impatrq/revcontrol/README.md

<p align="center"> 

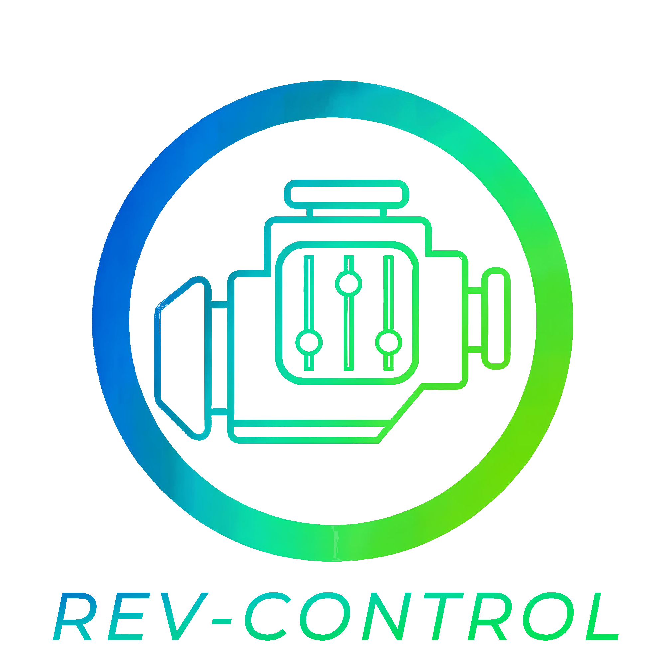
[picture p1: Imagenes/LOGO REV CONTROL OFICIAL2.png]
Logo REV CONTROL OFICIAL


</p>

## ¿QUE ES REV-CONTROL?
**REV-CONTROL ES UN BANCO DE PRUEBA PORTATIL DONDE SON TOMADOS LOS PARAMETROS DE UN MOTOR.**

## OBJETIVO
**EL OBJETIVO DE ESTE PROYECTO ES PRINCIPALMENTE DAR UNA ALTERNATIVA MAS ACCESIBLE PARA LOS TECNICOS. ESTO MEDIANTE NUESTRO SISTEMA DE AMPLIFICACION Y FILTRACION DE LA INFORMACION SENSADA Y POSTERIORMENTE PROCESADA DIGITALMENTE Y EXHIBIENDO LOS PARAMETROS LEIDOS EN UNA INTERFAZ AMIGABLE CON EL USUARIO** 

## UTILIDADES
**PUEDE MEDIR LOS SIGUIENTES PARAMETROS:**

**- REVOLUCIONES POR MINUTO**

**- PRESION Y TEMPERATURA DE ACEITE**

**- TEMPERATURA DE CABEZA DE CILINDRO**

**- TEMPERATURA DE AGUA**

**- % DE CONCENTRACION DE O2**

## VENTAJAS
**-TENER UNA MEJOR VISUALIZACION DE LOS PARAMETROS MENCIONADOS GRACIAS A LA INTERFAZ DIGITAL**

**-COMO METODO DE SEGURIDAD SE VA A INDICAR EN LA INTERFAZ CUANDO LOS PARAMETROS NO ESTEN EN ESTADO OPTIMO; ADEMAS EN EL DISPOSITIVO FISICO VAN A HABER INDICACIONES MEDIANTE INDICADORES COMO UN SEGUNDO METODO PARA ENTERARSE DE ESTOS FALLOS**

<div alig = "center">

| Email | Instagram | Página Web |
|---|---|---|
|revcontrol33@gmail.com|[@rev.control](https://www.instagram.com/rev.control/?next=%2F&hl=es)|[REV-CONTROL](https://impatrq.github.io/revcontrol/)

</div>

## INTEGRANTES
### MARTINEZ, MARCOS CALEB
- 📧 marcoscalebmartinez@gmail.com
- 📷 [marcoos_caleb](https://www.instagram.com/marcoos_caleb/)

### ACOSTA, GONZALO EMMANUEL
- 📧 gonza7.gea@gmail.com
- 📷 [gonzaa.acostaa](https://www.instagram.com/gonzaa.acostaa/)

### FLORES, SANTIAGO MARTIN
- 📧 santiflo06@gmail.com
- 📷 [santiflors_](https://www.instagram.com/santiflors_/)

### HE, LEONAREDO YU XING
- 📧 leonardohe295@gmail.com 
- 📷 [leoo_hee](https://www.instagram.com/leoo_hee/)

### IBACETA, TADEO EZEQUIEL
- 📧 tutibaceta@gmail.com
- 📷[tadeooibaceta](https://www.instagram.com/tadeooibaceta/)

### QUINTERO, JUAN 
- 📧 juanquinte2006@gmail.com
- 📷 [juann_quinte2](https://www.instagram.com/juann_quinte2/)

### ALFARO, LAUTARO NAHUEL
- 📧 lautialfaro6@gmail.com
- 📷 [lautaroalfaro14](https://www.instagram.com/lautaroalfaro14/)

## FOTO GRUPAL

<p align ="center"> 
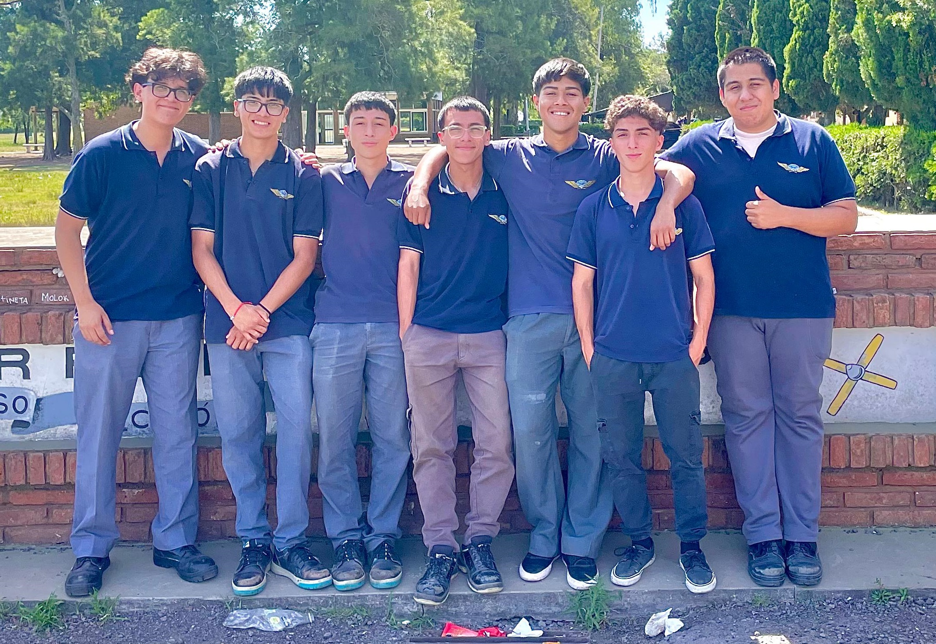
[picture p2: Imagenes/Integrantes.jpeg]
