impatrq/revcontrol/Diseños de marca/README.md

Diseños de Marca

Esta carpeta contiene los recursos visuales esenciales para la identidad de la marca.
Incluye los logos principales y sus variantes, diversos diseños gráficos como banners y mockups, así como fotografías oficiales de los integrantes del equipo, destinadas a materiales promocionales.
