impatrq/revcontrol/Electronica/README.md

Electrónica

Esta carpeta contiene toda la información y los recursos relacionados con los aspectos electrónicos del proyecto. Incluye circuitos, diagramas y diseños utilizados en el desarrollo, implementación y documentación de los sistemas electrónicos.
