impatrq/revcontrol/Estructura/README.md

Estructura

Esta carpeta alberga todos los recursos relacionados con la construcción y desarrollo físico del proyecto. Contiene planos detallados, fotos de materiales utilizados, imágenes que documentan el progreso realizado y fotografías de los prototipos desarrollados.
