impatrq/revcontrol/Estructura/Colocación de placas en los acrilicos/README.md

Colocamos las placas utilizando tornillos de 2mm, un soporte hecho en impresora 3D y para que no quede flojo le pusimos una tuerca
