impatrq/revcontrol/Documentación/Reuniones Diarias/Reunión diaria #17 revcontrol .docx

# Reunión diaria #17 - 19/06/2024

# Miembros presentes:

- ~~IBACETA, Tadeo Ezequiel~~
- FLORES, Santiago Martin ,
- QUINTERO, Juan
- ~~HE, Leonardo Yu xing~~
- ~~ALFARO,Lautaro Nahuel~~
- ~~ACOSTA, Gonzalo Emmanuel~~
- ~~MARTINEZ, Marcos Caleb~~

Disclaimer: Cada uno de los integrantes debe completar esto

# Trabajo actual


Disclaimer: Cada uno de los integrantes debe completar esto

# Expectativa del día:

1. ALFARO: desarrollo del programa de medición de RPM.
2. Martinez Marcos: Revisión de amplificador de termocupla
3. Ibaceta Tadeo Ezequiel: Agregar al código los cálculos de los distintos parámetros(Por el momento, los de temperatura).
4. He Leonardo Yu Xing: rehacer circuito de termocupla
5. Acosta: modificando diseño de aplicación.

# Observación:

Durante las anteriores semanas pudimos adaptar el programa para que lea los distintos canales de ADC.
