impatrq/revcontrol/Estructura/Modulo de lectura/Etiquetas para modulo de lectura.pdf

# CILINDRO 1

# CILINDRO 2

# CILINDRO 3

# CILINDRO 4

# TEMP. AGUA

# TEMP. ACEITE

# PRES. ACEITE

# SONDA LAMBDA

# CUENTA REVOLUCIONES

Etiqueta Técnica - REV Control

•Voltaje de Alimentación: 12V DC •Consumo Total: 803 mA
•Potencia Máxima: 9.98W
•Autonomía: 8.7 horas (con batería de 12V, 7Ah)
•Componentes Clave y Consumo:
•Circuito Comparador (LM311): 0.18W •Amplificador AD620: 0.72W •Módulo de Relevadores: 3.60W •Monitor Kinseal: 4.80W
•Microcontrolador LPC845: 0.165W Características adicionales: •Operación portátil y eficiente. •Sistema de alarmas integrado. •Interfaz gráfica con monitor táctil.
