impatrq/revcontrol/Electronica/Esquemas y Modelo 3D Incluido/Tablas de conexiones/Conexiones de Termistores.xlsx

Conexiones Termistor de agua A (MAX31865) |  |  | Conexiones Termistor de agua B (MAX31865) |  |  | Conexiones Termistor de aceite (MAX31865)
Pin de entrada | Pin de salida | Ubicación | Pin de entrada | Pin de salida | Ubicación | Pin de entrada | Pin de salida | Ubicación
RTD+ | Bornera | Termistor de agua B | RTD+ | Bornera | Termistor de agua A | RTD+ | Bornera | Termistor de aceite
RTD- | Bornera | Termistor de agua B | RTD- | Bornera | Termistor de agua A | RTD- | Bornera | Termistor de aceite
F+ | Bornera | Termistor de agua B | F+ | Bornera | Termistor de agua A | F+ | Bornera | Termistor de aceite
3v3 | 3.3V | Bornera 3.3 | 3v3 | 3.3V |  | 3v3 | 3.3V | Bornera 3.3
CLK | PIO0_18 | LPC845 | CLK | PIO0_18 | LPC845 | CLK | PIO0_18 | LPC845
SDO | PIO0_20 | LPC845 | SDO | PIO0_20 | LPC845 | SDO | PIO0_20 | LPC845
SDI | PIO0_21 | LPC845 | SDI | PIO0_21 | LPC845 | SDI | PIO0_21 | LPC845
CS | PIO0_01 | LPC845 | CS | PIO0_00 | LPC845 | CS | PIO0_04 | LPC845
GND | Masa | Bornera 3.3 | GND | Masa |  | GND | Masa | Bornera
