impatrq/revcontrol/Electronica/Esquemas y Modelo 3D Incluido/Tablas de conexiones/Conexiones de Termocuplas.xlsx

Conexiones Termocupla 1 (MAX6675) |  |  | Conexiones Termocupla 2 (MAX6675) |  |  | Conexiones Termocupla 3 (MAX6675) |  |  | Conexiones Termocupla 4 (MAX6675)
Pin de entrada | Pin de salida | Ubicación | Pin de entrada | Pin de salida | Ubicación | Pin de entrada | Pin de salida | Ubicación | Pin de entrada | Pin de salida | Ubicación
VCC | 5 V | Step Down | VCC | 5 V | Step Down | VCC | 5 V | Step Down | VCC | 5 V | Step Down
GND | Masa | Step Down | GND | Masa | Step Down | GND | Masa | Step Down | GND | Masa | Step Down
SO | PIO0_08 | LPC845 | SO | PIO0_08 | LPC845 | SO | PIO0_08 | LPC845 | SO | PIO0_08 | LPC845
SCK | PIO0_18 | LPC845 | SCK | PIO0_18 | LPC845 | SCK | PIO0_18 | LPC845 | SCK | PIO0_18 | LPC845
CS | PIO0_10 | LPC845 | CS | PIO0_19 | LPC845 | CS | PIO0_17 | LPC845 | CS | PIO0_13 | LPC845
T+ | Bornera | Termocupla positiva | T+ | Bornera | Termocupla positiva | T+ | Bornera | Termocupla positiva | T+ | Bornera | Termocupla positiva
T- | Bornera | Termocupla negativa | T- | Bornera | Termocupla negativa | T- | Bornera | Termocupla negativa | T- | Bornera | Termocupla negativa
