impatrq/revcontrol/Electronica/Esquemas y Modelo 3D Incluido/Tablas de conexiones/Conexiones LPC845.xlsx

Conexiones LPC845 BRK (Master)
Pin de entrada | Pin de salida | Ubicación
VDD | Batería (+) | Bornera de alimentación
GND | Batería (-) | Bornera de alimentación
PIO0_10 | CS | T1C
PIO0_19 | CS | T2C
PIO0_17 | CS | T3C
PIO0_13 | CS | T4C
PIO0_01 | CS | TCAA
PIO0_00 | CS | TCAB
PIO0_04 | CS | TC0
PIO0_17 | SO | Todas las Termocuplas y Termistores
PIO0_21 | SDI | Todas las Termocuplas y Termistores
PIO0_18 | SCK | Todas las Termocuplas y Termistores
PIO0_23 | OUT | Divisor de voltaje
PIO0_06 | OUT | Acondicionador de señal
PIO0_14 | OUT | Circuito comparador
PIO0_26 | IN 1 | Placa de relés (8 canales)
PIO0_27 | IN 2 | Placa de relés (8 canales)
PIO0_28 | IN 3 | Placa de relés (8 canales)
PIO0_29 | IN 4 | Placa de relés (8 canales)
PIO0_30 | IN 5 | Placa de relés (8 canales)
PIO0_31 | IN 6 | Placa de relés (8 canales)
PIO0_09 | IN 7 | Placa de relés (8 canales)
PIO0_15 | IN 8 | Placa de relés (8 canales)
PIO0_11 | IN 1 | Placade Rele ( 1 canal)
