impatrq/revcontrol/Electronica/Esquemas y Modelo 3D Incluido/Tablas de conexiones/CONEXIONES SENSOR DE PRESION DE ACEITE.xlsx

Componente | Pin/Terminal
Conector IN | 1 (+), 2 (IN), 3 (-)
Resistor R4 | Entre IN y RV2
Potenciómetro RV2 | Un terminal a GND, otro a R4
Salida PIO0_23 | Salida hacia PIO0_23
