impatrq/revcontrol/Electronica/Esquemas y Modelo 3D Incluido/Tablas de conexiones/CONEXIONES SENSOR RPM.xlsx

Componente | Pin/Terminal
LM311 (U2) | 8 (Vcc), 4 (GND), 3 (-), 2 (+), 1 (Salida)
Potenciómetro (POT) | Terminal 1: +5V, Terminal 2: Entrada no inversora (2 del LM311), Terminal 3: GND
Resistencia (R1) | Un extremo a GND, otro extremo a entrada no inversora (3 del LM311)
Resistencia (R2) | Terminal 1: +5V, Terminal 2: Colector del transistor
Resistencia (R3) | Un extremo conectado a PIO0_14, otro a GND
Diodo LED | Ánodo conectado a +5V, cátodo a entrada del regulador (U4)
Regulador (U4) | Pin 1 (IN): +5V, Pin 2 (OUT): Alimenta el circuito, Pin 3 (GND): Tierra
Transistor | Colector: Resistencia R2, Emisor: Tierra, Base: Salida de LM311
Entrada de señal | Terminal positivo y negativo: Terminales de entrada del LM311
