impatrq/revcontrol/Documentación/README.md

Documentación

Esta carpeta contiene toda la información relacionada con la gestión y operación del proyecto. Incluye reportes y documentos generados durante actividades en terreno, información técnica y especificaciones del proyecto, actas y resúmenes de reuniones diarias, así como archivos administrativos como presupuestos y otros registros importantes.
