impatrq/revcontrol/Pagina web/README.md

Página Web

Esta carpeta contiene los recursos utilizados en la creación de la página web, incluyendo los diseños de interfaz, modelos, texturas, y todo el código fuente (HTML, CSS, JavaScript y otros lenguajes relacionados).

Puedes acceder a la página web en el siguiente enlace: https://impatrq.github.io/revcontrol/.
