impatrq/revcontrol/Software Rev-Control/README.md

Software

Esta carpeta contiene toda la programación utilizada en el proyecto, desde el prototipo inicial hasta el código final. Incluye todos los archivos fuente, scripts, y cualquier otra pieza de código que haya sido parte del desarrollo del proyecto.
