impatrq/revcontrol/Documentación/Documentación técnica/Carpeta Tecnica Oficial - RevControl 18-11-24/main.tex

\documentclass[a4paper,12pt]{report}
% Paquetes necesarios para el documento
\usepackage{tikz}           % Para hacer diagramas
\usetikzlibrary{shapes.geometric, arrows.meta, positioning}
\usepackage{calc}           % Para realizar cálculos
\usepackage{float}          % Posición exacta de tablas e imágenes
\usepackage{hyperref}       % Enlaces dentro del PDF
\usepackage{pdfpages}       % Insertar PDFs
\usepackage{graphicx}       % Insertar gráficos e imágenes
\usepackage{tabularray}     % Tablas avanzadas
\usepackage{lscape}         % Páginas en orientación apaisada
\usepackage[spanish]{babel} % Configuración de idioma español
\usepackage{fancyhdr}       % Encabezados y pies de página
\usepackage{tocloft}        % Personalizar tabla de contenidos
\usepackage{setspace}       % Configurar espaciado
\usepackage{eso-pic}        % Insertar elementos de fondo
\usepackage{ragged2e}       % Control de alineación de texto
\usepackage{titlesec}       % Configuración de títulos de sección
\usepackage[table,xcdraw]{xcolor} % Colores avanzados
\usepackage{listings}       % Código fuente
\usepackage{rotating}       % Rotación de objetos
\usepackage[export]{adjustbox} % Ajuste de tamaño de imágenes
\usepackage{pdflscape}      % Orientación apaisada para algunas páginas
\usepackage{subcaption}     % Subfiguras
\usepackage{array}          % Tablas avanzadas
\usepackage{appendix}       % Apéndices
\usepackage{tabularx}       % Tablas con ancho fijo
\usepackage{enumitem}       % Listas personalizadas

% Definición de colores personalizados
\definecolor{celeste_rev}{HTML}{045bce}
\definecolor{verde_rev}{HTML}{52df28}
\definecolor{codeyellow}{rgb}{1,1,0}
\definecolor{codegreen}{rgb}{0,1,0}
\definecolor{codeblue}{rgb}{0.6,0.8,1}
\definecolor{backcolour}{rgb}{0.1,0.1,0.3}

% Configuración de hipervínculos
\hypersetup{
    colorlinks=true,
    linkcolor=celeste_rev,
    filecolor=red,
    urlcolor=verde_rev,
    pdftitle={Carpeta Técnica Rev-Control},
    pdfpagemode=FullScreen
}

% Definición del estilo para código fuente
\lstdefinestyle{mystyle}{
    backgroundcolor=\color{backcolour},
    commentstyle=\color{codegreen},
    keywordstyle=\color{codeyellow},
    numberstyle=\tiny\color{backcolour},
    stringstyle=\color{codeblue},
    basicstyle=\ttfamily\footnotesize\color{white},
    breaklines=true,
    captionpos=b,
    keepspaces=true,
    numbers=left,
    numbersep=5pt,
    showspaces=false,
    showstringspaces=false,
    showtabs=false,
    tabsize=2
}

\lstset{style=mystyle}

% Configuración de márgenes y encabezados
\usepackage[a4paper, margin=2.5cm]{geometry}
\pagestyle{fancy}
\fancyhf{}
\fancyhead[L]{Rev-Control}
\fancyhead[R]{\leftmark}
\fancyfoot[C]{\thepage}

% Formato de la tabla de contenidos
\renewcommand{\cftsecleader}{\cftdotfill{\cftdotsep}}

\begin{document}

% Imagen de fondo
\AddToShipoutPictureBG*{%
    \AtPageLowerLeft{%
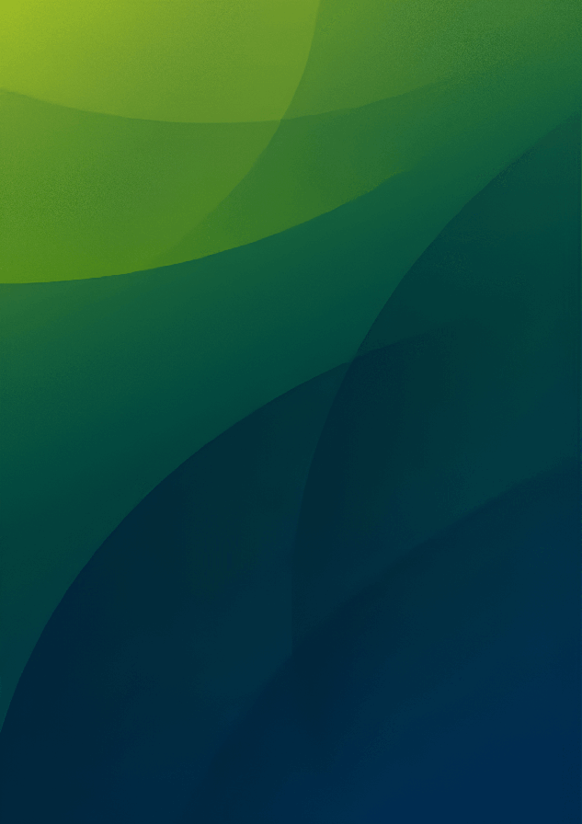
[picture p26: Documentación/Documentación técnica/Carpeta Tecnica Oficial - RevControl 18-11-24/Imagenes/fondo3214 (2).png]
        
    }
}

% Carátula del documento
\begin{titlepage}
    \centering
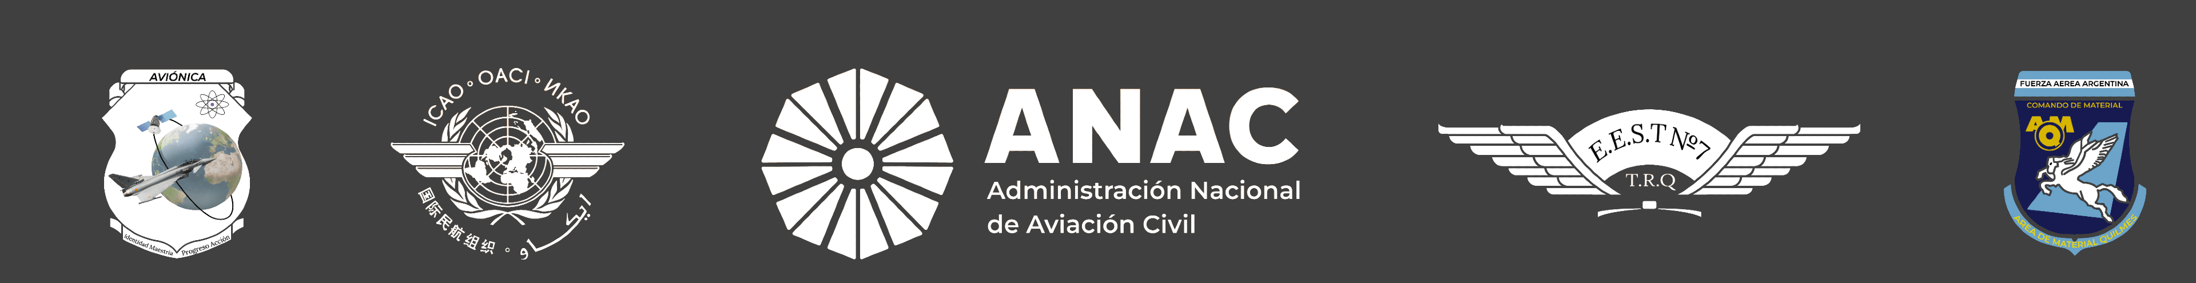
[picture p27: Documentación/Documentación técnica/Carpeta Tecnica Oficial - RevControl 18-11-24/Imagenes/logos2.png]
    
    \vspace{1cm}
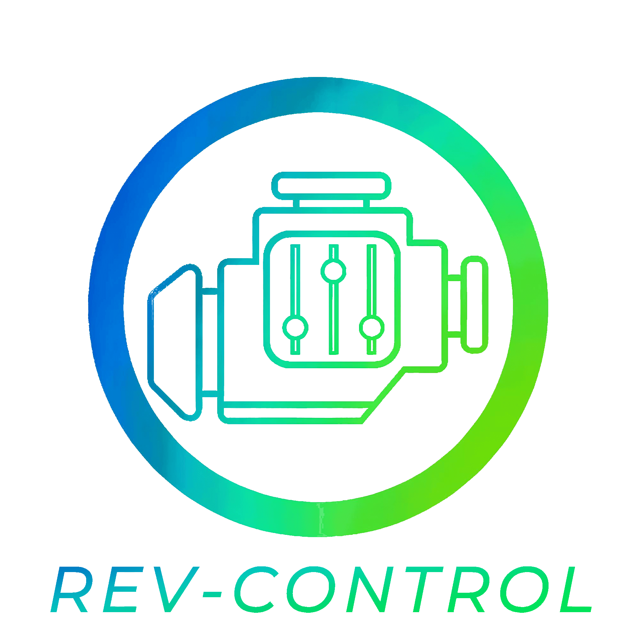
[picture p28: Documentación/Documentación técnica/Carpeta Tecnica Oficial - RevControl 18-11-24/Imagenes/LOGO REV CONTROL OFICIAL2.png]
    \\
    \vspace{1cm}
    {\Huge \textbf{\textcolor{celeste_rev}{Carpeta Técnica}}\\}
    \vspace{1cm}
    {\Large \textcolor{verde_rev}{Curso: 7° 1° Aviónica}}\\
    \vspace{0.5cm}
    {\Large \textcolor{celeste_rev}{Comisión: C}}\\
    \vspace{1cm}
    \textbf{\textcolor{celeste_rev}{Página web:}} \href{https://www.google.com/}{Link de acceso}\\
    \textbf{\textcolor{celeste_rev}{Trello:}} \href{https://trello.com/b/yDSPDlAp/kanban}{Link de acceso}\\
    \textbf{\textcolor{celeste_rev}{Github:}} \href{https://github.com/impatrq/revcontrol}{Link de acceso}\\
    \textbf{\textcolor{celeste_rev}{Redes Sociales:}} \href{https://www.instagram.com/rev.control/}{Link de acceso}\\
    \vfill
    \textbf{\textcolor{celeste_rev}{IMPA TRQ E.E.S.T N°7 2024}}\\
\end{titlepage}

% Tabla de contenidos
\tableofcontents
\newpage

% Inclusión de secciones
\include{Presentación}
\include{Introducción}
\include{Software}
\include{Sistema embebido}
\include{Electronica}
\include{Estructura}

% Apéndices
\begin{appendix}
   \include{Anexo-A Bloque/Anexo-A}
   \include{Anexo-B Bloque/Anexo-B}
\end{appendix}

\end{document}
