impatrq/revcontrol/Documentación/Documentación técnica/Carpeta Tecnica Oficial - RevControl 18-11-24/Presentación.tex

\chapter{Preámbulo}
    \section{Integrantes}
        \begin{table}[!ht]
            \begin{tblr}{c c}
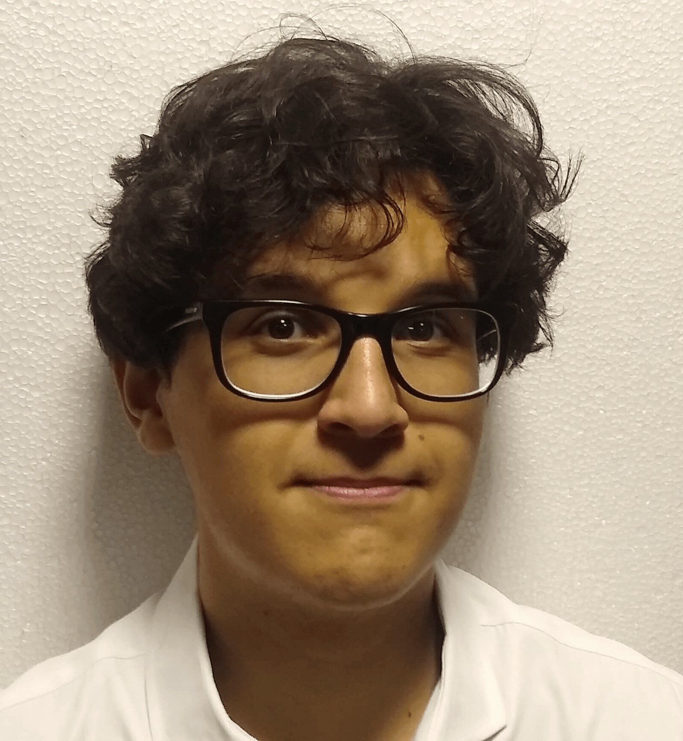
[picture p29: Documentación/Documentación técnica/Carpeta Tecnica Oficial - RevControl 18-11-24/Imagenes/Marcos.png]
                \SetCell[r=10]{}  
                & \SetCell[r=1]{l} MARCOS CALEB MARTINEZ
                &  \\ 
                &  \\
                & \SetCell[r=1]{l}DNI: 47.307.167
                & \\ 
                &  \\
                & \SetCell[r=1]{l}Mail: marcoscalebmartinez@gmail.com
                &  \\
                &  \\
                & \SetCell[r=1]{l}\includegraphics[width=0.5cm]
                {LinkedIN}\href{https://www.linkedin.com/in/fausto-alvarez-mollo/}{Linkedin}
                &  \\
                &  \\
                    & \SetCell[r=1]{l}Desarrollo de Esquematicos/Electronica y Documentacion
                &  \\ 
                &  \\
            \end{tblr}
        \end{table}
        \begin{table}[!ht]
            \begin{tblr}{c c}
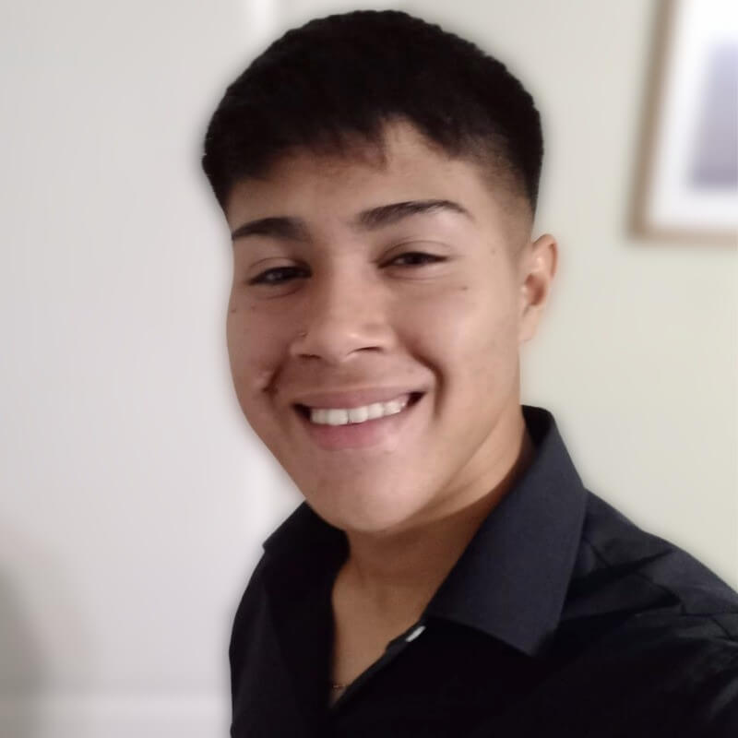
[picture p30: Documentación/Documentación técnica/Carpeta Tecnica Oficial - RevControl 18-11-24/Imagenes/ZALO.jpg]
                \SetCell[r=10]{}  
                & \SetCell[r=1]{l} GONZALO EMMANUEL ACOSTA
                &  \\ 
                &  \\
                & \SetCell[r=1]{l}DNI: 47.232.617
                & \\ 
                &  \\
                & \SetCell[r=1]{l}Mail: gonza7.gea@gmail.com  
                &  \\
                &  \\
                & \SetCell[r=1]{l}\includegraphics[width=0.5cm]
                {LinkedIN}\href{https://www.linkedin.com/in/gonzalo-acosta-28a5142a4/}{Linkedin}  
                &  \\
                &  \\
                    & \SetCell[r=1]{l}Desarrollo en Electronica 1
                &  \\ 
                &  \\
            \end{tblr}
        \end{table}
        \begin{table}[!ht]
                \begin{tblr}{c c}
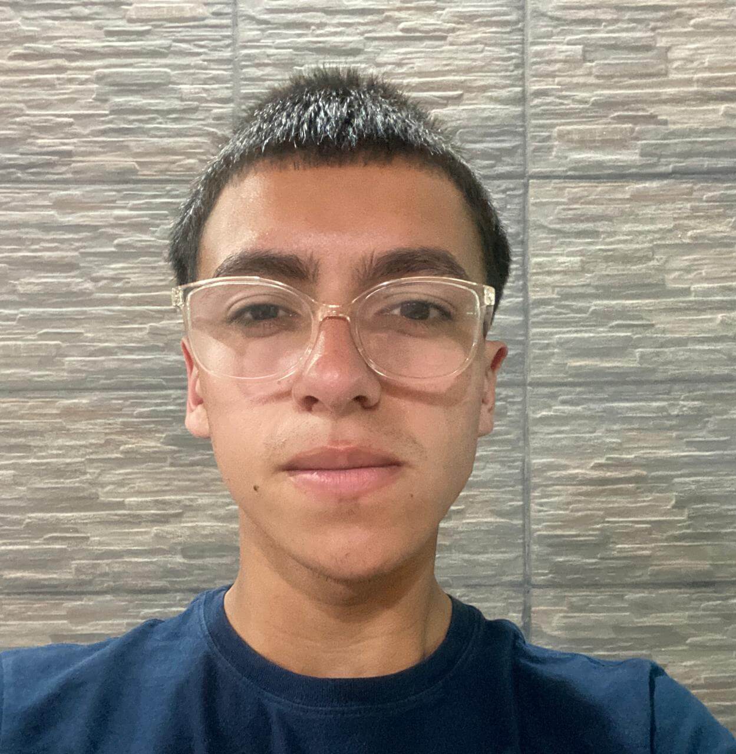
[picture p31: Documentación/Documentación técnica/Carpeta Tecnica Oficial - RevControl 18-11-24/Imagenes/Santiago.jpeg]
                    \SetCell[r=10]{}  
                    & \SetCell[r=1]{l} SANTIAGO MARTIN FLORES
                    &  \\ 
                    &  \\
                    & \SetCell[r=1]{l}DNI: 47.307.145
                    & \\ 
                    &  \\
                    & \SetCell[r=1]{l}Mail: santiflo06@gmail.com  
                    &  \\
                    &  \\
                    & \SetCell[r=1]{l}\includegraphics[width=0.5cm]
                    {LinkedIN}\href{https://www.linkedin.com/in/santiago-flores-417895302}{Linkedin}  
                    &  \\
                    &  \\
                    & \SetCell[r=1]{l}Administración de redes
                    &  \\ 
                    &  \\
                \end{tblr}
            \end{table}
            \newpage
            \begin{table}[!ht]
                \begin{tblr}{c c}
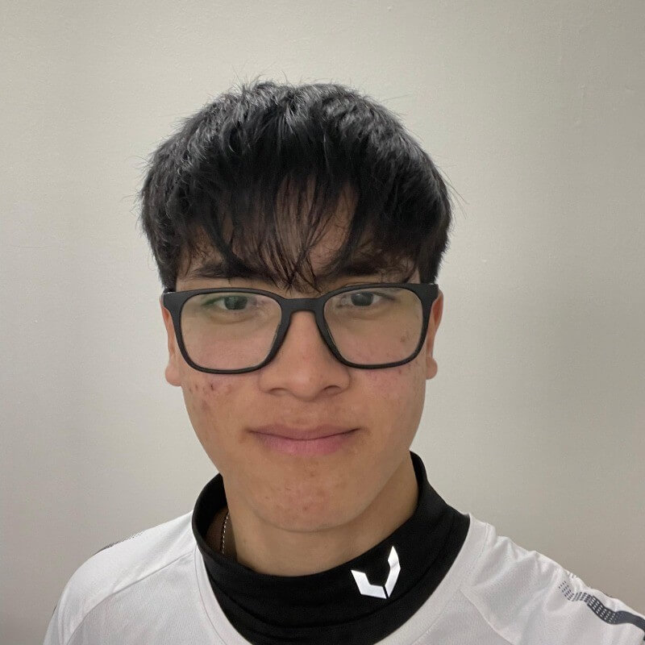
[picture p32: Documentación/Documentación técnica/Carpeta Tecnica Oficial - RevControl 18-11-24/Imagenes/LEO.jpg]
                    \SetCell[r=10]{}  
                    & \SetCell[r=1]{l} LEONARDO YU XING HE
                    &  \\ 
                    &  \\
                    & \SetCell[r=1]{l}DNI: 46.980.538
                    & \\ 
                    &  \\
                    & \SetCell[r=1]{l}Mail: leonardohe295@gmail.com  
                    &  \\
                    &  \\
                    & \SetCell[r=1]{l}\includegraphics[width=0.5cm]
                    {LinkedIN}\href{https://www.linkedin.com/in/leonardohe446/}{Linkedin}
                    &  \\
                    &  \\
                        & \SetCell[r=1]{l}Desarrollo de Electrónica 2
                    &  \\ 
                    &  \\
                \end{tblr}
            \end{table}
            \begin{table}[!ht]
                \begin{tblr}{c c}
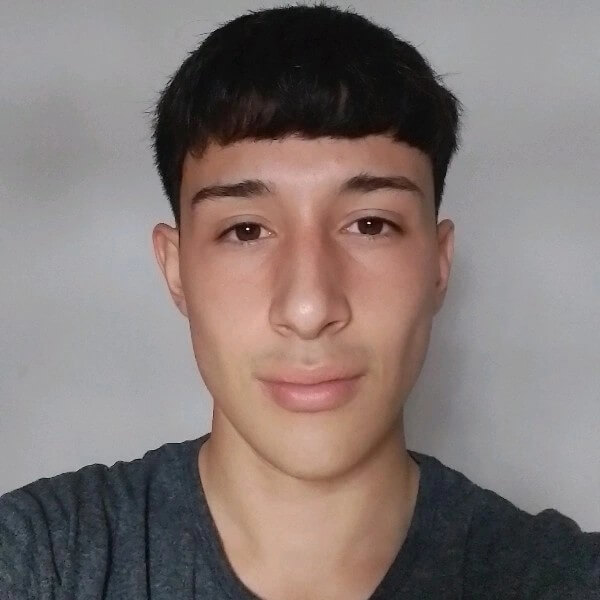
[picture p33: Documentación/Documentación técnica/Carpeta Tecnica Oficial - RevControl 18-11-24/Imagenes/TADE.jpg]
                    \SetCell[r=10]{}  
                    & \SetCell[r=1]{l} TADEO EZEQUIEL IBACETA
                    &  \\ 
                    &  \\
                    & \SetCell[r=1]{l}DNI: 47.337.265
                    & \\ 
                    &  \\
                    & \SetCell[r=1]{l}Mail: tutibaceta@gmail.com  
                    &  \\
                    &  \\
                    & \SetCell[r=1]{l}\includegraphics[width=0.5cm]
                    {LinkedIN}\href{https://www.linkedin.com/in/tadeo-ibaceta/}{Linkedin}  
                    &  \\
                    &  \\
                        & \SetCell[r=1]{l}Desarrollo de Software 
                    &  \\ 
                    &  \\
                \end{tblr}
            \end{table}
            \begin{table}[!ht]
                \begin{tblr}{c c}
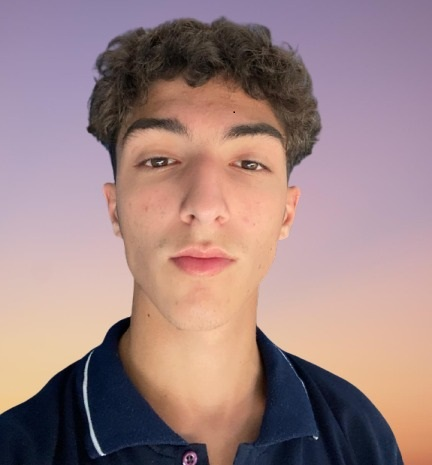
[picture p34: Documentación/Documentación técnica/Carpeta Tecnica Oficial - RevControl 18-11-24/Imagenes/quinte.jpg]
                    \SetCell[r=10]{}  
                    & \SetCell[r=1]{l} JUAN QUINTERO
                    &  \\ 
                    &  \\
                    & \SetCell[r=1]{l}DNI: 47.256.604
                    & \\ 
                    &  \\
                    & \SetCell[r=1]{l}Mail: juanquinte2006@gmail.com  
                    &  \\
                    &  \\
                    & \SetCell[r=1]{l}\includegraphics[width=0.5cm]
                    {LinkedIN}\href{https://www.linkedin.com/in/juanquintero-/}{Linkedin}  
                    &  \\
                    &  \\
                        & \SetCell[r=1]{l}Desarrollo de Estructura
                    &  \\ 
                    &  \\
                \end{tblr}
            \end{table}
            \begin{table}[!ht]
                \begin{tblr}{c c}
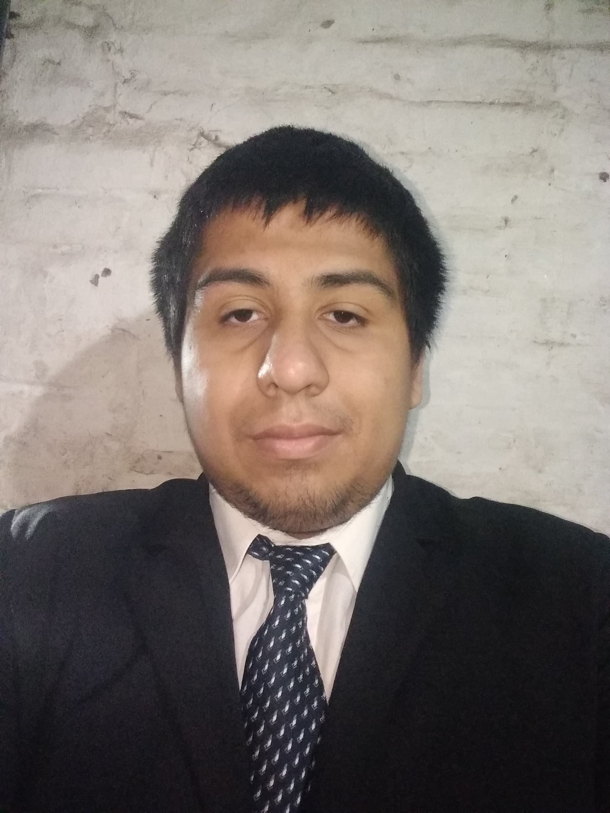
[picture p35: Documentación/Documentación técnica/Carpeta Tecnica Oficial - RevControl 18-11-24/Imagenes/alfaro.jpeg]
                    \SetCell[r=10]{}  
                    & \SetCell[r=1]{l} LAUTARO NAHUEL ALFARO
                    &  \\ 
                    &  \\
                    & \SetCell[r=1]{l}DNI: 46.699.206
                    & \\ 
                    &  \\
                    & \SetCell[r=1]{l}Mail: lautialfaro6@gmail.com  
                    &  \\
                    &  \\
                    & \SetCell[r=1]{l}\includegraphics[width=0.5cm]
                    {LinkedIN}\href{https://www.linkedin.com/in/lautaro-alfaro-8a261b300/}{Linkedin}  
                    &  \\
                    &  \\
                        & \SetCell[r=1]{l}Desarrollo de Página Web y Aplicacion
                    &  \\ 
                    &  \\
                \end{tblr}
            \end{table}

        \newpage

    \section{Foto Grupal}

        % Espacio reservado para la foto grupal
        \begin{figure}[H]
            \centering
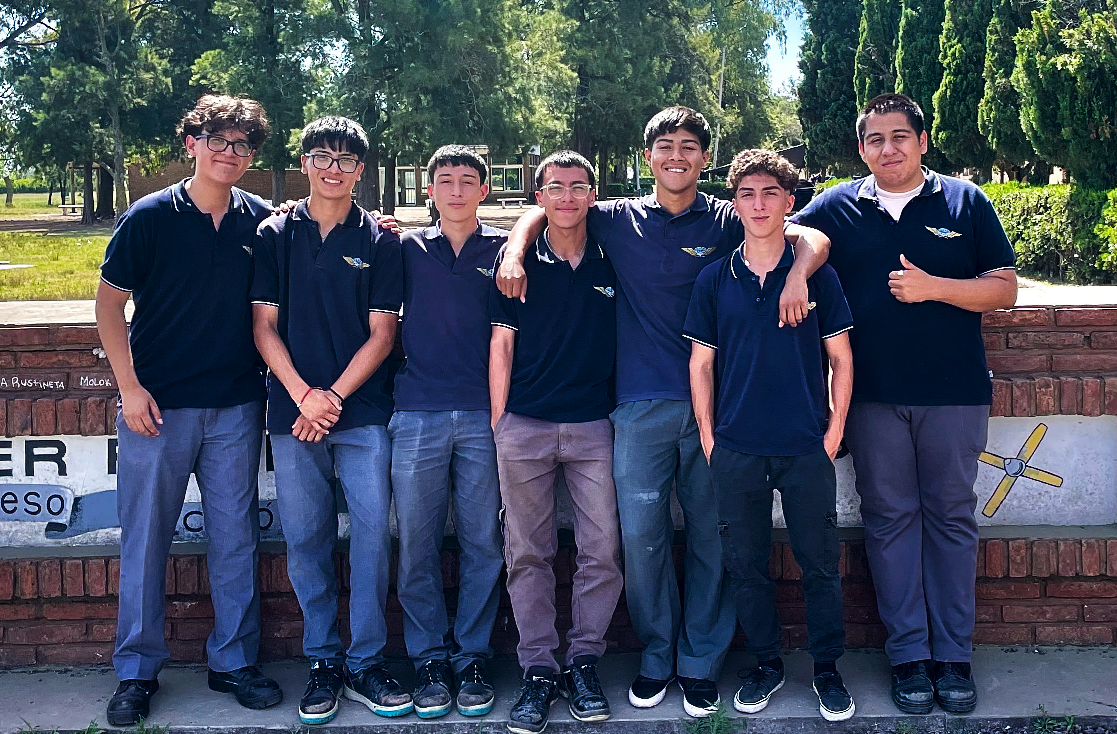
[picture p36: Documentación/Documentación técnica/Carpeta Tecnica Oficial - RevControl 18-11-24/Imagenes/foto grupal.png]
             % Reemplaza con la ruta de la imagen
            \caption{Foto grupal del equipo}
        \end{figure}
    
    \section{Horas dedicadas por cada integrante (registro personal)}

   \begin{table}[H]
    \centering
    \begin{tabular}{|c|c|}
        \hline
        \textbf{Integrante} & \textbf{Horas dedicadas (personal)}\\
        \hline
        Marcos Caleb Martinez & 268 \\ % Espacio de 2 cm
        \hline
        Gonzalo Emmanuel Acosta & 256  \\ 
        \hline
        Santiago Martin Flores & 244  \\ 
        \hline
        Leonardo Yu Xing He & 244  \\ 
        \hline
        Tadeo Ezequiel Ibaceta & 256  \\ 
        \hline
        Juan Quintero & 260 \\ 
        \hline
        Lautaro Nahuel Alfaro & 128\\ 
        \hline
    \end{tabular}
    \caption{Horas dedicadas por cada integrante}
    \end{table}

    \begin{table}[H]
    \centering
    \begin{tabular}{|c|c|}
        \hline
        \textbf{Horas totales} & 1656\\
        \hline
    \end{tabular}
    \caption{Horas totales del equipo}
    \end{table}
