impatrq/revcontrol/Documentación/Documentación técnica/Carpeta Tecnica Oficial - RevControl 18-11-24/Anexo-B Bloque/Anexo-B.tex

\chapter{Apéndice B: Documentación-ROTAX}
    La información presentada aquí es el certificado de Aeronavegabilidad y documentación técnica del motor trabajado en este proyecto (Motor ROTAX 912 ULS). Para presentar la bases de información que utilizamos para este proyecto respecto a los parámetros. A continuación se va adjuntar las fuentes de adquisición de dichos documentos y fragmentos de estos mismos:
    
\begin{itemize}
    \item Certificado de Aeronavegabilidad: 
    \hyperlink{certificado-aeronavegabilidad}{-Salto a página-}
    \href{https://www.seguridadaerea.gob.es/sites/default/files/HD%20TC286-I%20r8.pdf}{www.seguridadaerea.gob.es}
    \hfill
     % Enlace directo a la primera página del certificado
    
    \item Documentación Técnica:
    \href{https://www.flyrotax.com/p/service/technical-documentation}{www.flyrotax.com} 

    \begin{itemize}
        \item SERVICE INSTRUCTION - PAC (Pag. 8) 
        \hyperlink{service-instruction-pag8}{-Salto a página-} % Enlace directo a la página 8 en el documento
    \end{itemize}

    \begin{itemize}
        \item MAINTENANCE MANUAL LINE (Pag. 89-90,91-92,88,100,101-103)
        \hyperlink{maintenance-manual-pag91-92}{-Salto a página-} % Enlace directo a la página 91-92 en el documento
    \end{itemize}

    \begin{itemize}
        \item OPERATORS MANUAL LINE (Pag. x)(Pag. 28-29,32)
        \hyperlink{operators-manual1}{-Salto a página-} 
    \end{itemize}

    \begin{itemize}
        \item USER MANUAL (Pag. 35-37) 
        \hyperlink{user-manual}{-Salto a página-} 
    \end{itemize}

    \begin{itemize}
        \item INSTALLATION MANUAL (Pag. 157-158) 
        \hyperlink{manual de instalacion}{-Salto a página-} 
    \end{itemize}
\end{itemize}

% Insertar el PDF completo a continuación de la descripción
\begin{landscape}
    \includepdf[pages=1-2, scale=0.9, pagecommand={\hypertarget{certificado-aeronavegabilidad}{}}]{Anexo-B Bloque/HD TC286-I r8.pdf}
\end{landscape}

\begin{landscape}
    \includepdf[pages=6, scale=0.9, pagecommand={\hypertarget{service-instruction-pag8}{}}]{Anexo-B Bloque/SI-PAC-027.pdf}
\end{landscape}

\begin{landscape}
    \includepdf[pages={89-90,91-92,88,100,101,102,103}, scale=0.9, pagecommand={\hypertarget{maintenance-manual-pag91-92}{}}]{Anexo-B Bloque/Maintenance Manual Line for Engine Type 912 Series Edition 4 Revision 1.pdf}
\end{landscape}

\begin{landscape}
    \includepdf[pages={28-29,32}, scale=0.9, pagecommand={\hypertarget{operators-manual1}{}}]{Anexo-B Bloque/OM_912 Series_ED4_R1.pdf}
\end{landscape}

\begin{landscape}
    \includepdf[pages={35-37,28}, scale=0.9, pagecommand={\hypertarget{user-manual}{}}]{Anexo-B Bloque/Manual_Usuario_912.pdf}
\end{landscape}

\begin{landscape}
    \includepdf[pages={157-158}, scale=0.9, pagecommand={\hypertarget{manual de instalacion}{}}]{Anexo-B Bloque/IM_912_Series_Ed3_R0.pdf}
\end{landscape}
