impatrq/revcontrol/Documentación/Reuniones Diarias/Reunión diaria #22 revcontrol.docx

# Reunión diaria #22 - 03/07/2024

# Miembros presentes:

- ~~IBACETA, Tadeo Ezequiel~~
- ~~FLORES, Santiago Martin ,~~
- ~~QUINTERO, Juan~~
- ~~HE, Leonardo Yu xing~~
- ~~ALFARO,Lautaro Nahuel~~
- ~~ACOSTA, Gonzalo Emmanuel~~
- ~~MARTINEZ, Marcos Caleb~~

Disclaimer: Cada uno de los integrantes debe completar esto

# Trabajo actual


Disclaimer: Cada uno de los integrantes debe completar esto

# Expectativa del día:

1. FLORES, Santiago: se siguen con la aplicación Bluetooth.
2. IBACETA, Tadeo Ezequiel: Arrancar con el código del Bluetooth.
3. He,Leonardo Yu Xing: diseño de PCB.
4. ALFARO,Lautaro: programar la página web
5. Martinez Marcos: Diseño de amplificador de sensor de presión
6. Acosta: Seguimos con la app.
7. Quintero: Mejorar la sección de integrantes de ig y de la página web

# Observación:
