impatrq/revcontrol/Documentación/Reuniones Diarias/Reunión diaria #10 revcontrol .docx

# Reunión diaria #10 - 13/05/2024

# Miembros presentes:

- ~~IBACETA, Tadeo Ezequiel~~
- ~~FLORES, Santiago Martin ,~~
- ~~QUINTERO, Juan~~
- HE, Leonardo Yu xing
- ALFARO,Lautaro Nahuel
- ~~ACOSTA, Gonzalo Emmanuel~~
- ~~MARTINEZ, Marcos Caleb~~

Disclaimer: Cada uno de los integrantes debe completar esto

# Trabajo actual


Disclaimer: Cada uno de los integrantes debe completar esto

# Expectativa del día:

1. Martínez M: Terminar lista de compras
2. Flores: investigación sobre la aplicación
3. Acosta: ultimando detalles sobre interfaz de página web e investigación de aplicación.
4. Ibaceta: Investigar sobre transductor de presión para medir la presión de aceite, y terminar diagrama en bloques de la programación del mismo.
5. Quintero: Terminar lista de compras y página web

# Observación:
