impatrq/revcontrol/Documentación/Reuniones Diarias/Reunión diaria #07 revcontrol .docx

# Reunión diaria #07 - 26/04/2024

# Miembros presentes:

- ~~IBACETA, Tadeo Ezequiel~~
- ~~FLORES, Santiago Martin ,~~
- ~~QUINTERO, Juan~~
- ~~HE, Leonardo Yu xing~~
- ~~ALFARO,Lautaro Nahuel~~
- ~~ACOSTA, Gonzalo Emmanuel~~
- ~~MARTINEZ, Marcos Caleb~~

Disclaimer: Cada uno de los integrantes debe completar esto

# Trabajo actual


Disclaimer: Cada uno de los integrantes debe completar esto

# Expectativa del día:

1. Martinez: Terminar historias de usuario
2. Alfaro: terminar con el código de pruebas de temperatura, para el LPC845.
3. He: Ir a comprar el LPC845 Electrocomponentes S.A
4. Flores: Ir a comprar el LPC 845 a Electrocomponentes S.A
5. Acosta: Interfaz de la página web.
6. Quintero: reunión de marketing, pitch elevator y administración de redes sociales
7. Ibaceta: Ir a comprar el LPC845 a Electrocomponentes S.A

Disclaimer: Cada uno de los integrantes

debe completar esto

Tiene que seguirse la siguiente estructura, por ejemplo:

1. Progresar con lo realizado en Solidworks de las partes y las articulaciones en 3D
a. HU001H6F -> Galotto - Actuador Profundidad del asiento
b. HU001H6G -> Sanjurjo- Actuador de los apoyabrazos

# Observación:
