impatrq/revcontrol/Electronica/Circuitos/Rev- Control Version 2.4 Parte 2.pdf

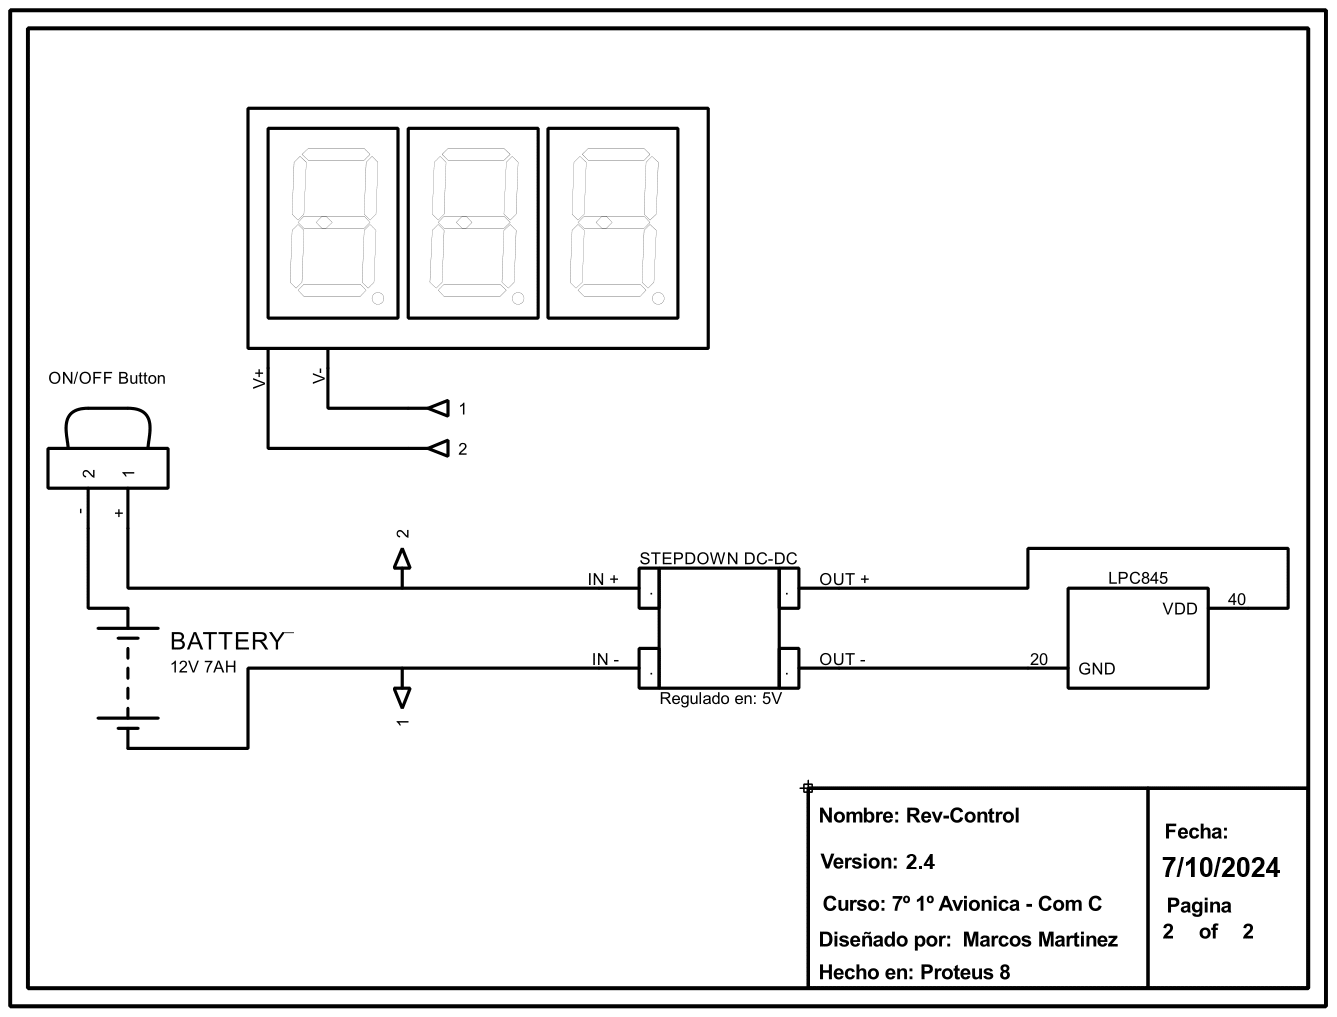
[picture p37: page 1]
