impatrq/revcontrol/Electronica/Circuitos/Rev- Control Version1.pdf

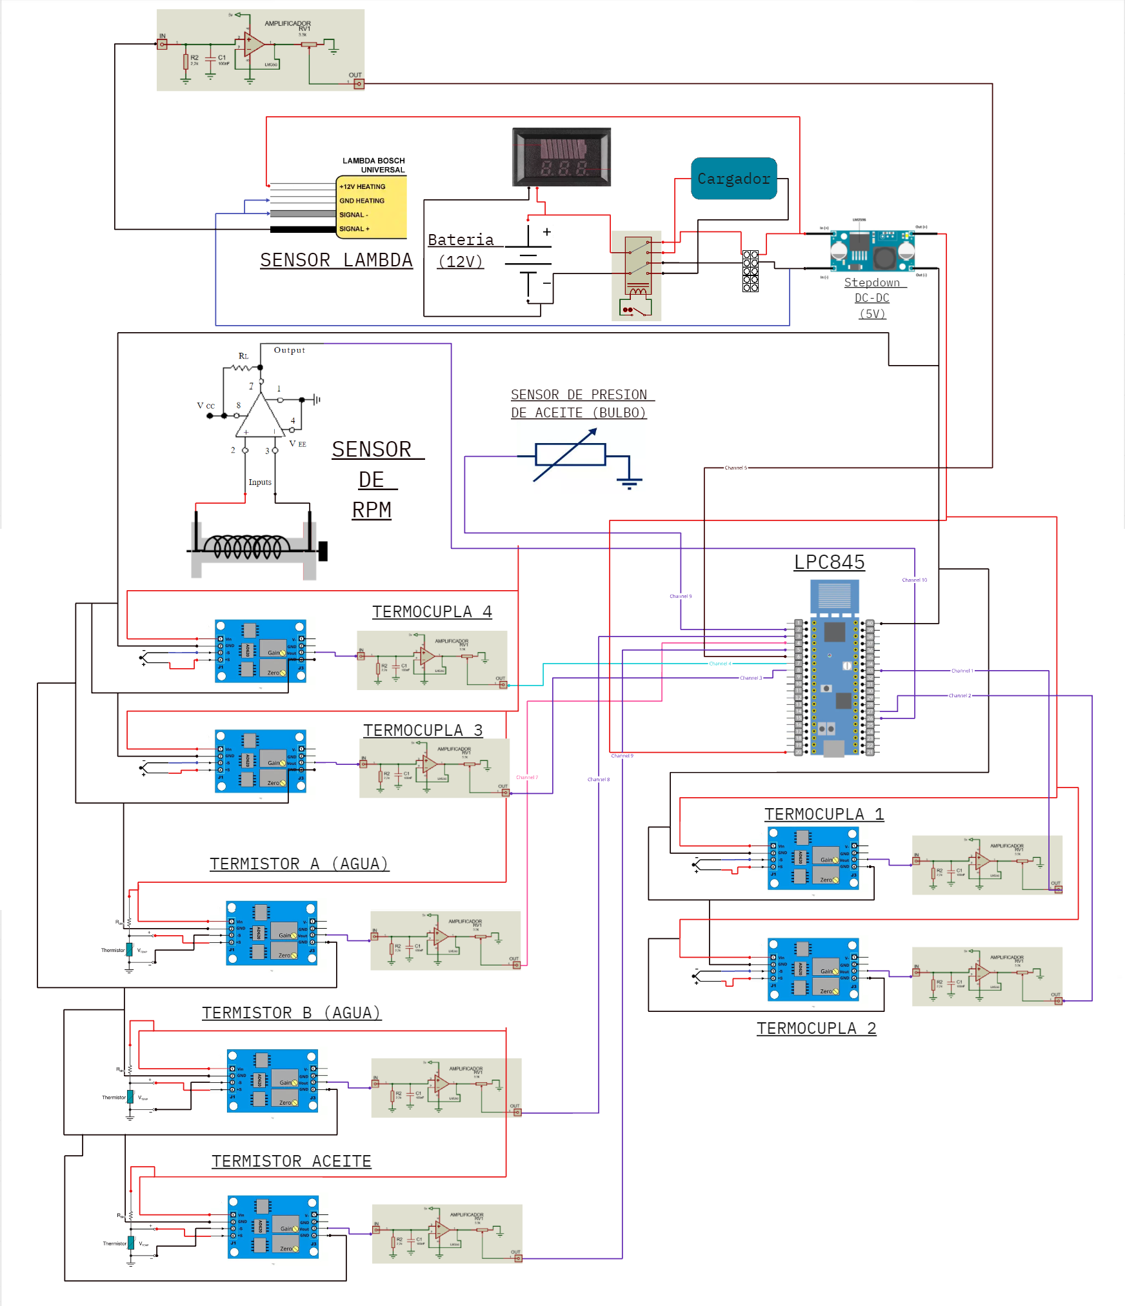
[picture p38: page 1]
