impatrq/revcontrol/Documentación/Documentación técnica/Documentación_del_monitor_y_su_software.pdf

## Documentación del monitor Kinseal y su software

Alfaro, Lautaro

Rev-Control

# Índice general

1. Introducción | 2
2. Desarrollo de la interfaz | 3
2.3. Conociendo Kinseal Studio y la creación de un nuevo proyecto . | 4
2.4. Como usar cada uno de los elementos para la creacion de una
3. Protocolo de comunicación | 23
3.3. Read Discrete Inputs/Lectura de entradas discretas (Command
3.4. Read Holding Registers/Leer registros de retención (Command
3.5. Input Registers/Lectura de registros de entrada (Command Co-
3.6. Write Single Coil/Escribir bobina simple (Command Code: 0x05) 27
3.7. Write Single Register/Escribir registro único (Command Code:
3.8. intentos de comunicacion con el monitor a traves del prtocolo

1

# Capítulo 1

# Introducción

Este es el informe respecto a la configuración del Monitor Kinseal en el Proyecto Rev-Control. Se brindará toda la información utilizada durante el trabajo, incluyendo problemas y soluciones previas, así como los pendientes. También se proporcionará información útil para trabajar con el monitor.

2

# Capítulo 2

# Desarrollo de la interfaz

Para configurar el monitor Kinseal, es necesario seguir varios pasos y conocer ciertos aspectos clave.

## 2.1. ¿Qué es un monitor de Kinseal?

El monitor utilizado es un Kinseal Modelo AMZ070W01RAGD, un dispositivo de tipo HMI (Human Machine Interface).

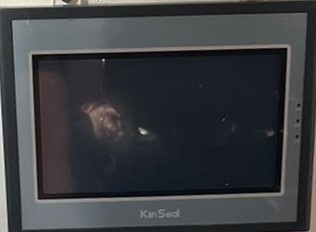
[picture p39: figure]

Figura 2.1: Monitor Kinseal Modelo AMZ070W01RAGD.

El monitor es táctil e interactivo, con varias características:
- Dimensiones: 149 mm de alto, 203 mm de largo, 38 mm de ancho. - Puerto

3

Micro-USB. - Entrada tipo DVI con conexiones para (232, 422, 485) COM1. -Entrada USB. - Puerto SD. - Puerto serial 232 COM2. - HMI tipo Master.

## 2.2. Manuales e información de hardware

A continuación, se listan los manuales y páginas de referencia:

Manual básico en inglés: Manual en inglés. (https://github.com/impatrq/revcontrol/tree/main/Interfaz/documentos)

Manual básico en chino: Manual en chino. (https://github.com/impatrq/revcontrol/tree/main/Interfaz/documentos)

Página oficial en chino mandarín: http://www.kinseal.com/bg=sy.

Página oficial en inglés: https://www.kinsealhmi.com/.

Página oficial en español: https://es.kinsealhmi.com/.

## 2.3. Conociendo Kinseal Studio y la creación de un nuevo proyecto

Para configurar un programa en el monitor Kinseal, primero se debe descargar Kinseal Studio desde la página oficial. (https://es.kinsealhmi.com/download)

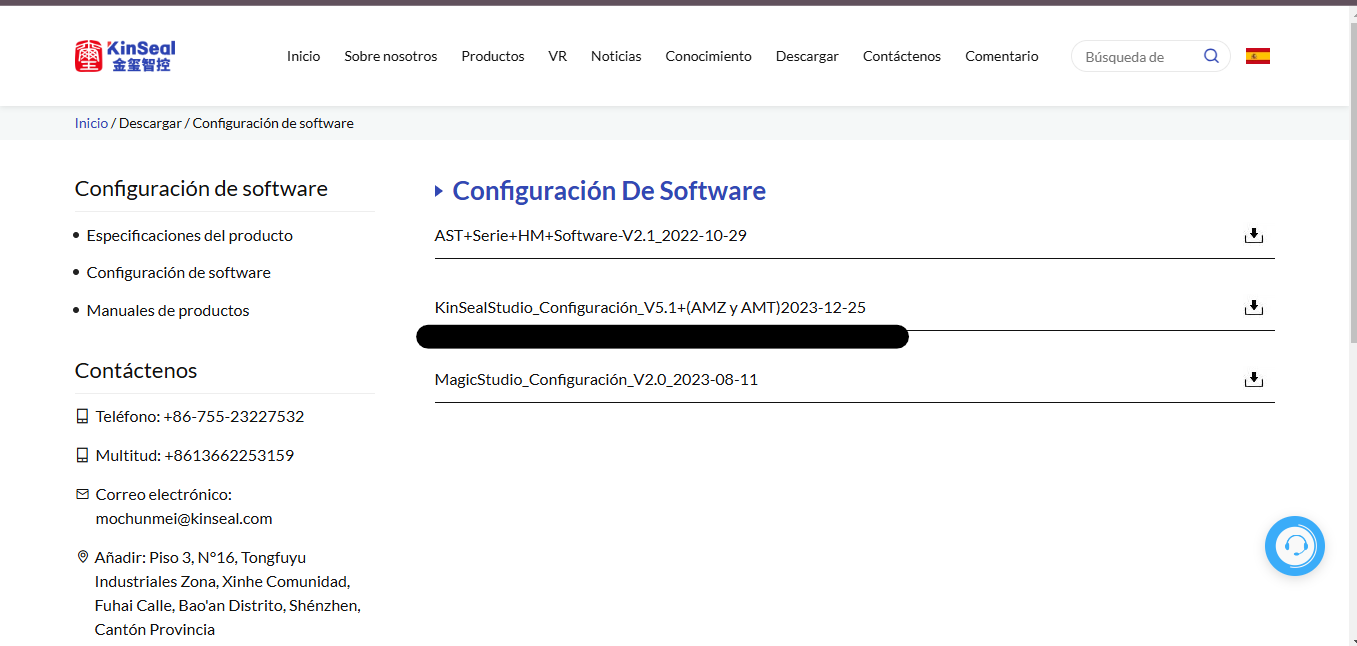
[picture p40: figure]

Figura 2.2: Descarga del archivo subrayado.

Una vez descargado, este será el software de Kinseal Studio:

4

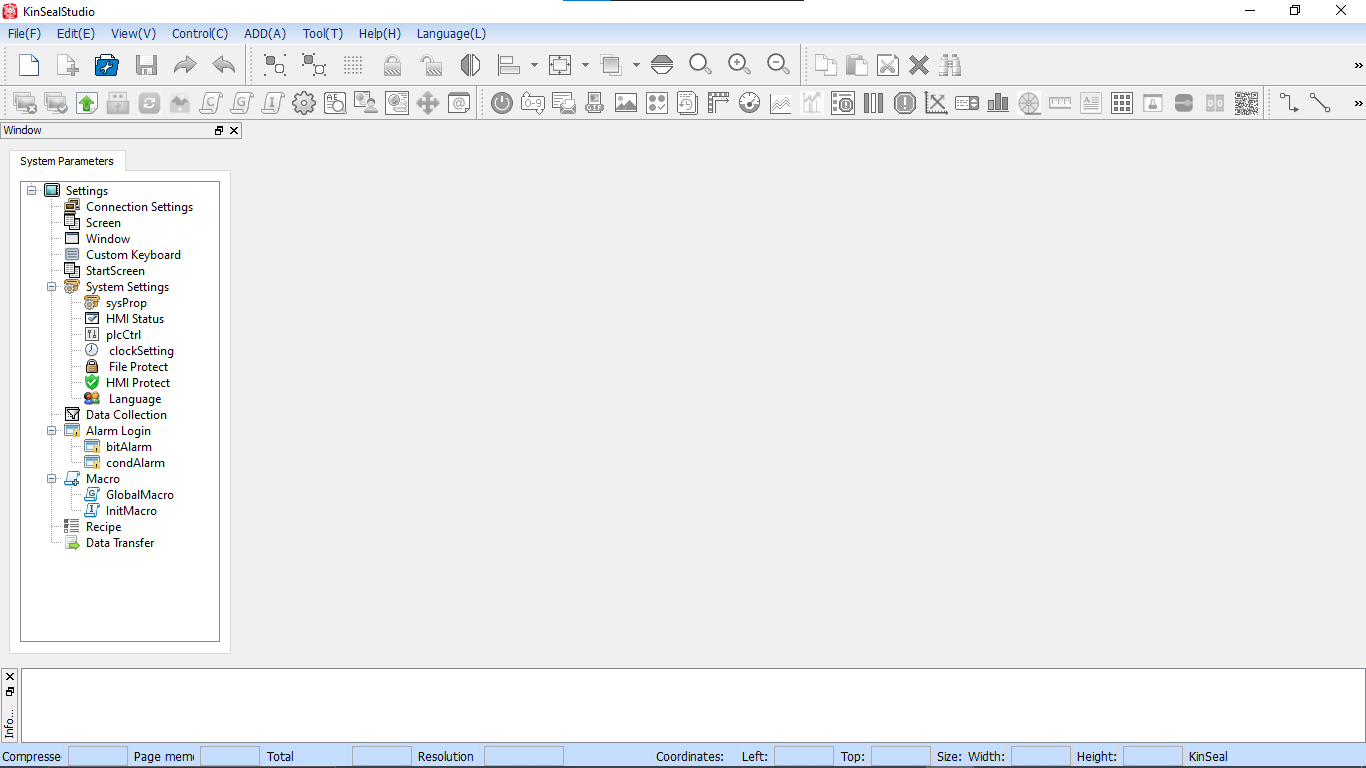
[picture p41: figure]

Figura 2.3: Interfaz principal de Kinseal Studio.

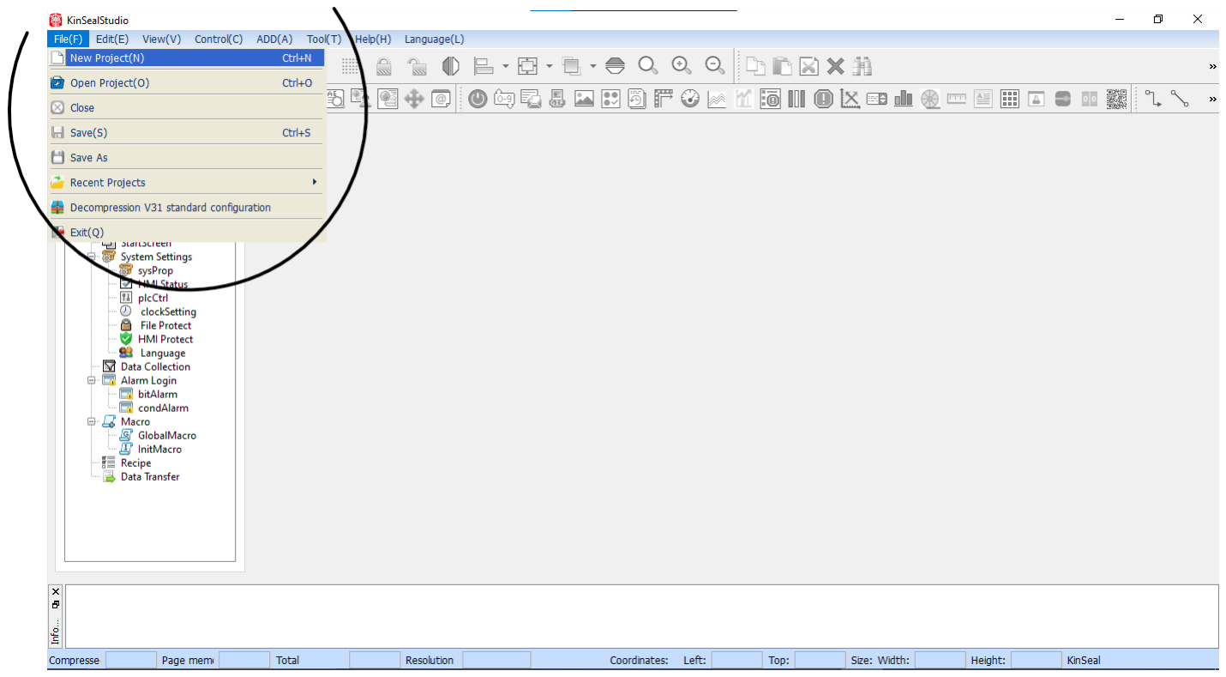
[picture p42: figure]

Figura 2.4: Paso 1: Seleccionar la sección "Files ²

hacer clic en "New Project".

5

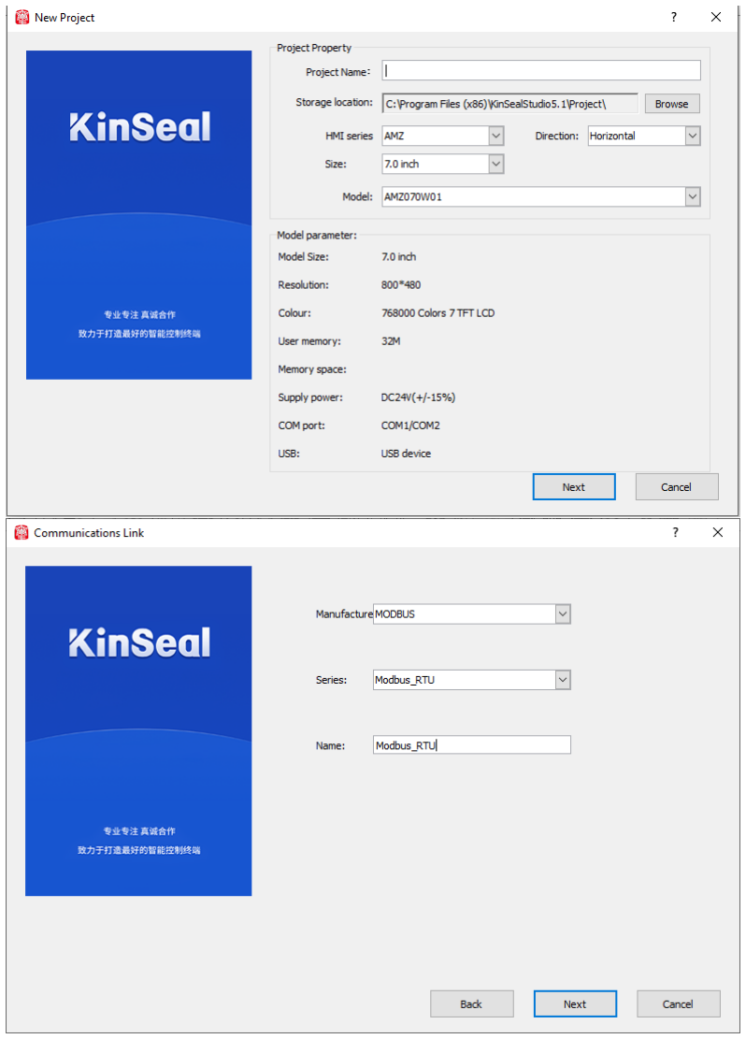
[picture p43: figure]

Figura 2.5: Paso 2: Configurar las características del monitor, asignar un nombre y seleccionar "Next".

6

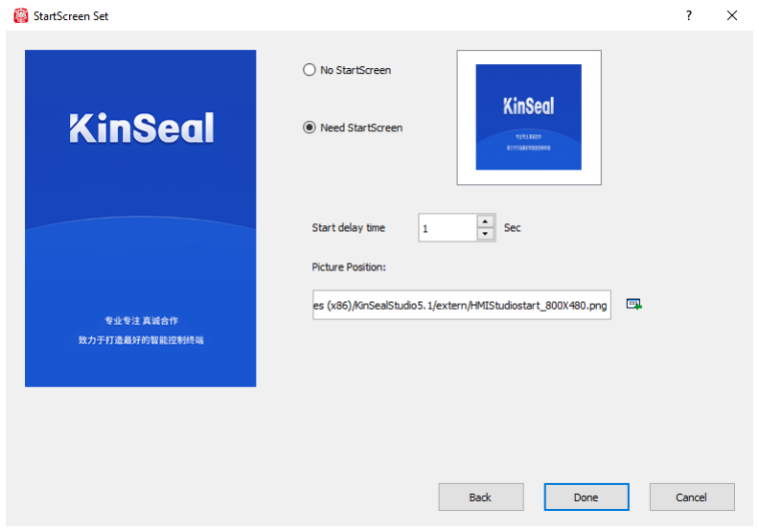
[picture p44: figure]

Figura 2.6: Paso 3: Seleccionar la pantalla de inicio (puede ser cualquier imagen).

7

## 2.4. Como usar cada uno de los elementos para la creacion de una interfaz

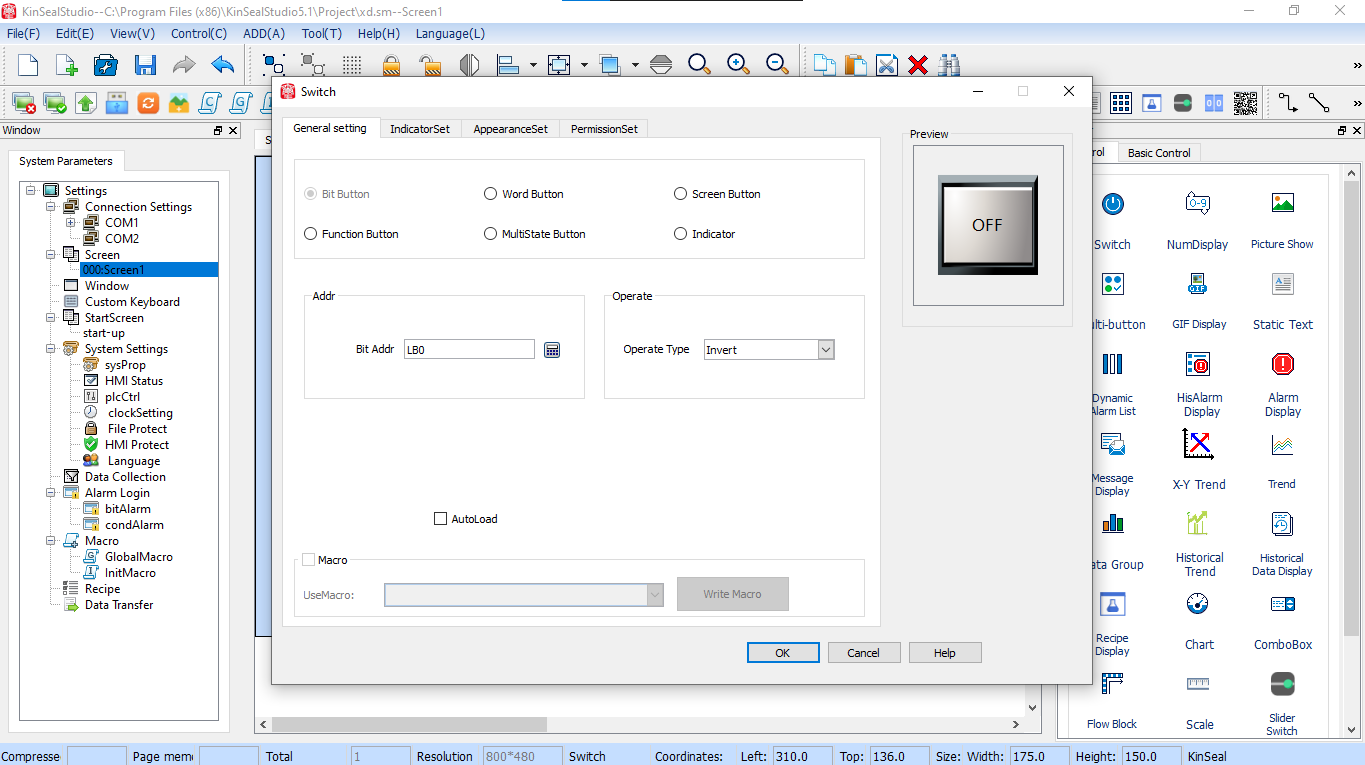
[picture p45: figure]

Figura 2.7: Ejemplo de configuración de elementos en Kinseal Studio.

-Bit Button: El Bit Button se puede utilizar para operar y mostrar el estado de encendido/apagado de la dirección de bit o el estado 1/0 del dispositivo conectado a la pantalla táctil. El botón de bit es el control más básico y comúnmente utilizado.
-Word Button:El Word Button puede configurar operaciones de constante, ingreso de valor, ingreso de contraseña, adición de valor, sustracción de valor y suma y resta de números del registro.
-Function Button: El Function Button es un control muy importante en toda la pantalla táctil, a través del botón de función puede ser muy conveniente y rápido lograr hacer y configurar varios requisitos funcionales.
-Indicattor: El Indicator se puede utilizar para monitorear el estado de EN-CENDIDO/APAGADO del contacto de bit del equipo conectado y mostrar el estado del contacto de bit con el estado de ENCENDIDO/APAGADO correspondiente en la pantalla táctil.

8

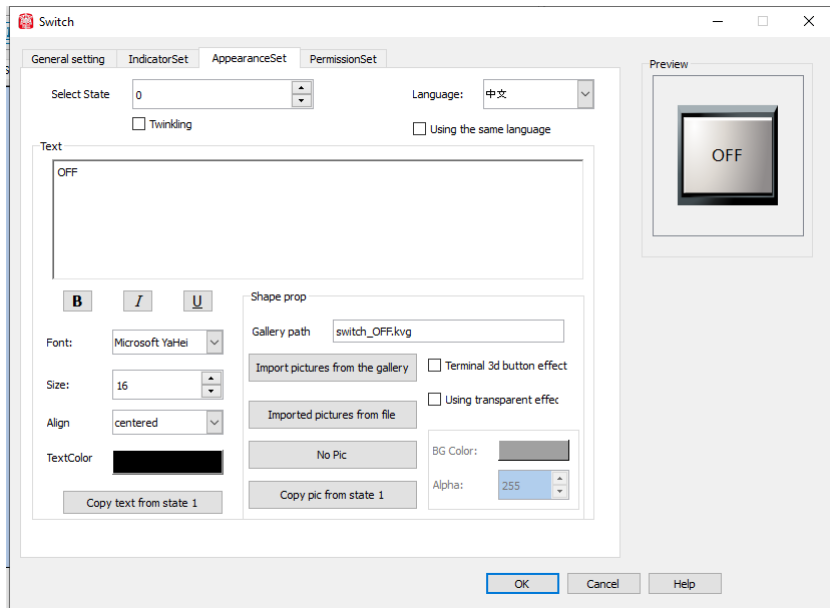
[picture p46: figure]

Figura 2.8: Se puede configurar la apariencia y el texto del switch

En esta pestaña se puede configurar la aprencia (a traves del Shape prop), como el texto y tipo de letra.

9

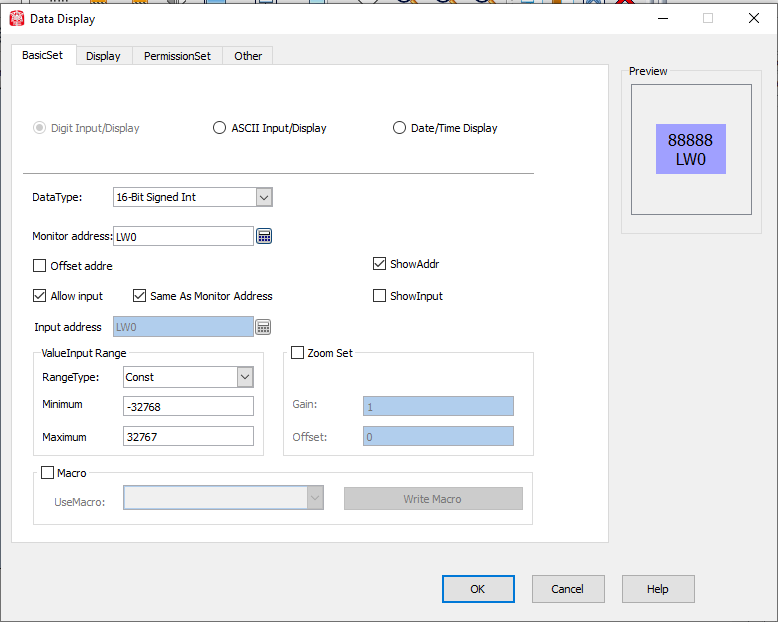
[picture p47: figure]

Figura 2.9: Configuracion basica del Display

Digit Imput/Display: Muestra datos de manera digital en numeros decimales Monitoe address: muestra la dirección del objeto monitoreado.
Allow Imput: si esta opción está marcada, el teclado aparecerá al tocar la pantalla numérica y se podrá ingresar el valor que desea ingresar en el teclado; si esta opción no está marcada, significa que la pantalla de valores numéricos solo puede mostrar valores, pero no valores ingresados.
Input Address: muestra o ingresa la dirección del valor.
Same As Monitor Address: cuando esta opción está marcada, la dirección de entrada y la dirección de monitoreo están sincronizadas, es decir, la dirección es la misma.
Password: si esta opción está marcada, el modo de visualización del valor numérico será * al ingresar el valor, es decir, en forma de máscara. Esta opción solo se puede marcar si está marcada la opción Permitir entrada.
Show Address:Cuando esta opción está marcada, el control mostrará la dirección de monitoreo, que es fácil de ver.
Show Input:La bandera Imput se mostrará solo cuando Allow Imput y Allow Imput.estén marcados al mismo tiempo, lo que indica que la pantalla actual puede ingresar valores.
Value Input Range:

10

Range Type: Se puede dividir en Const y Address.
Const: Se refiere a todos los valores positivos y negativos.
Address: Se refiere a la dirección interna y la dirección externa.
Maximum: El valor máximo que se puede introducir en la pantalla de valor exponencial.
Minimum: El valor mínimo que se puede introducir mediante una visualización exponencial.

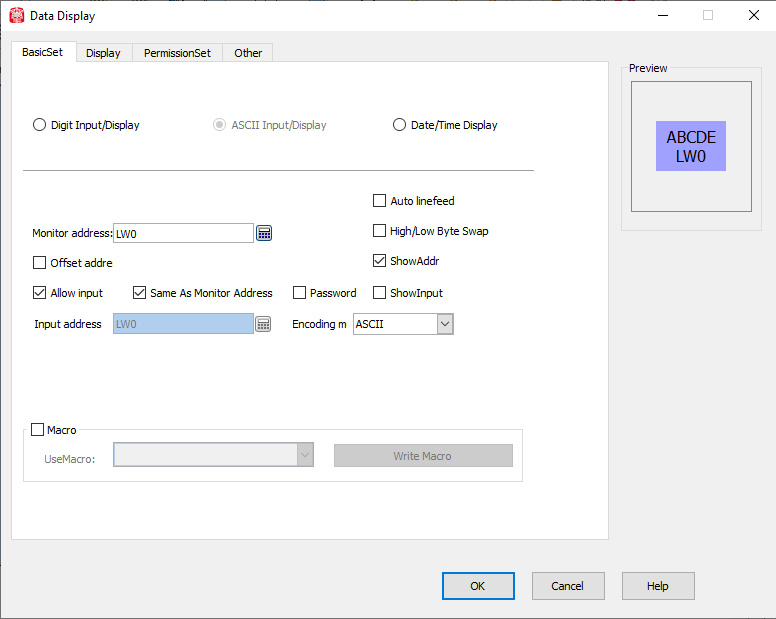
[picture p48: figure]

Figura 2.10: Configuracion del display ascii

11

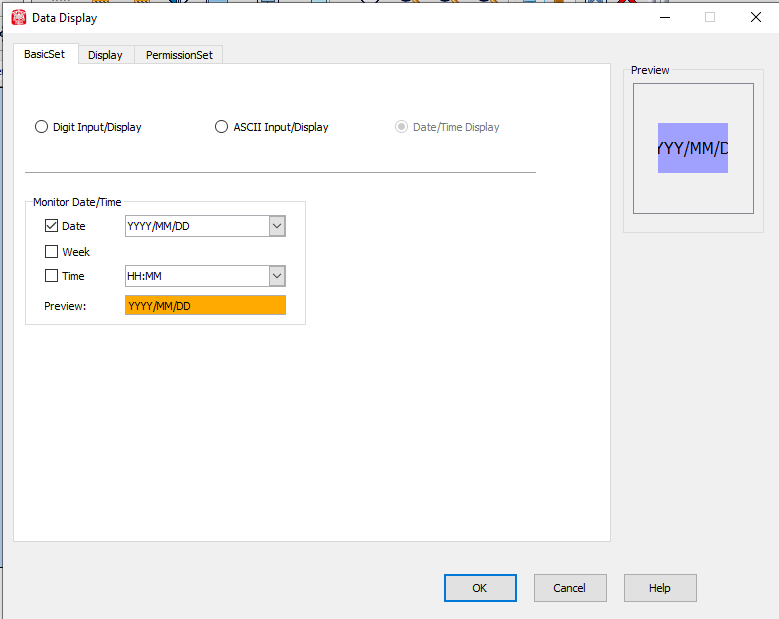
[picture p49: figure]

Figura 2.11: Configuracion display, fecha

12

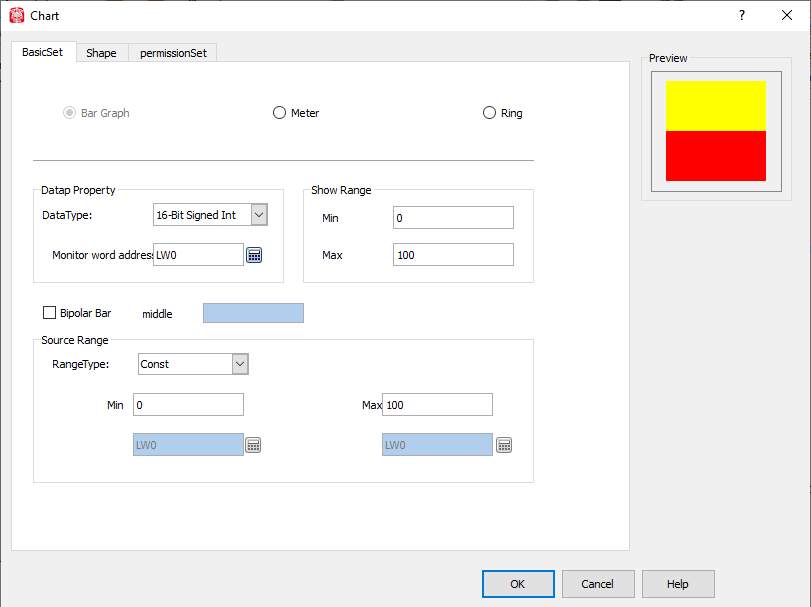
[picture p50: figure]

Figura 2.12: Configuracion del chart/grafico tipo barra

El chart bar graph también se denomina diagrama de barras o grafico de barras. La función principal del control del gráfico de barras es mostrar el cambio en tiempo real del valor numérico en forma de aumento o disminución de la columna, lo que hace que el cambio en tiempo real del valor numérico sea más intuitivo y claro.
El gráfico de barras no solo puede reflejar los cambios numéricos almacenados en los registros de datos del PLC , Micro u otro equipo conectado, sino que también refleja directamente los cambios en tiempo real de todas las cantidades analógicas en el flujo del proceso.

13

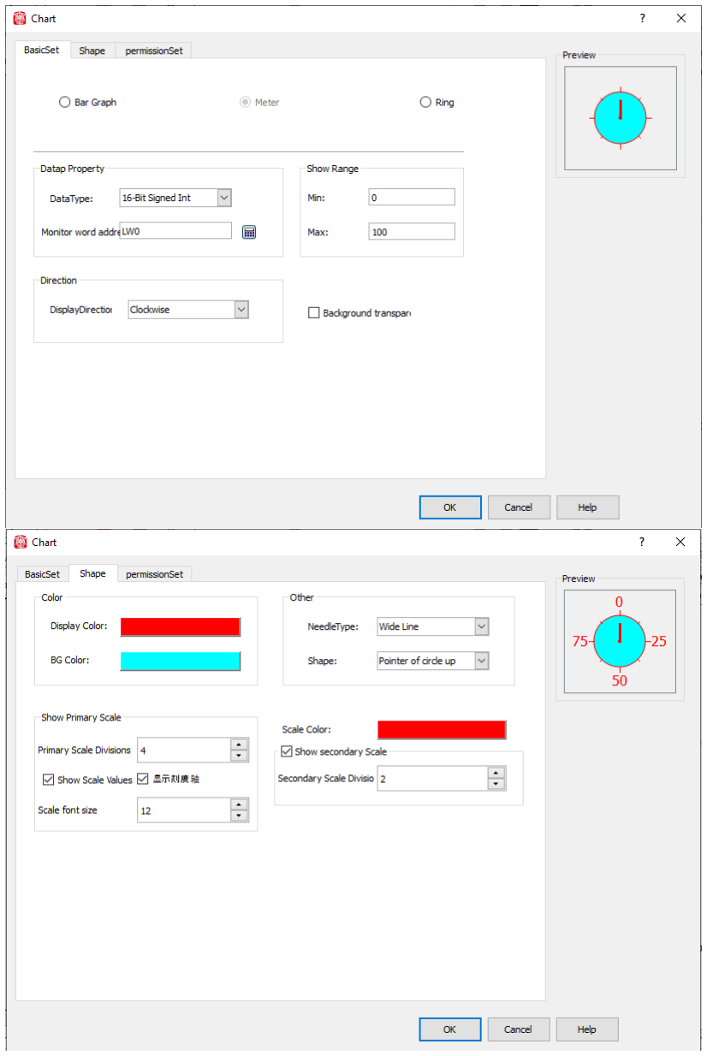
[picture p51: figure]

Figura 2.13: Configuracion basica del medidor o meter, como tambioen sus configuracion visual

14

El meter/medidor puede mostrar el valor de la variable actual asociada con un puntero. Por lo general, un medidor es semicircular o circular, y la situación real de la variable se puede representar visualmente mediante el medidor.

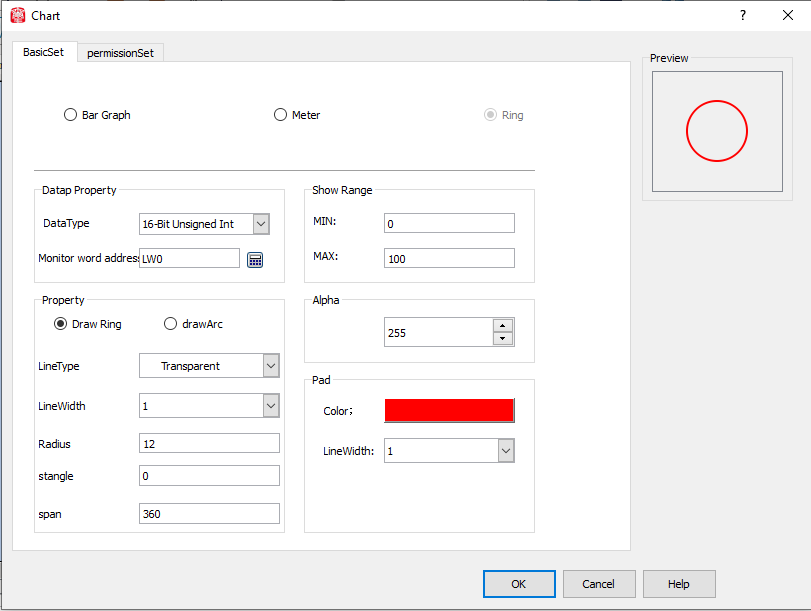
[picture p52: figure]

Figura 2.14: Configuracion basica del medidor ring o anillo

El ring/anillo puede mostrar el cambio de valor de la variable asociada actual en tiempo real con el radián de un arco, lo que hace que el cambio de valor en tiempo real sea más intuitivo y claro. Por lo general, un anillo es un anillo o un arco.

15

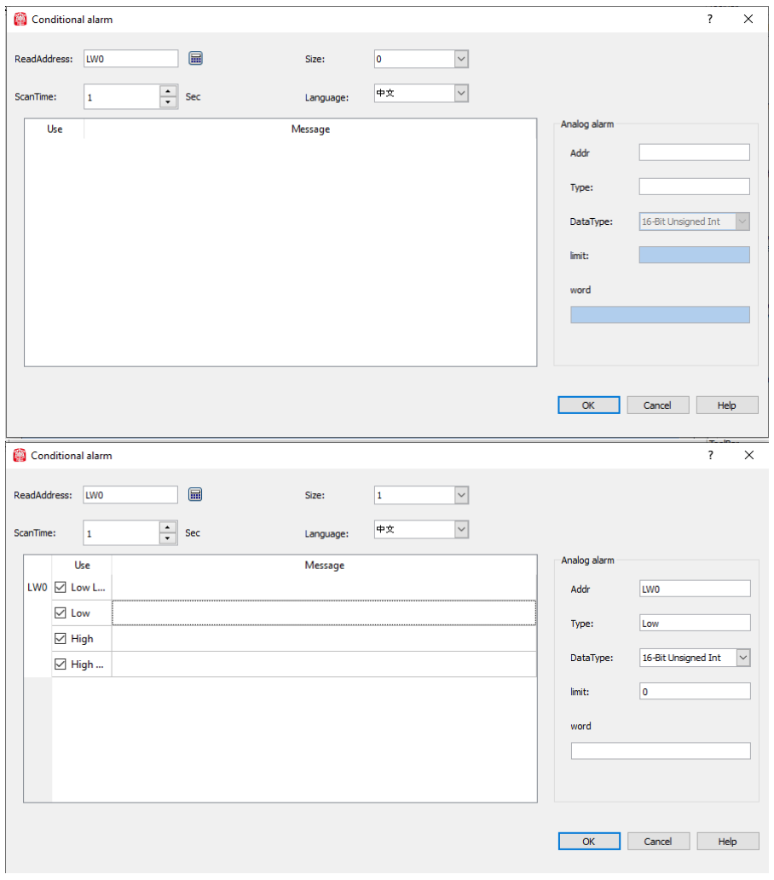
[picture p53: figure]

Figura 2.15: Configuracion de las alrmas para su uso

La información / configuracion de alarma se muestra leyendo la dirección de bit en la columna de dirección, que puede mostrar la información de alarma en varios idiomas. Al mismo tiempo, puede saltar a la pantalla especificada cuando se da la alarma y volver a la pantalla especificada después de que se borra la alarma. La alarma de dirección de bit incluye alarmas de bits continuos, bits de palabra continuos y valores de palabra. Dado que solo se puede crear un grupo de alarmas, la información de alarma se perderá cuando se seleccionen diferentes tipos de alarmas y se proporcionará la información de aviso correspondiente en funcionamiento.

16 por ejemplo si en un display que esta configurado en LW0 como su adrress, se configura un mensaje en las alarmas, como tambien las condiciones, de valor, osea si display muestra un dato alto que es considerado critico, la alarma.

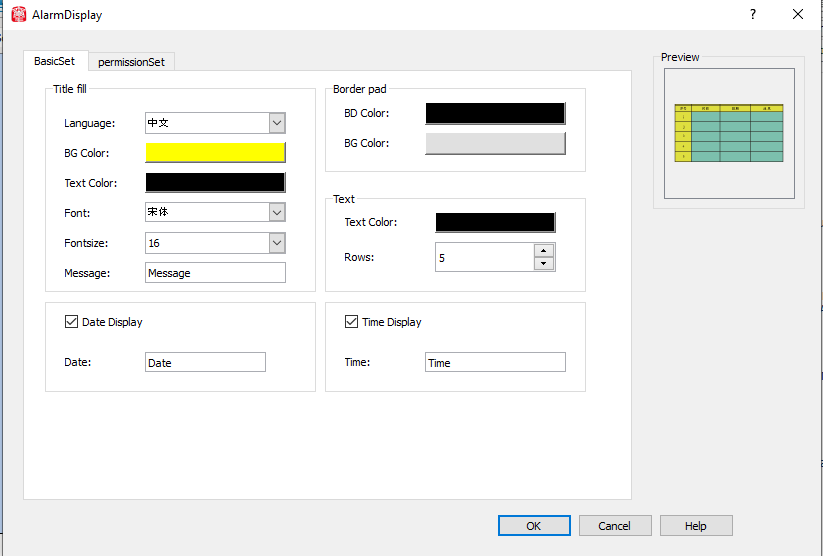
[picture p54: figure]

Figura 2.16: Configuracion del display de alarma

Se puede configurar cambiando colores, idioma, se puede quitar cosas como las fecha y tiempo y solo dejar el mensaje

17

## 2.5. Como importar el programa al monitor kinseal

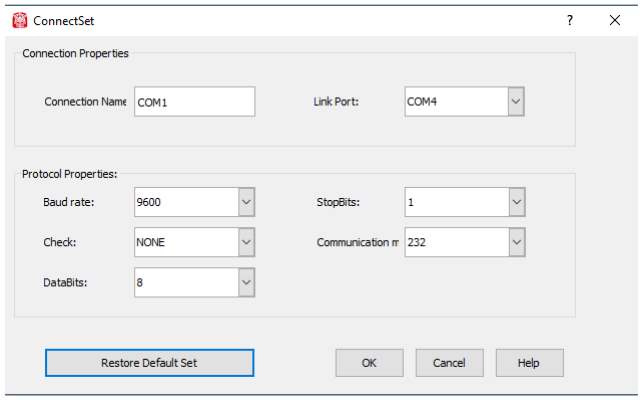
[picture p55: figure]

Figura 2.17: Configuracion de ajuste de la comunicacion

Antes tambien se revisa la configuracion de comunicacion, como el tipo de comunicacion , el puerto de enlace, y el nombre de la comunicacion.

18

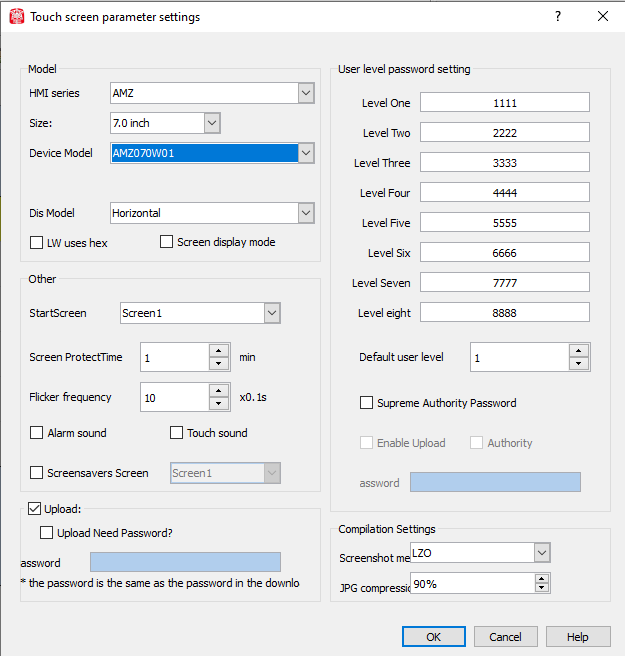
[picture p56: figure]

Figura 2.18: Propiedades del sistema

Antes de enviar el programa al monitor, se deben revisar las propiedades del sistema en donde se pueden configurar ciertas cosas como contraseñas, sonido, tasa de refresco, el tiempo de suspencion, el modelo de monitor para poder optimizarlo lo maximo posible.

19

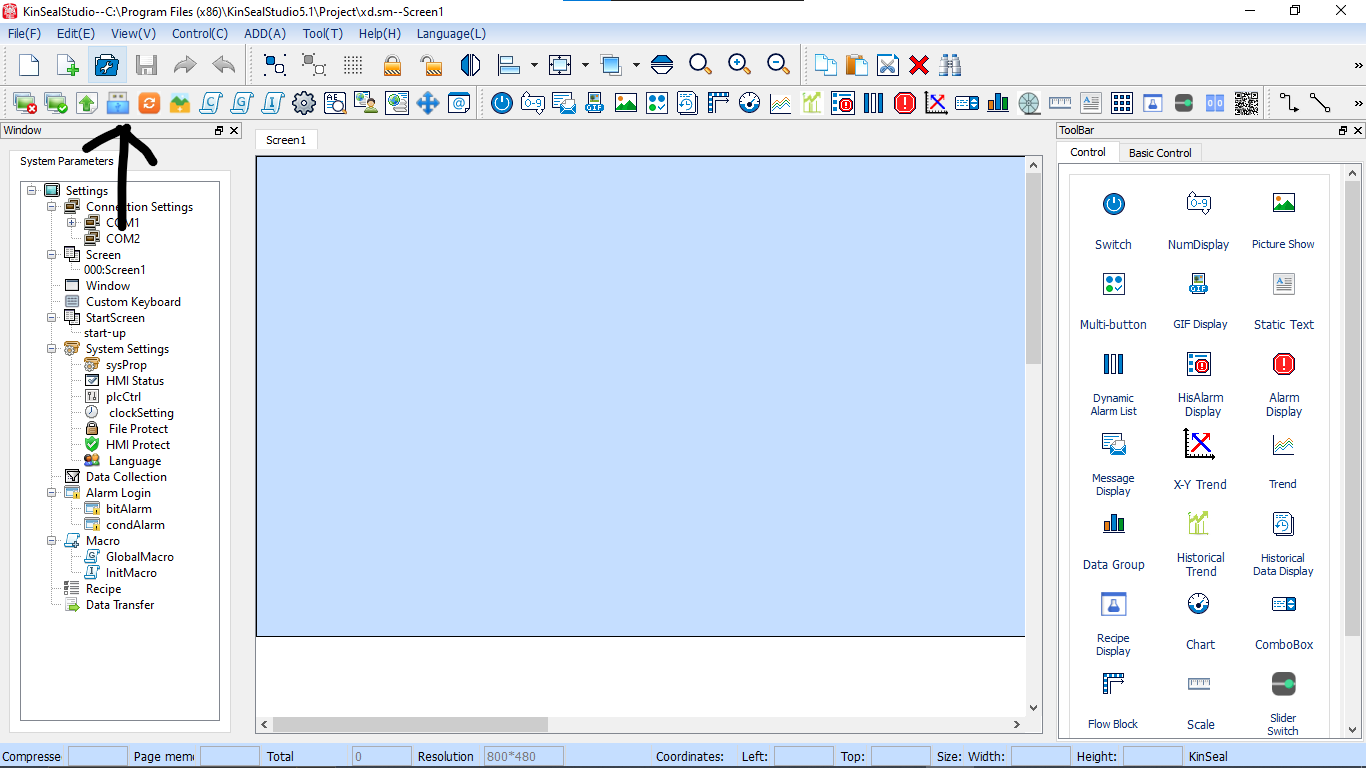
[picture p57: figure]

Figura 2.19: Primero se presiona ese icono para que guarde el programa

Lo que te lleva a esto

20

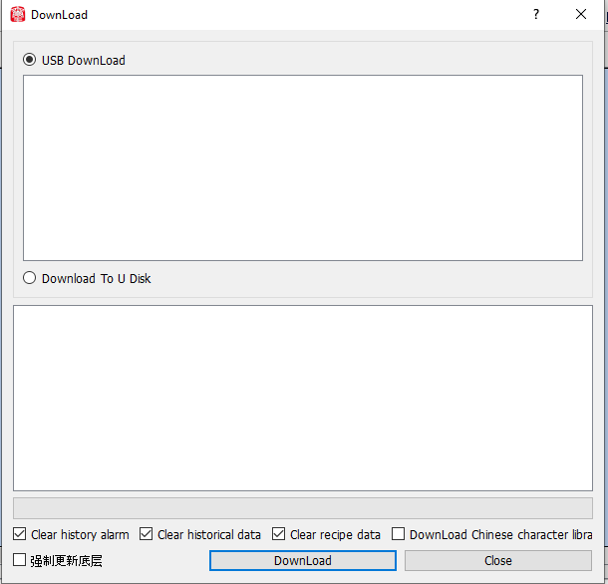
[picture p58: figure]

Figura 2.20: Y despues presionar en descargar.

La computadora debe estar conctada al monitor a traves de un cable MICRO USB, con esto se guarda el trabajo y se envia

## 2.6. informacion extra

¿Que es LW,LB,RWI?
lb (bit de registro interno), LW (palabra de registro interno), RWI (índice de receta)
Localbit: referencia del área de almacenamiento interno LB;
Local word: referencia del área de almacenamiento interno LW;
Rwiword: referencia al RWI en el área de almacenamiento interno.
¿Que son los COM?
los COM son las confuiguaraciones que hacen que los instrumentos dejen de

21 estar en modo esclavo o solo uticen la memoria del sistema y pasen a comunicarse con el PLC/MICRO, estos se configuran segun los tipos de secuencias que tiene el protocolo MODBUS
Para mas informacion detallada se uso el Help que tiene el kinseal Studio donde hay mas material detallado, pero no lo suficiente.

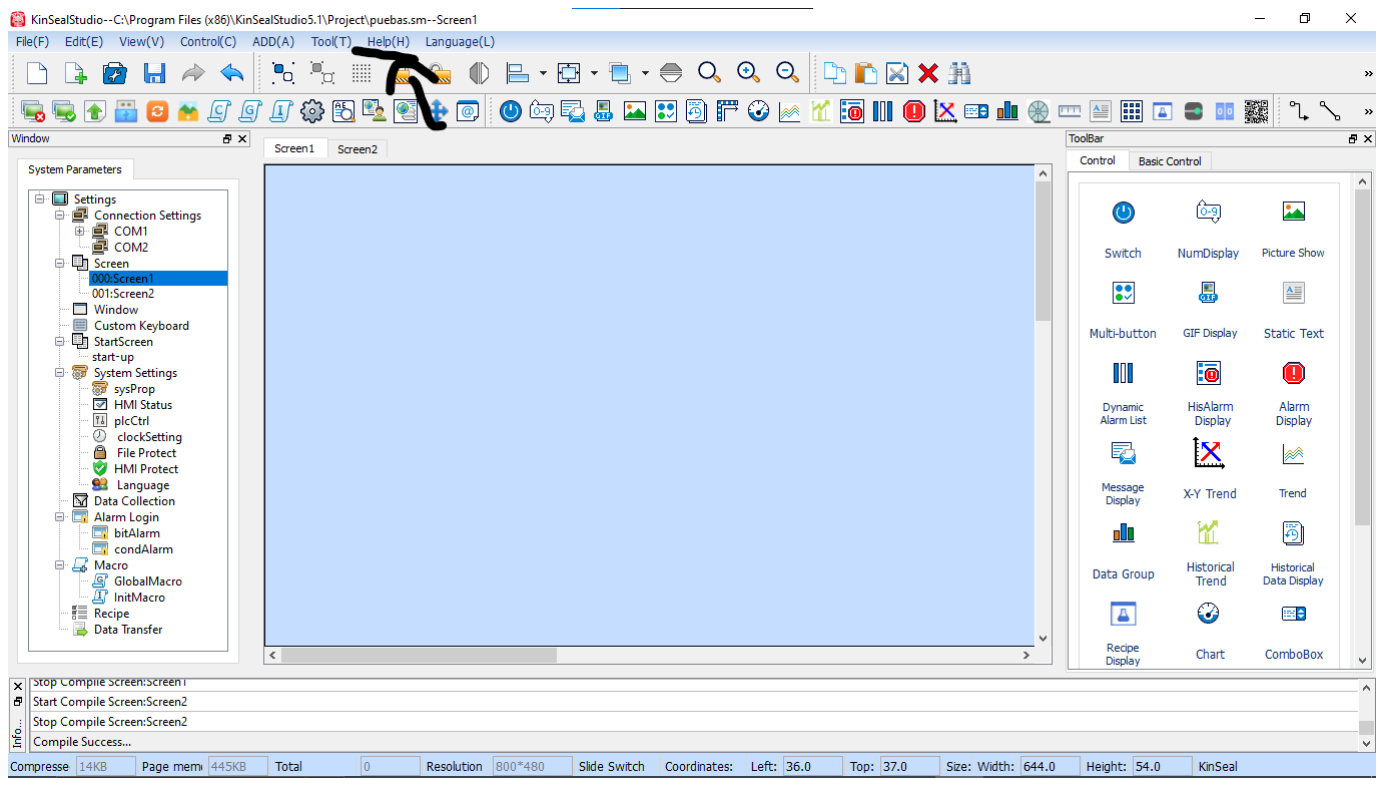
[picture p59: figure]

Figura 2.21: aca se ubica el help

Para mas informacion detallada se uso el Help que tiene el kinseal Studio donde hay mas material detallado, pero no lo suficiente. Ahi se accede a mas informacion, con ejemplos y varias configuraciones, pero esta en ingles.

22

# Capítulo 3

# Protocolo de comunicación

Este capítulo aborda los protocolos necesarios para la comunicación entre el monitor y dispositivos externos.

## 3.1. ¿Qué es el Protocolo MODBUS?

Modbus es un protocolo de comunicación industrial que permite la transmisión de información entre dispositivos de automatización. Utiliza una arquitectura maestro/esclavo, donde el maestro envía una solicitud al esclavo y espera su respuesta. Es uno de los protocolos más utilizados en sistemas de control industrial.

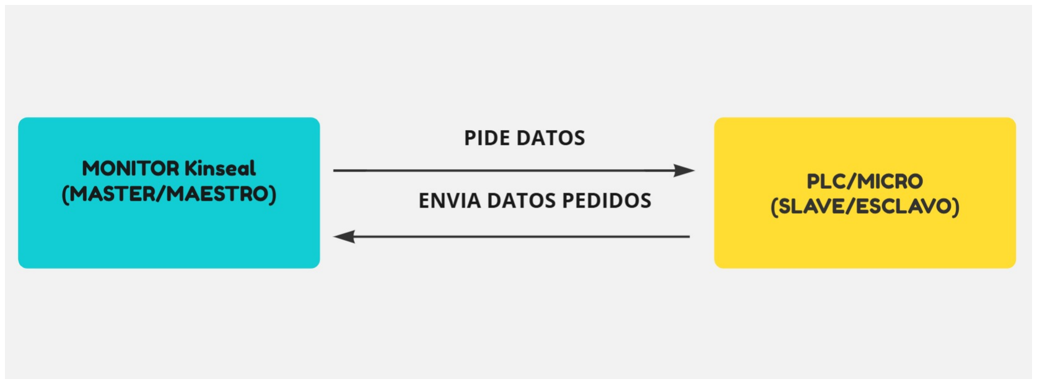
[picture p60: figure]

Figura 3.1: Principio basico del protocolo MODBUS, en el caso del monitor kinseal

El protocolo MODBUS trabaja de manera secuancias operativas dependiendo de la cantidad de Bytes.

23

Figura 3.2: Procolo MODBUS basico

Divice address: es la direccion general de envio osea un 01.
Function code: es el codigo de la funcion con la que se va a trabajar, este actua como un multiplicador. se puede trabajar con (0x01,0x03,0x04,0x05,0x06 y 0x10), tambien evita los errores.
Data format:Se almacena la información necesaria para ejecutar la acción especificada por un código de función o sino Se almacena el resultado de la ejecución de la acción especificada por un código de función. Se almacena un código de excepción cuando se produce un error.
CRC Check: El agrega el código de verificación automáticamente a todos los mensajes transmitidos y vuelve a calcular el código de verificación para cualquier mensaje recibido. El mensaje recibido se descarta si tiene un error. siendo un seguro ante errores. un codigo puede tener uno o dos CRC check

## 3.2. Read Coils/Bobinas de lectrura (Command Code: 0x01)

Lee el estado (ON/OFF) de una o más bobinas, osea el encendido y apagado.

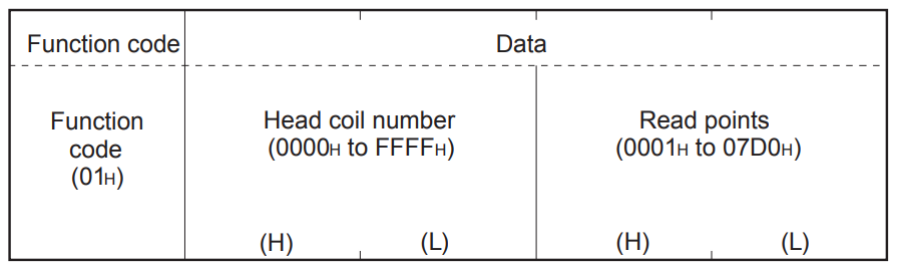
[picture p61: figure]

Figura 3.3: Formato de mensaje de pedido(Master—->Slave)

24

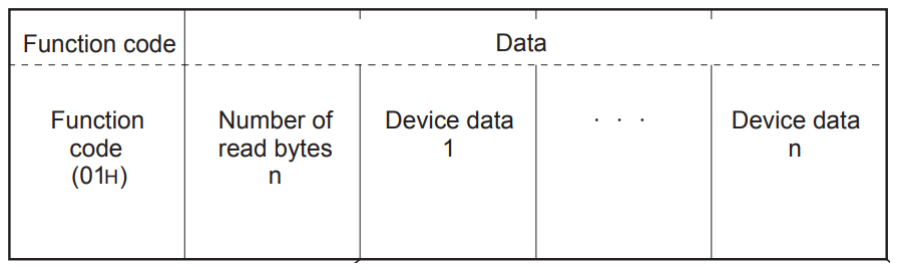
[picture p62: figure]

Figura 3.4: Formato de respueta al pedido (Slave—–>Master

## 3.3. Read Discrete Inputs/Lectura de entradas discretas (Command Code: 0x02)

Lee el estado (ON/OFF) de una o más entradas

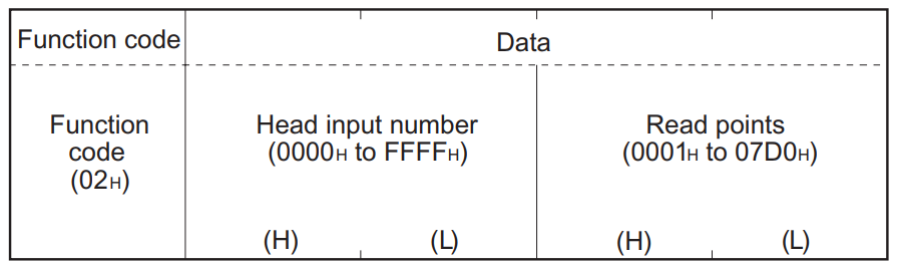
[picture p63: figure]

Figura 3.5: Formato de mensaje de pedido(Master—->Slave)

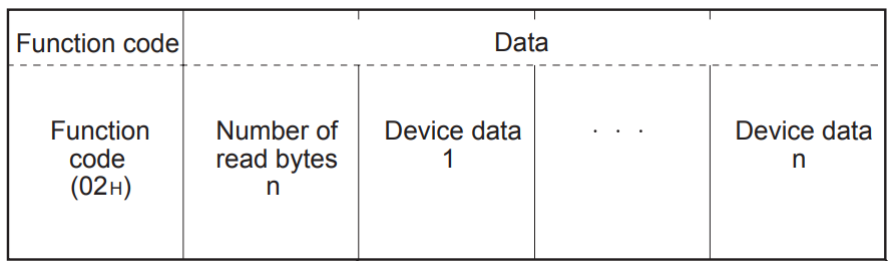
[picture p64: figure]

Figura 3.6: Formato de respueta al pedido (Slave—–>Master)

25

## 3.4. Read Holding Registers/Leer registros de retención (Command Code: 0x03

Lee los valores de uno o más registros de retención.

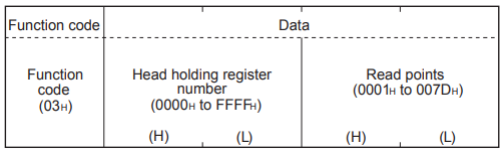
[picture p65: figure]

Figura 3.7: Formato de mensaje de pedido(Master—->Slave)

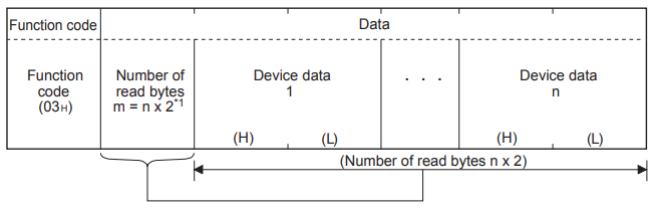
[picture p66: figure]

Figura 3.8: Formato de respueta al pedido (Slave—–>Master)

*1. Por ejemplo, si n = 4, el número de bytes se calcula como 4 x 2 = 8 bytes

## 3.5. Input Registers/Lectura de registros de entrada (Command Code: 0x04)

Lee los valores de uno o más registros de entrada.

26

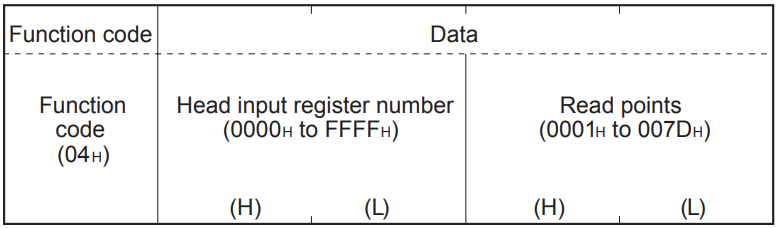
[picture p67: figure]

Figura 3.9: Formato de mensaje de pedido(Master—->Slave)

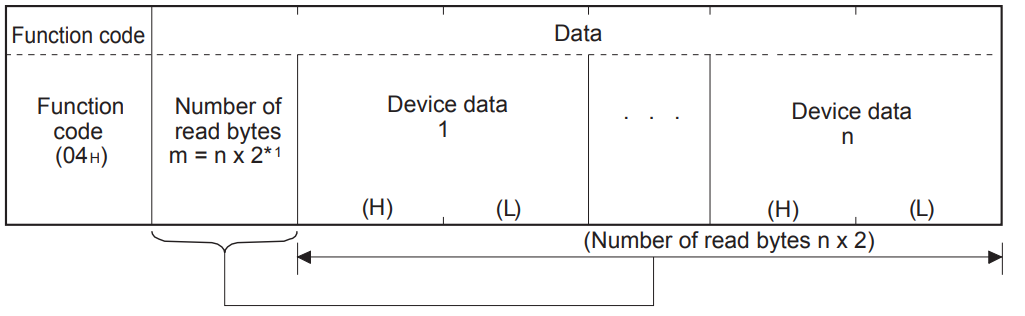
[picture p68: figure]

Figura 3.10: Formato de respueta al pedido (Slave—–>Master)

*1. Por ejemplo, si n = 4, el número de bytes se calcula como 4 x 2 = 8 bytes

## 3.6. Write Single Coil/Escribir bobina simple (Command Code: 0x05)

Escribe un valor (ON/OFF) en una bobina

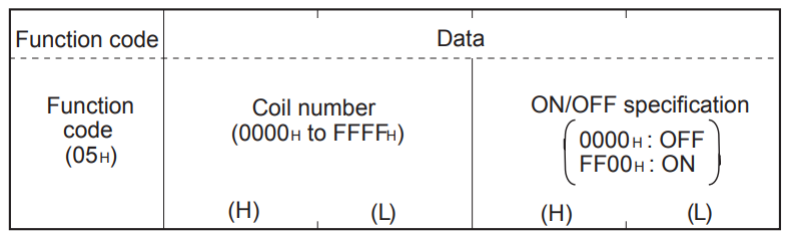
[picture p69: figure]

Figura 3.11: formato de mensaje de pedido(Master—->Slave)

27

Formato de mensaje de respuesta (Esclavo → Maestro) (Cuando se completa normalmente) El esclavo devuelve el mensaje de solicitud recibido del maestro sin cambios.

## 3.7. Write Single Register/Escribir registro único (Command Code: 0x06)

Escribe un valor en un registro de retención.

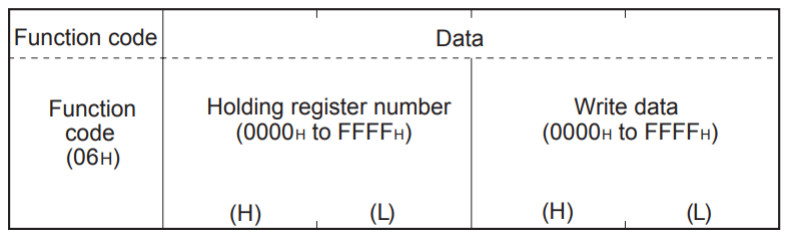
[picture p70: figure]

Figura 3.12: formato de mensaje de pedido(Master—->Slave)

Formato de mensaje de respuesta (Esclavo → Maestro) (Cuando se completa normalmente) El esclavo devuelve el mensaje de solicitud recibido del maestro sin cambios.
Para conocer mas secuencuencias del protocolo reviasar el pdf: IyCnet FX3U MODBUS v2 (https://github.com/impatrq/revcontrol/tree/main/Interfaz/documen)

## 3.8. intentos de comunicacion con el monitor a traves del prtocolo modbus

Contenido de la sección 2.
Para intentar comunicarse con el monitor se usaron los protocolos:0x03 y 0x04, ya que se tratan de escritura simple, como tambien la comunicacion serial 232, y se uso el programa terminal y tambien la calculadora de CRC Descargar terminal : por aca (https://github.com/impatrq/revcontrol/tree/main/Interfaz/terminal%20para%20usos%20de%20prueba)
calculadora de CRC: aca (https://crccalc.com/?crc=123456789&method=&datatype=ascii&outtype=hex)
en terminal se permite enviar codigos en hexadecimal como tambien recibirlos, se intento contestar usando los siguientes codigos con resultados nada favorables:
-01030017001340E
-01030200980E34
-01040017980E81
-01040017000181CE

28

-0104007000041CE
-0104020064DBB8
-0103020064AFB9
-0104021700017680
-0104021700645D40
-0103040064AE59
-010302000487B9
-0104000200642150
En algunos casos se intento cambiar el crc, cambiando su orden entre mayor y menor.
Tambien se intento usar usar una macro (un codigo que se programa en C para funciones internas)

## 3.9. Uso de Terminal.exe

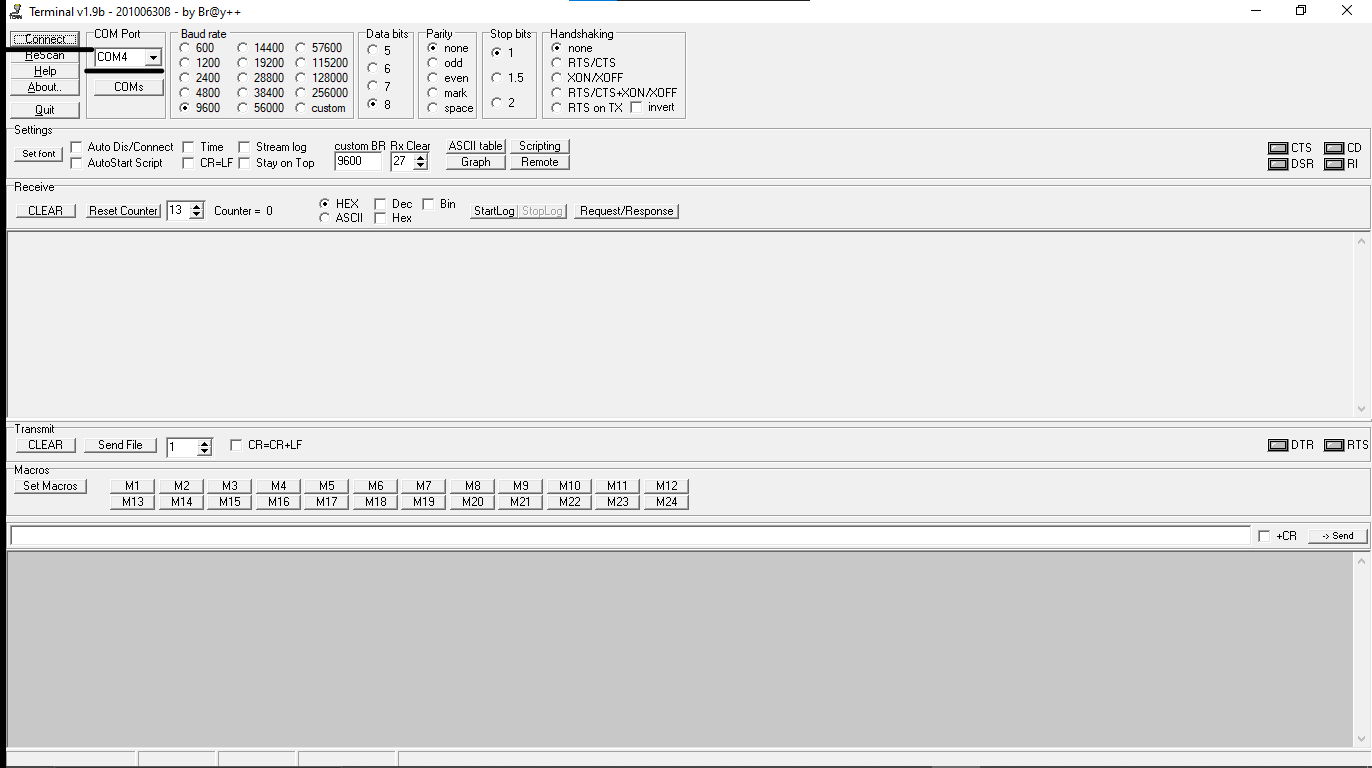
[picture p71: figure]

Figura 3.13: pantalla de incio de terminal

Se tiene que encerder la entrada, que utiliza el COM de manera automatica dependiendo del dispositivo.
una vez que se comunica, la terminal recibe datos que se muestran en la parte de arriba

29

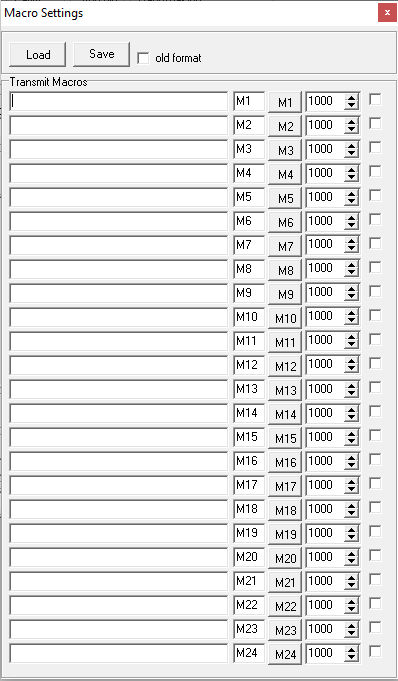
[picture p72: figure]

Figura 3.14: configuracion del set macros donde se pueden introducir codigos en hexa para poder enviarlo al monitor

30

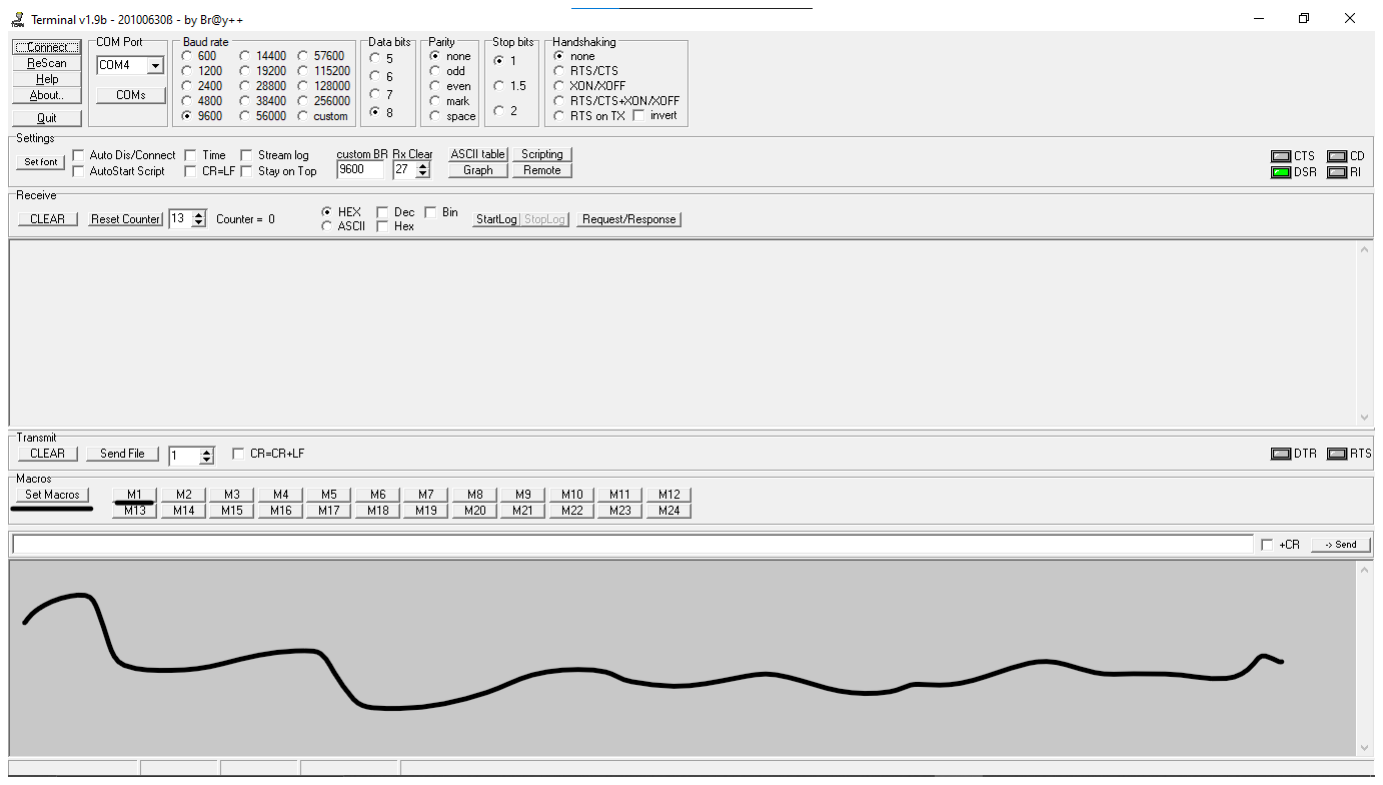
[picture p73: figure]

Figura 3.15: En la parte de abajo se mostraran todos los datos que le metan a traves de la macro y si precionas en uno de los botones de abajo y hay un codigo hexa configurado en la macro, esta se mostrara y se eviara auutomaticamente.

## 3.10. Conclusion:

El monitor kinseal es muy versatil para muchas cosas de caracter industrial como de lectura de datos en tiempo real, pero la falta de tiempo y documentacion en idiomas cercanos, hizo que fuera muy dificil entenderlo, lo unico que falto lograr es que se mostran los datos en pantalla.

31
