impatrq/revcontrol/Diseños de marca/Destacadas/DESTACADA NOSOTROS.png

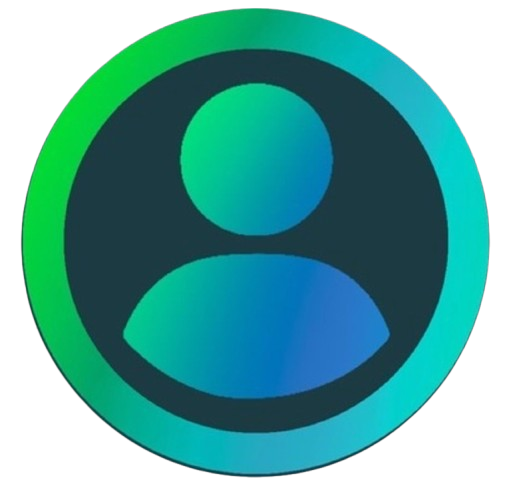
Diseños de marca/Destacadas/DESTACADA NOSOTROS.png
