impatrq/revcontrol/Diseños de marca/Destacadas/PROGRESO DESTACADA.png

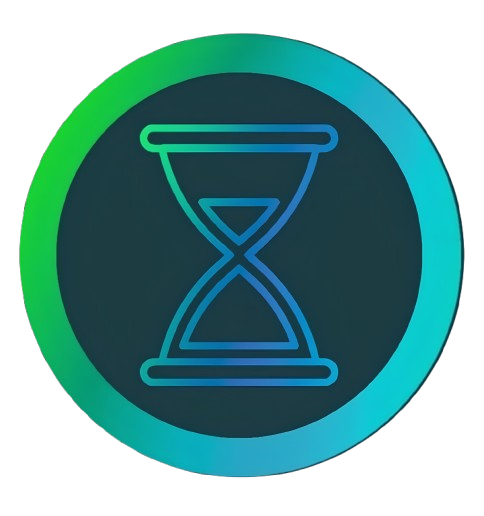
Diseños de marca/Destacadas/PROGRESO DESTACADA.png
