impatrq/revcontrol/Documentación/Descartado/Modulo de bluetooth/Diagrama_en_Bloques__Bluetooth_.jpg

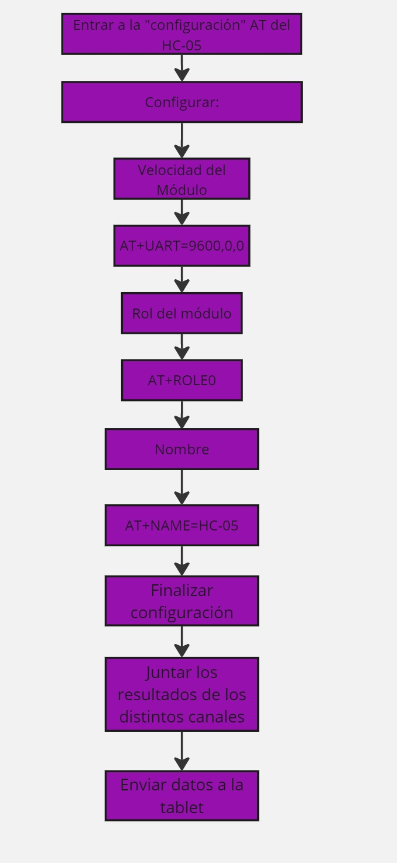
Documentación/Descartado/Modulo de bluetooth/Diagrama_en_Bloques__Bluetooth_.jpg
