impatrq/revcontrol/Documentación/Descartado/Modulo de bluetooth/primeros diagramas.jpeg

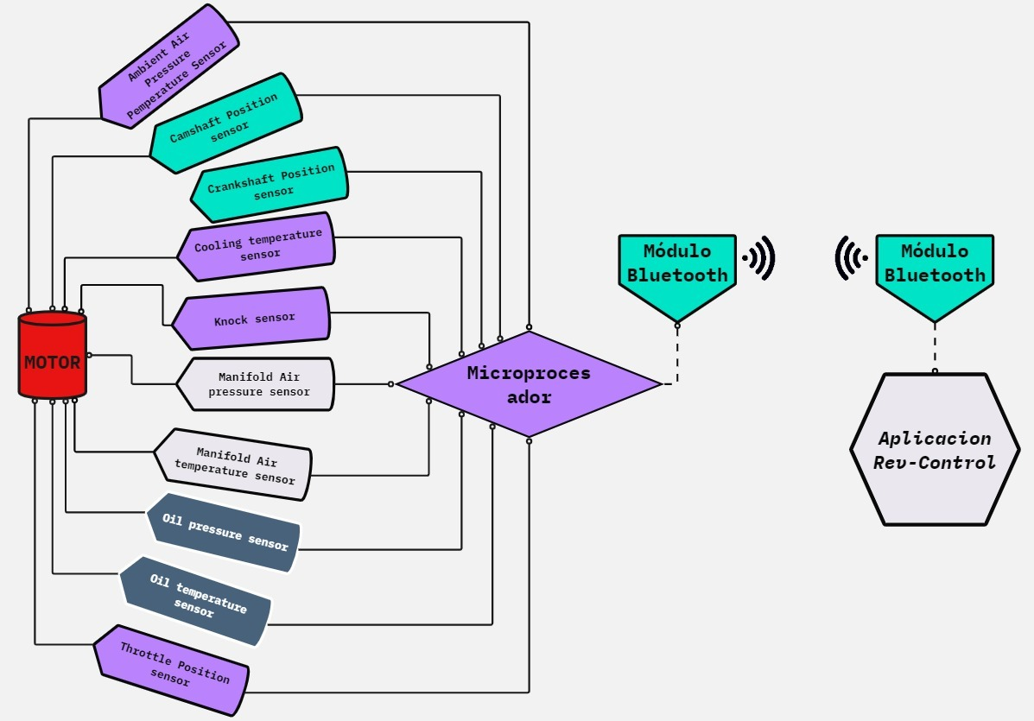
Documentación/Descartado/Modulo de bluetooth/primeros diagramas.jpeg
