impatrq/revcontrol/Documentación/Descartado/Prototipo de sensor de RPM/Carretel.jpg

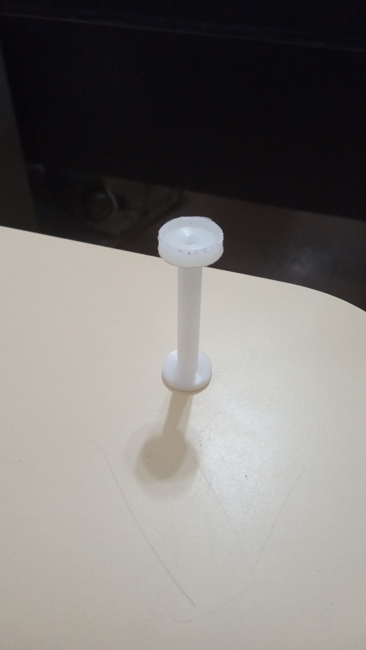
Documentación/Descartado/Prototipo de sensor de RPM/Carretel.jpg
