impatrq/revcontrol/Documentación/Descartado/Prototipo de sensor de RPM/Plano Carretel/Carretel sensor de velocidad.jpeg

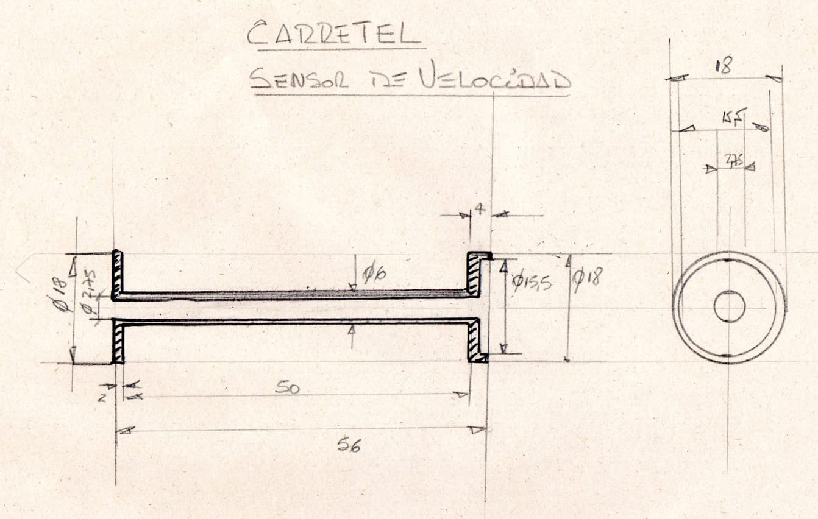
Documentación/Descartado/Prototipo de sensor de RPM/Plano Carretel/Carretel sensor de velocidad.jpeg
