impatrq/revcontrol/Documentación/Descartado/Prototipo de sensor de RPM/Varilla recién comprada.jpg

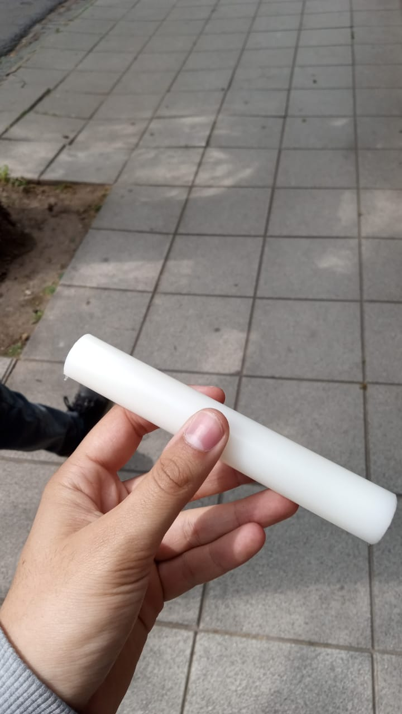
Documentación/Descartado/Prototipo de sensor de RPM/Varilla recién comprada.jpg
