impatrq/revcontrol/Documentación/Descartado/Prototipo de soporte de maletín.jpg

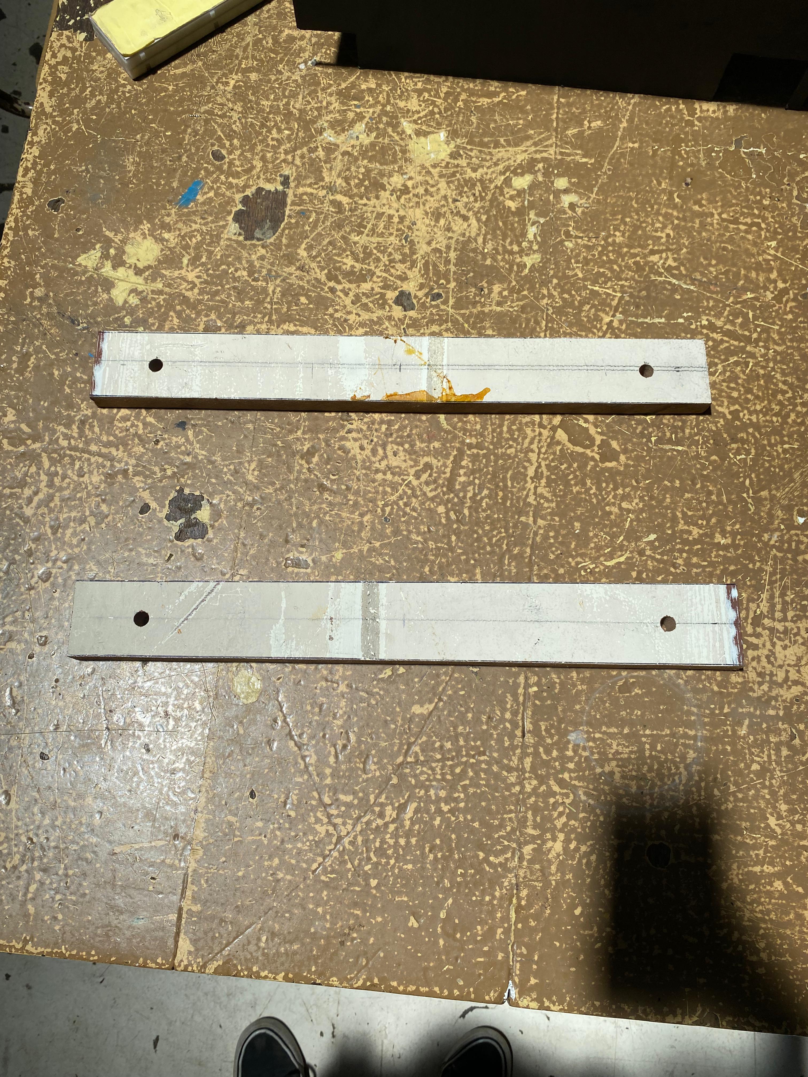
Documentación/Descartado/Prototipo de soporte de maletín.jpg
