impatrq/revcontrol/Documentación/Descartado/Visualización vía Bluetooth/Error en wifi.jpeg

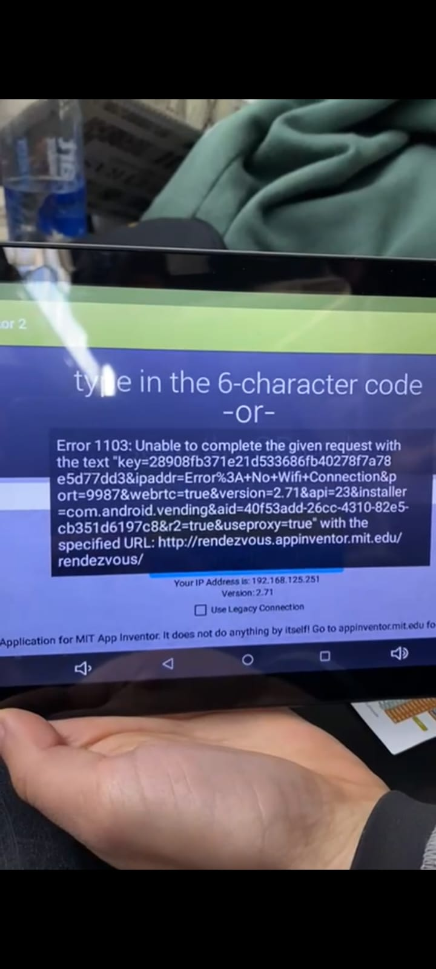
Documentación/Descartado/Visualización vía Bluetooth/Error en wifi.jpeg
