impatrq/revcontrol/Documentación/Documentación técnica/Documentación del monitor Kinseal/Interfaz/INTERFAZ PREVIEW - REV CONTROL.png

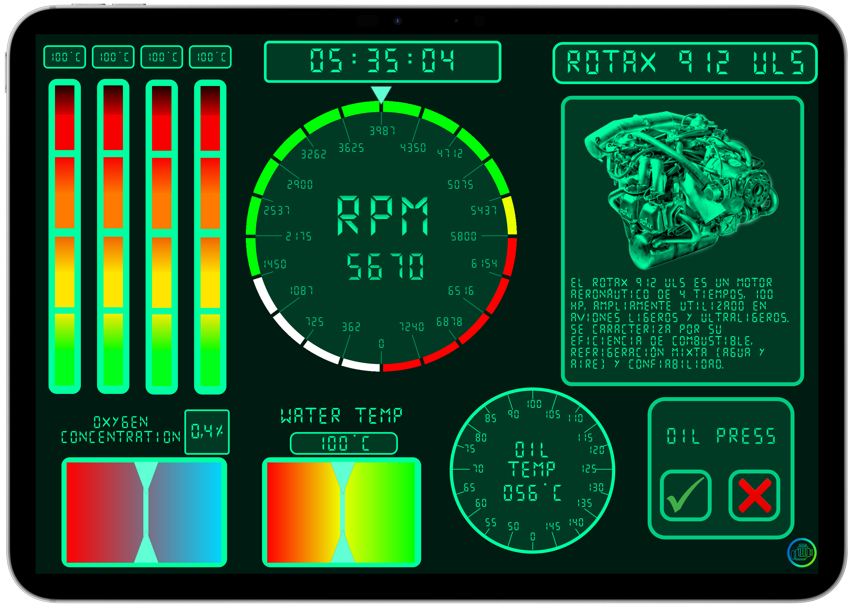
Documentación/Documentación técnica/Documentación del monitor Kinseal/Interfaz/INTERFAZ PREVIEW - REV CONTROL.png
