impatrq/revcontrol/Documentación/Documentación técnica/Documentación del monitor Kinseal/Interfaz/pantalla 4 interfaz.png

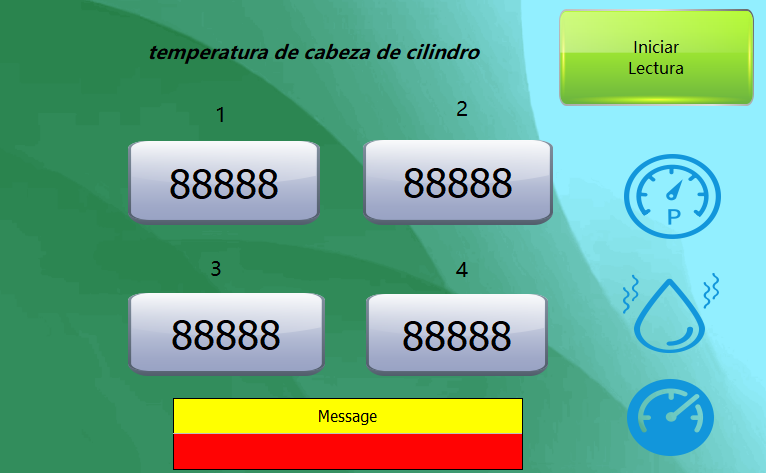
Documentación/Documentación técnica/Documentación del monitor Kinseal/Interfaz/pantalla 4 interfaz.png
