impatrq/revcontrol/Documentación/Documentos administrativos/Facturas - RevControl/09-10-24.jpg

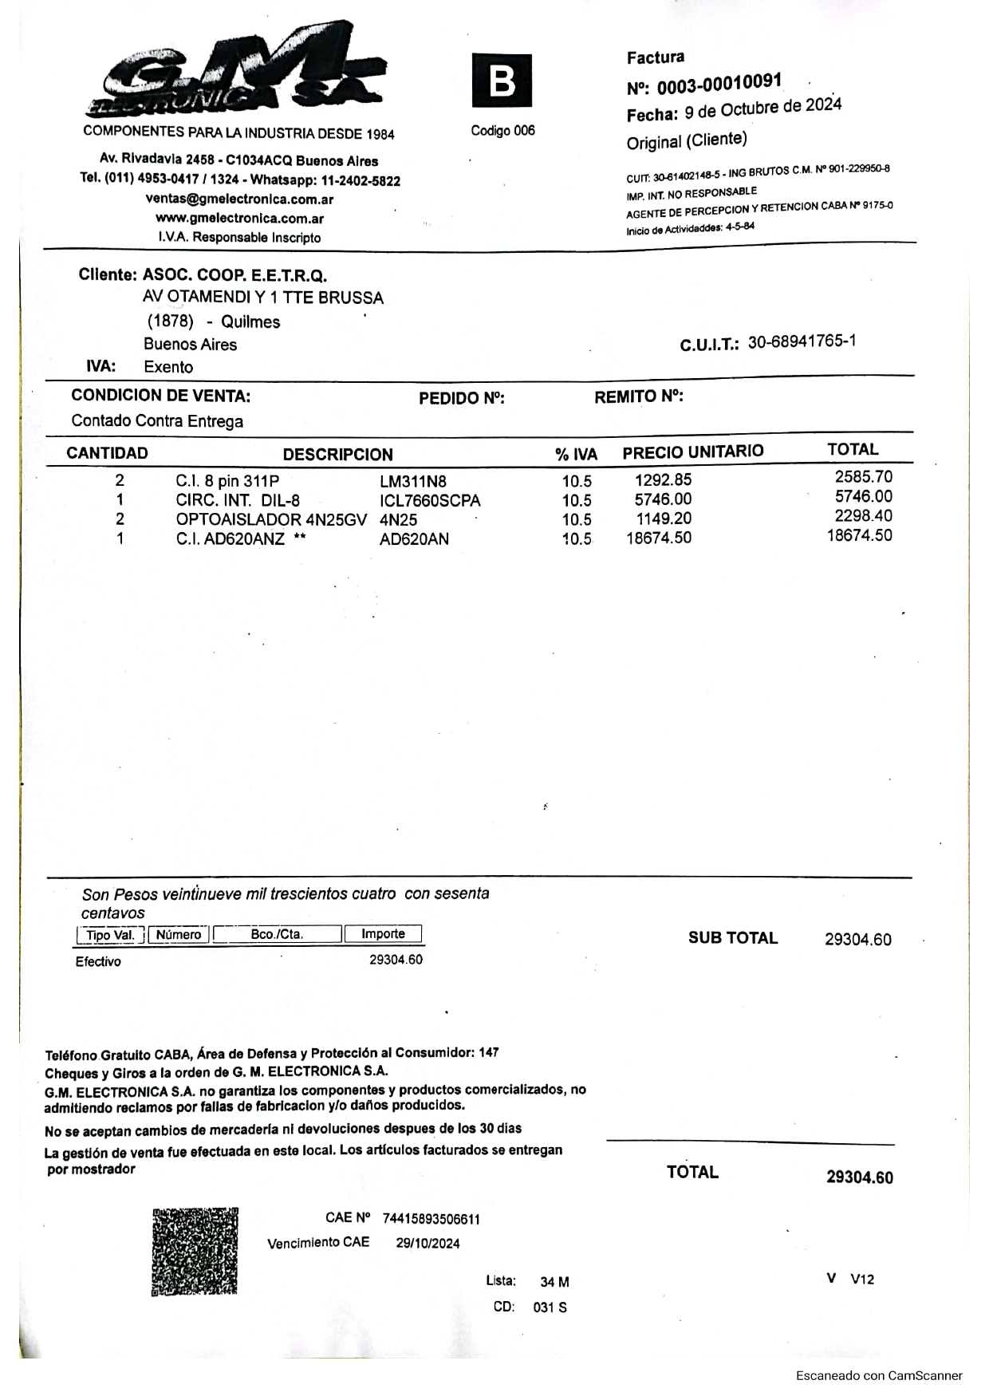
Documentación/Documentos administrativos/Facturas - RevControl/09-10-24.jpg
