impatrq/revcontrol/Documentación/Documentos administrativos/Facturas - RevControl/10-09-24.jpg

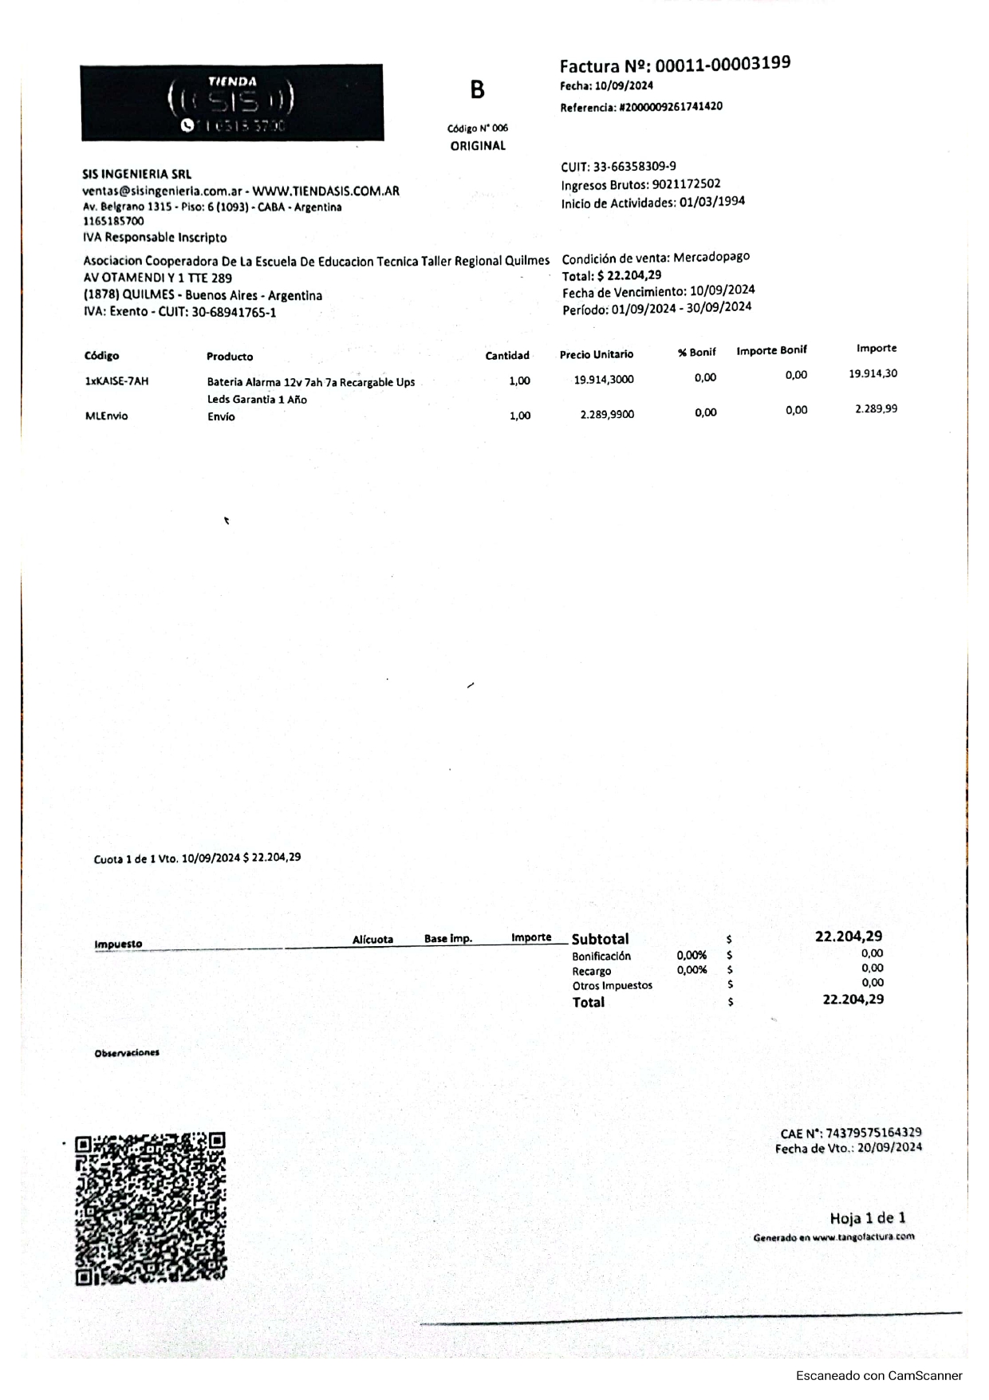
Documentación/Documentos administrativos/Facturas - RevControl/10-09-24.jpg
