impatrq/revcontrol/Documentación/Documentos administrativos/Facturas - RevControl/13-09-24.jpg

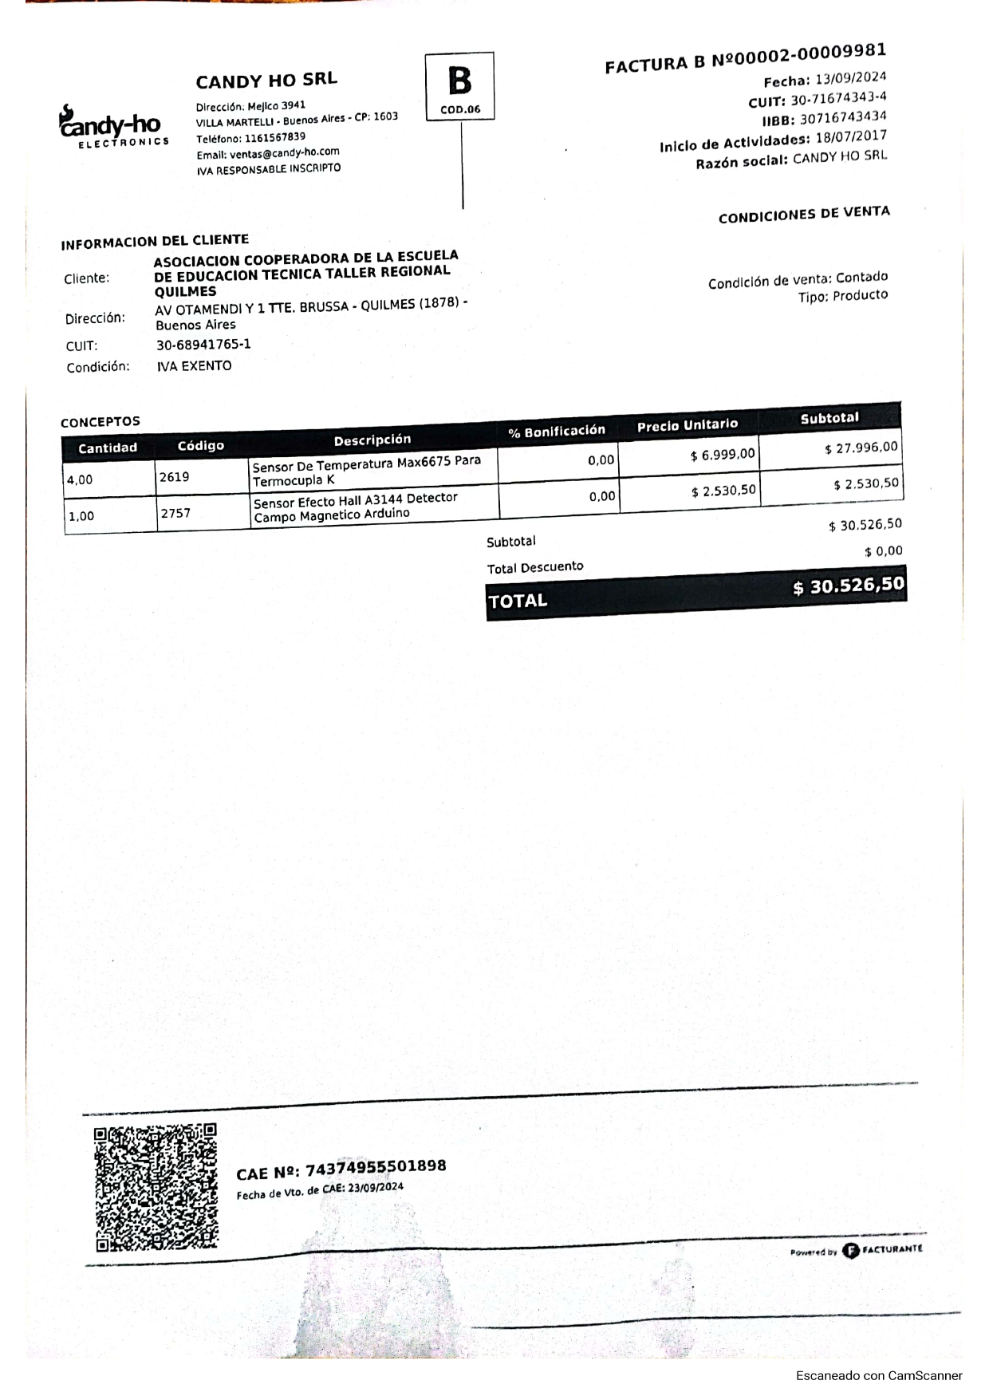
Documentación/Documentos administrativos/Facturas - RevControl/13-09-24.jpg
