impatrq/revcontrol/Documentación/Documentos administrativos/Facturas - RevControl/14-10-24.jpg

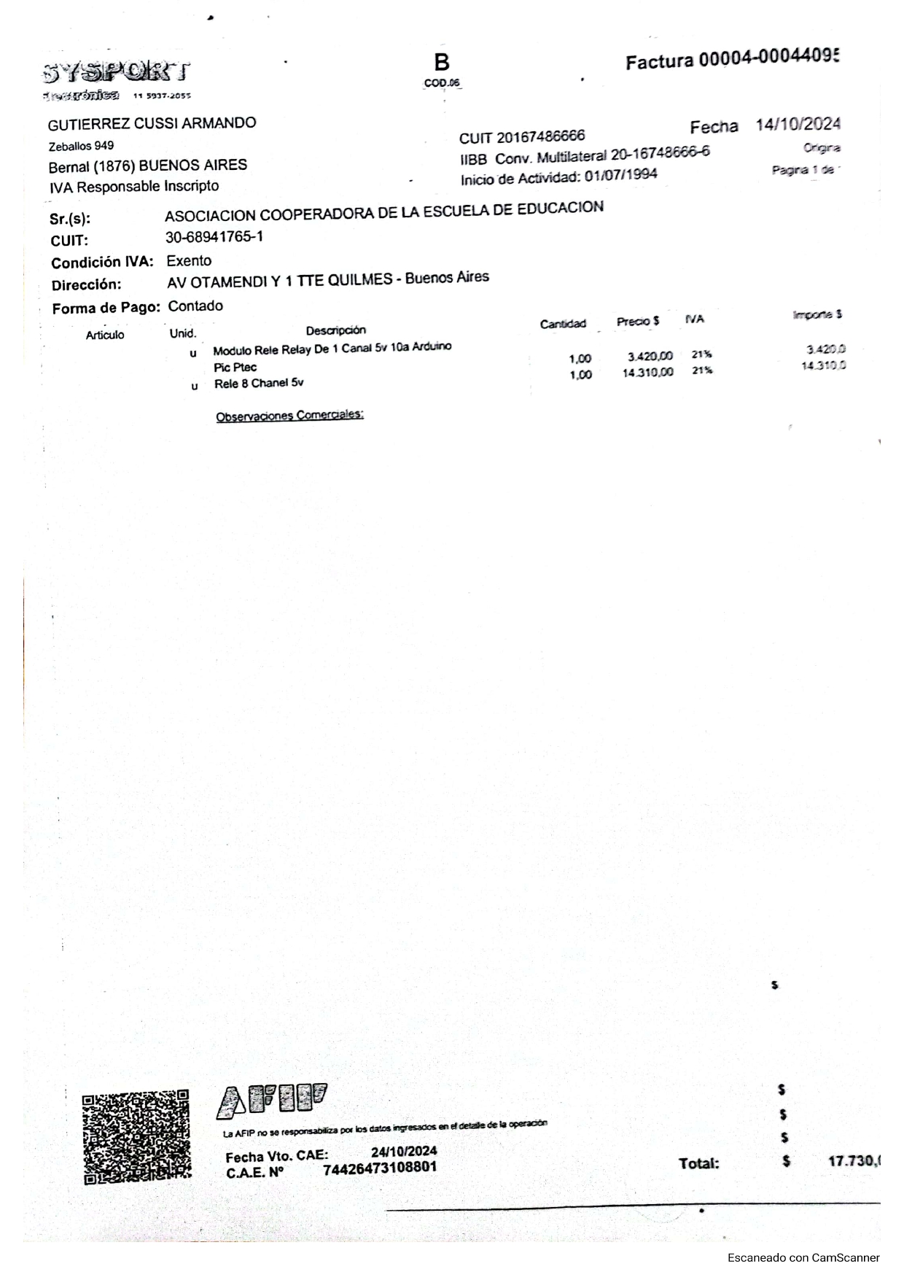
Documentación/Documentos administrativos/Facturas - RevControl/14-10-24.jpg
