impatrq/revcontrol/Documentación/Documentos administrativos/Facturas - RevControl/15-10-24.jpg

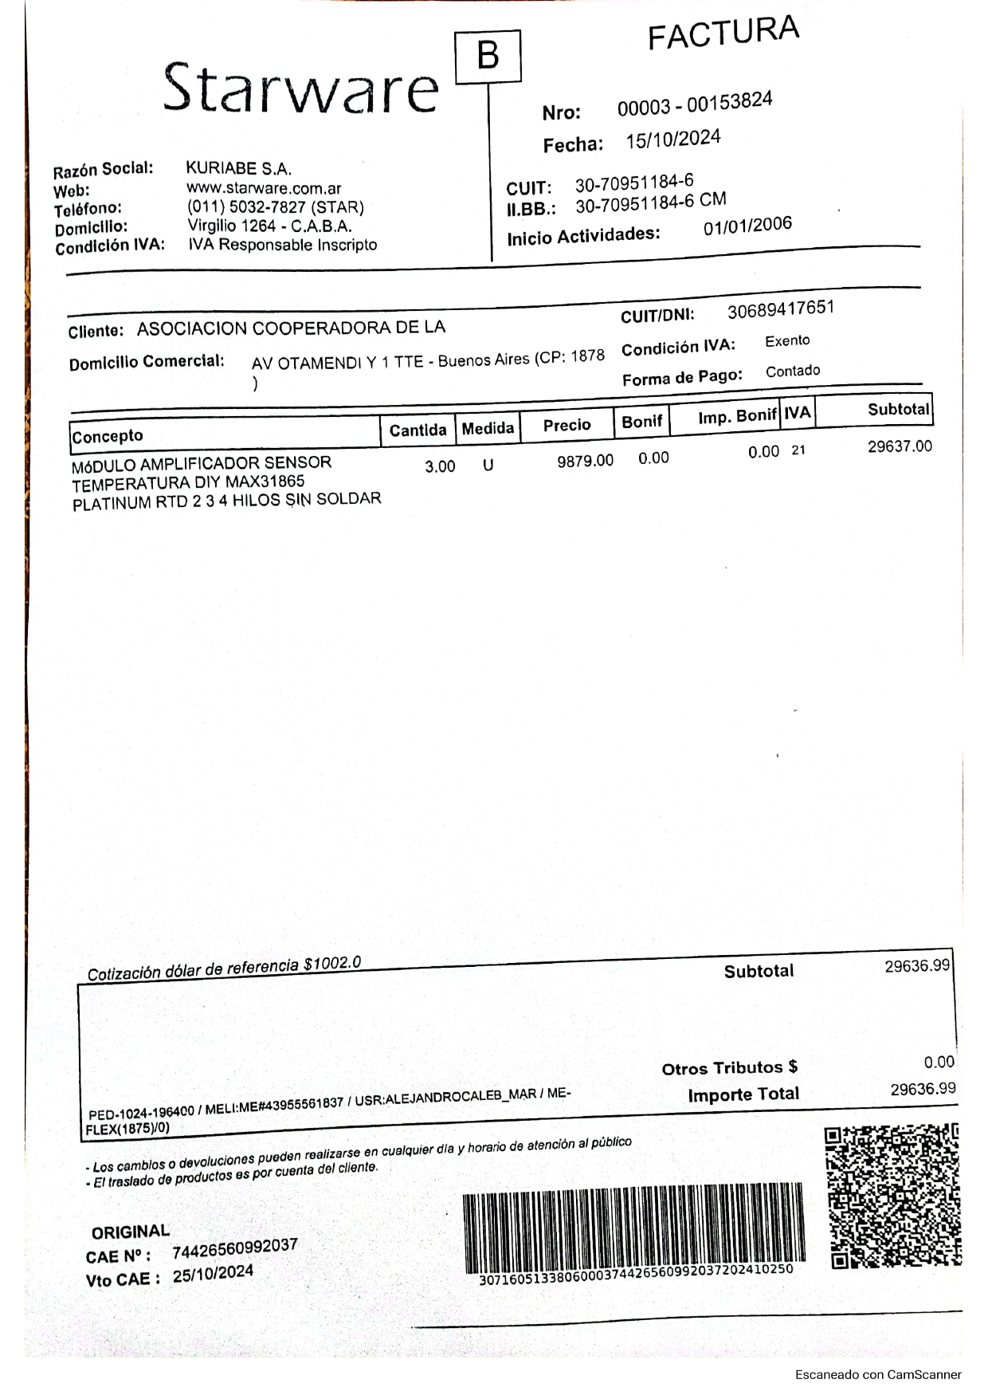
Documentación/Documentos administrativos/Facturas - RevControl/15-10-24.jpg
