impatrq/revcontrol/Documentación/Documentos administrativos/Facturas - RevControl/18-09-24.jpg

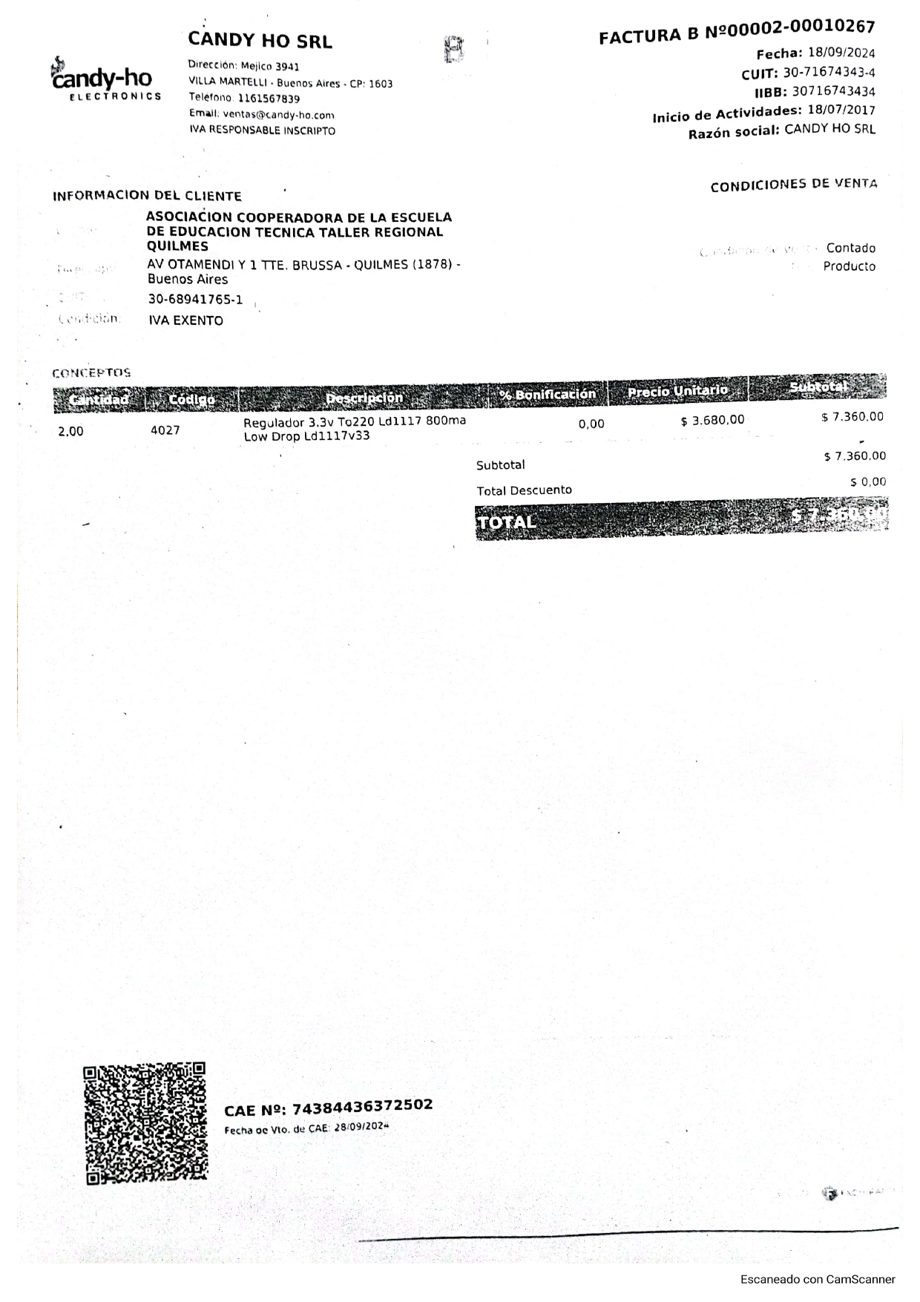
Documentación/Documentos administrativos/Facturas - RevControl/18-09-24.jpg
