impatrq/revcontrol/Documentación/Documentos administrativos/Facturas - RevControl/Vales.jpeg

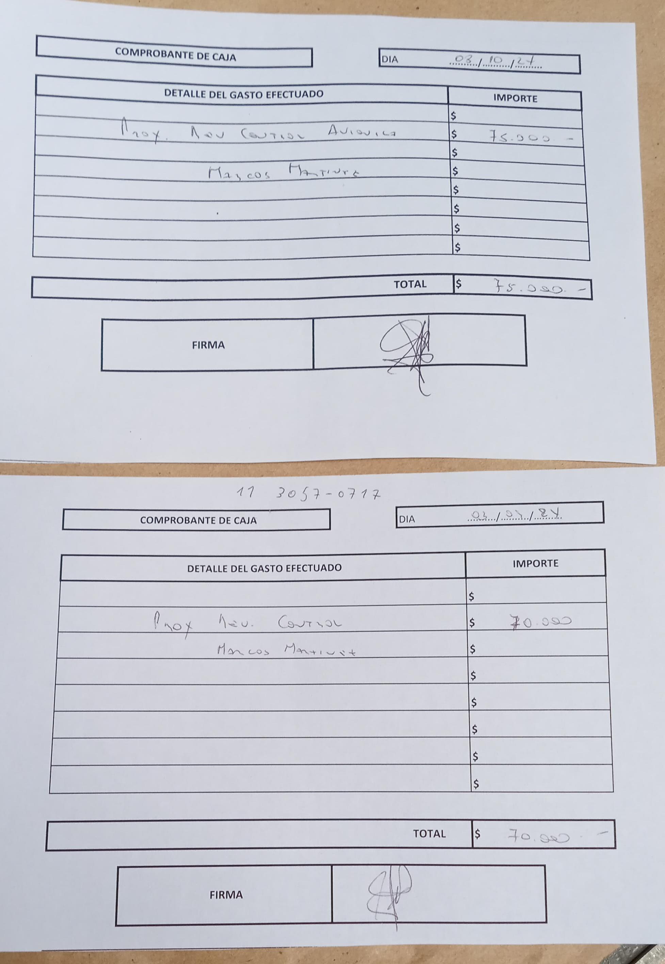
Documentación/Documentos administrativos/Facturas - RevControl/Vales.jpeg
