impatrq/revcontrol/Electronica/Diagramas/Presión de aceite/Diagrama de presion de aceite.png

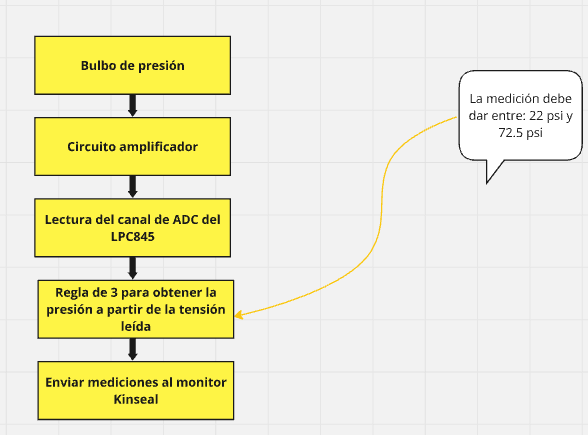
Electronica/Diagramas/Presión de aceite/Diagrama de presion de aceite.png
