impatrq/revcontrol/Electronica/Diagramas/Presión de aceite/Prototipo.png

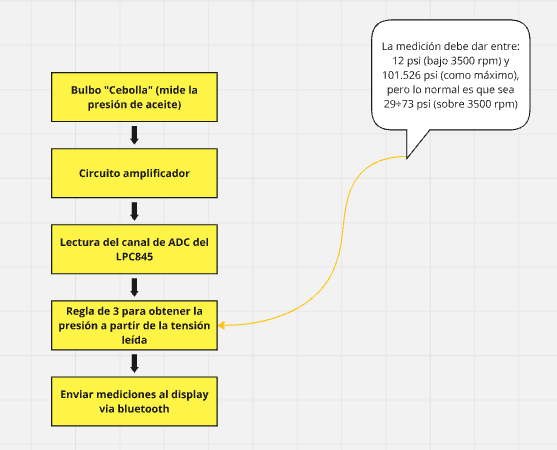
Electronica/Diagramas/Presión de aceite/Prototipo.png
