impatrq/revcontrol/Electronica/Diagramas/Sensor de temperatura/Diagrama sensor de temperatura.png

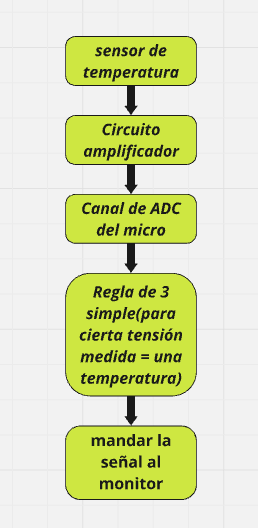
Electronica/Diagramas/Sensor de temperatura/Diagrama sensor de temperatura.png
