impatrq/revcontrol/Electronica/Diagramas/Sensor de temperatura/Prototipo.png

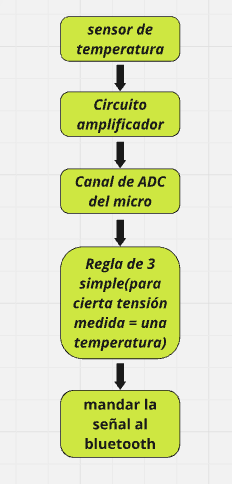
Electronica/Diagramas/Sensor de temperatura/Prototipo.png
