impatrq/revcontrol/Electronica/Diseños PCB-PDFs/Acondicionador de señal FISICO.jpeg

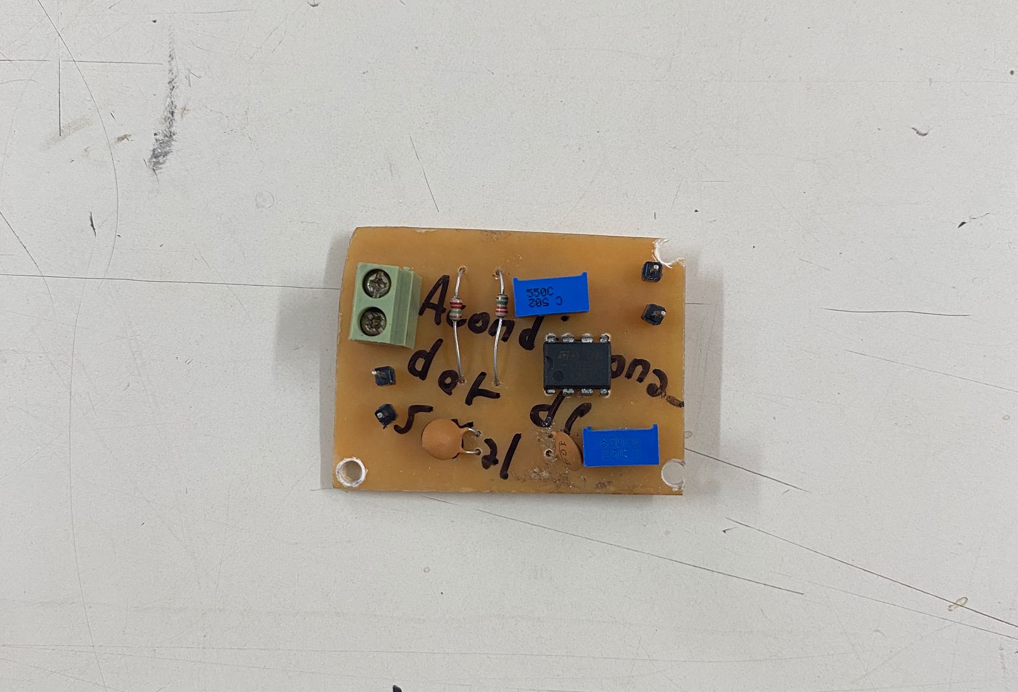
Electronica/Diseños PCB-PDFs/Acondicionador de señal FISICO.jpeg
