impatrq/revcontrol/Electronica/Diseños PCB-PDFs/Placa Comparador LM311 FISICO.jpeg

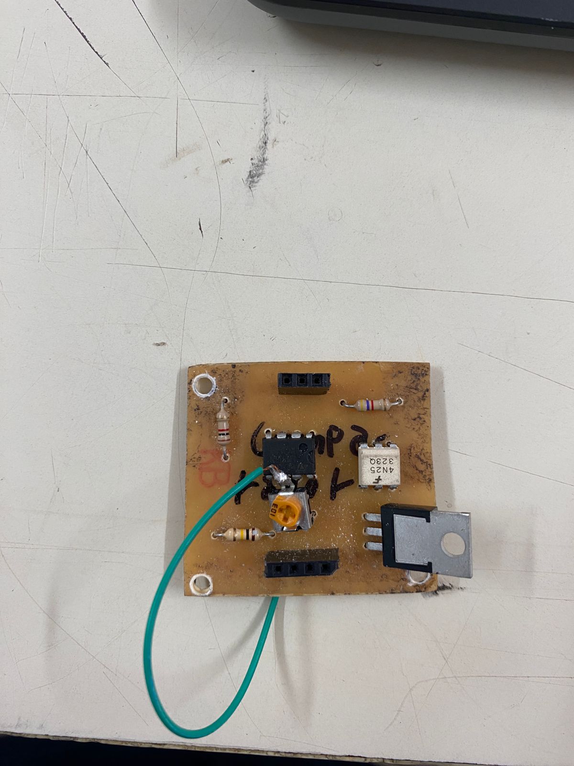
Electronica/Diseños PCB-PDFs/Placa Comparador LM311 FISICO.jpeg
