impatrq/revcontrol/Electronica/Diseños PCB-PDFs/Placa de alertas FISICO.jpeg

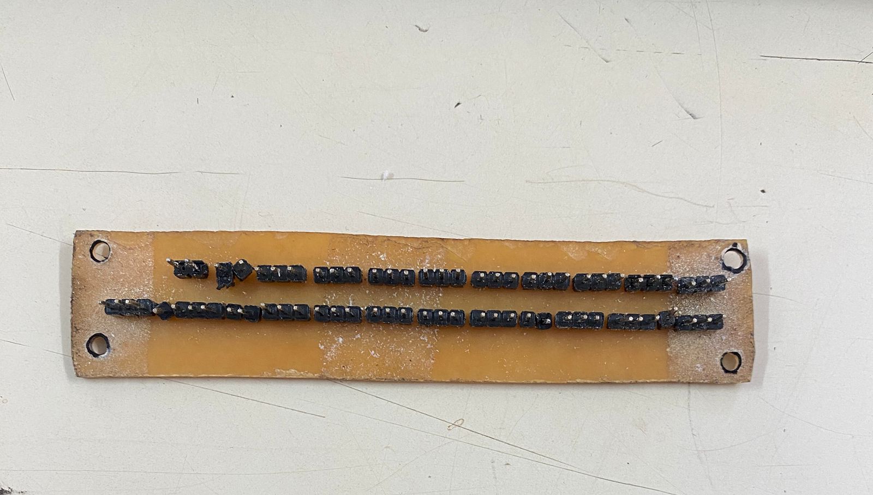
Electronica/Diseños PCB-PDFs/Placa de alertas FISICO.jpeg
