impatrq/revcontrol/Electronica/Diseños PCB-PDFs/PLACA PCB AD620 FISICA.jpeg

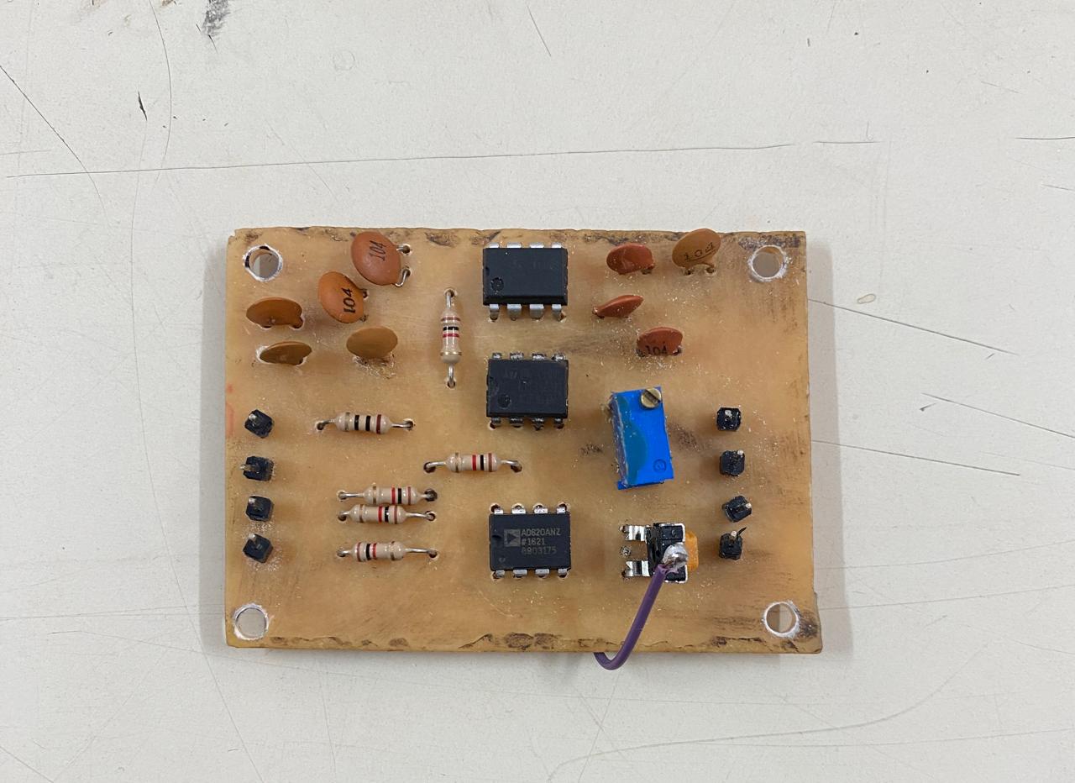
Electronica/Diseños PCB-PDFs/PLACA PCB AD620 FISICA.jpeg
