impatrq/revcontrol/Electronica/Diseños PCB-PDFs/PLACA PCB DIVISOR DE VOLTAJE FINALIZADA.jpeg

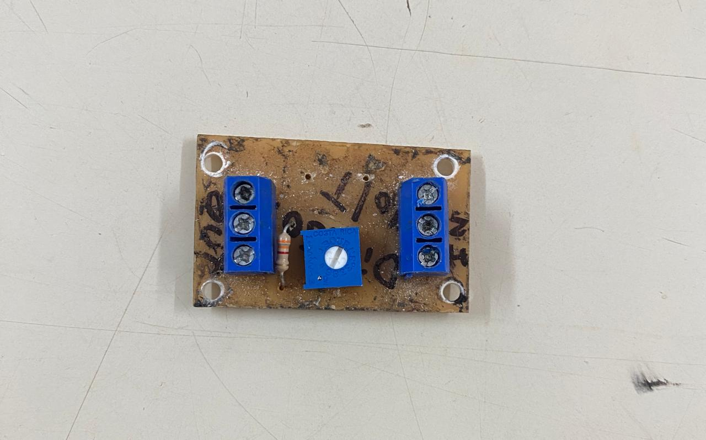
Electronica/Diseños PCB-PDFs/PLACA PCB DIVISOR DE VOLTAJE FINALIZADA.jpeg
