impatrq/revcontrol/Electronica/Diseños PCB-PDFs/PLACA PCB LPC FINALIZADA.jpeg

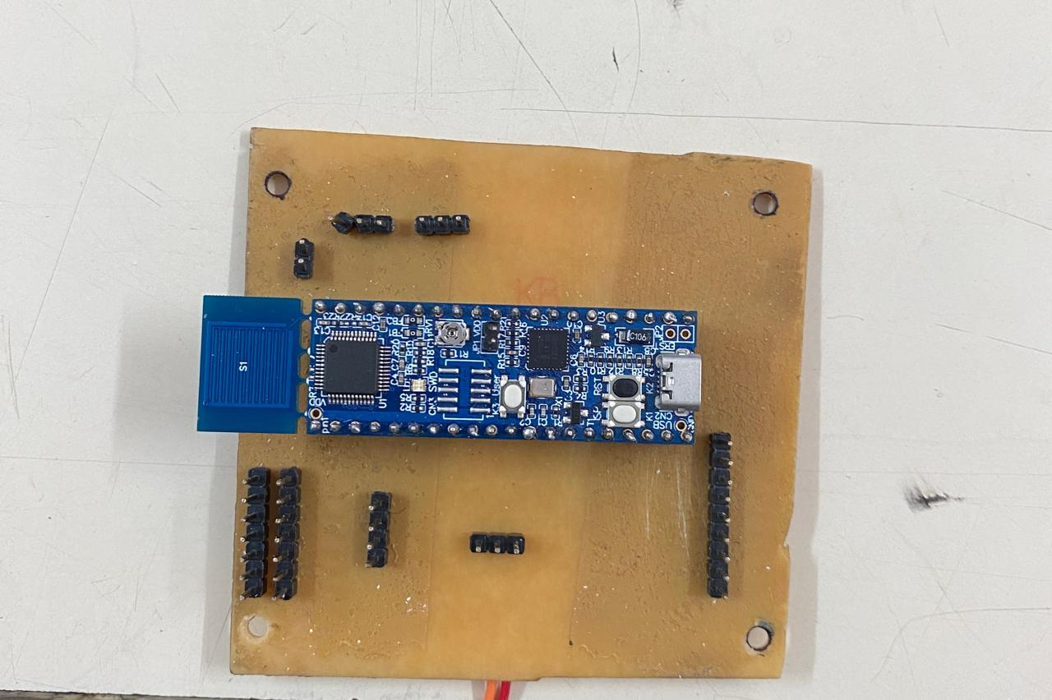
Electronica/Diseños PCB-PDFs/PLACA PCB LPC FINALIZADA.jpeg
