impatrq/revcontrol/Electronica/Esquemas y Modelo 3D Incluido/ACONDICIONADOR DE SEÑAL/captura1.png

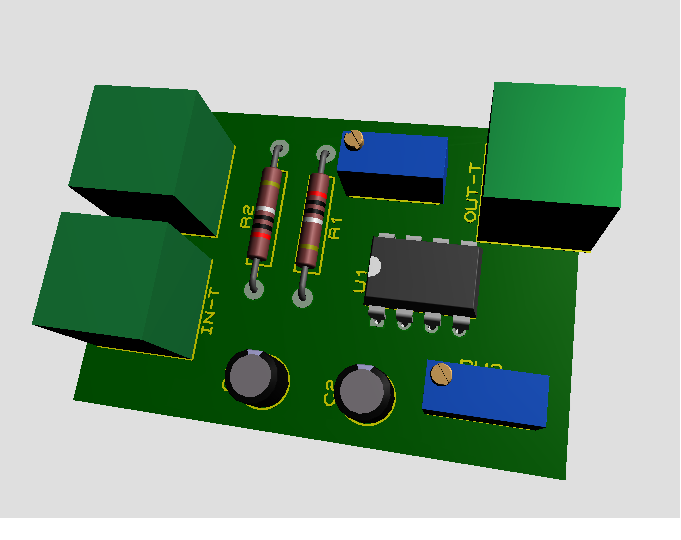
Electronica/Esquemas y Modelo 3D Incluido/ACONDICIONADOR DE SEÑAL/captura1.png
