impatrq/revcontrol/Electronica/Esquemas y Modelo 3D Incluido/ACONDICIONADOR DE SEÑAL/captura2.png

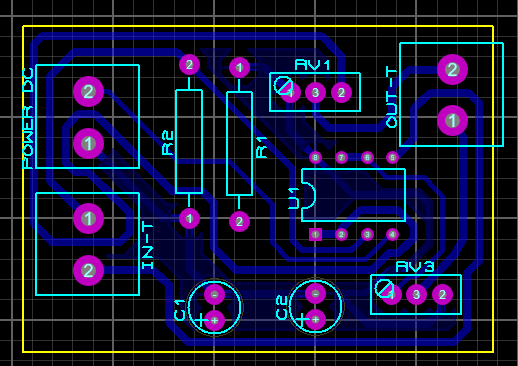
Electronica/Esquemas y Modelo 3D Incluido/ACONDICIONADOR DE SEÑAL/captura2.png
