impatrq/revcontrol/Electronica/Esquemas y Modelo 3D Incluido/ALARMAS/BUZZER PARA ALERTA SONORA.jpeg

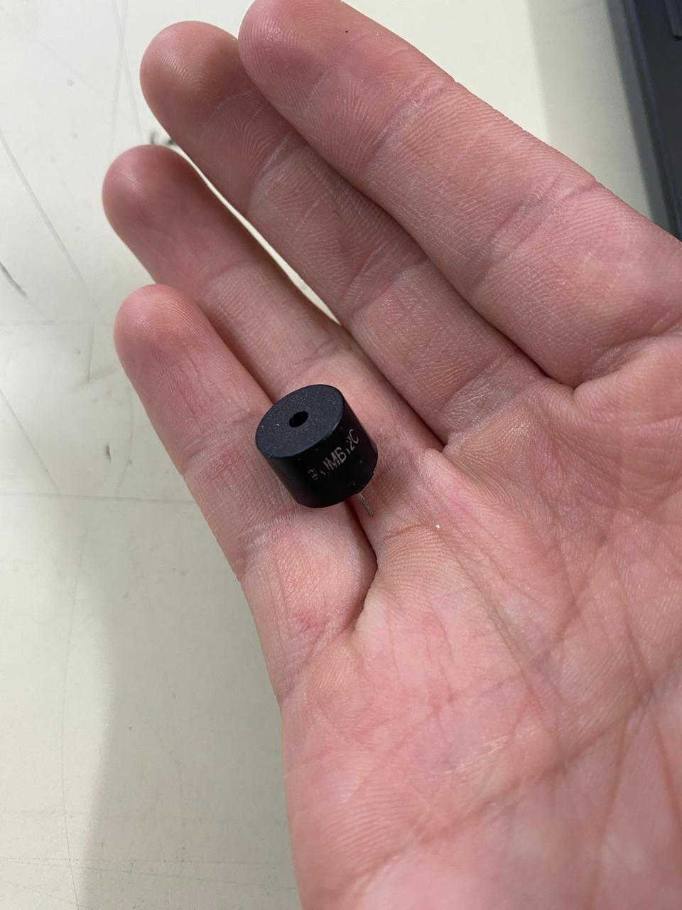
Electronica/Esquemas y Modelo 3D Incluido/ALARMAS/BUZZER PARA ALERTA SONORA.jpeg
