impatrq/revcontrol/Electronica/Esquemas y Modelo 3D Incluido/ALARMAS/capturaa 2.PNG

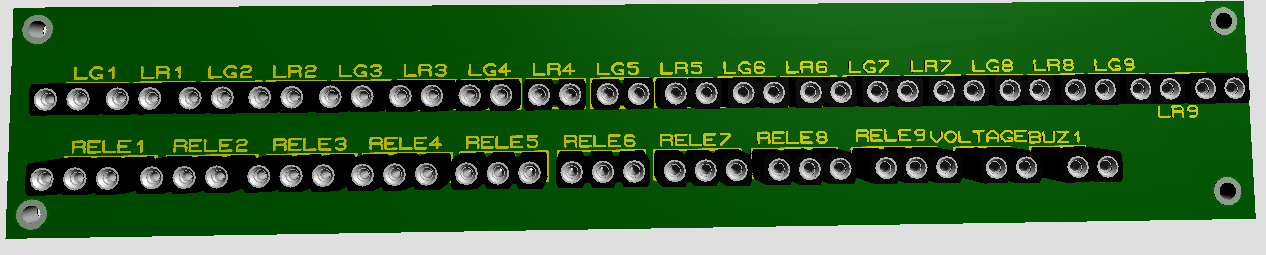
Electronica/Esquemas y Modelo 3D Incluido/ALARMAS/capturaa 2.PNG
