impatrq/revcontrol/Electronica/Esquemas y Modelo 3D Incluido/ALARMAS/CONEXIONES ALARMAS.jpeg

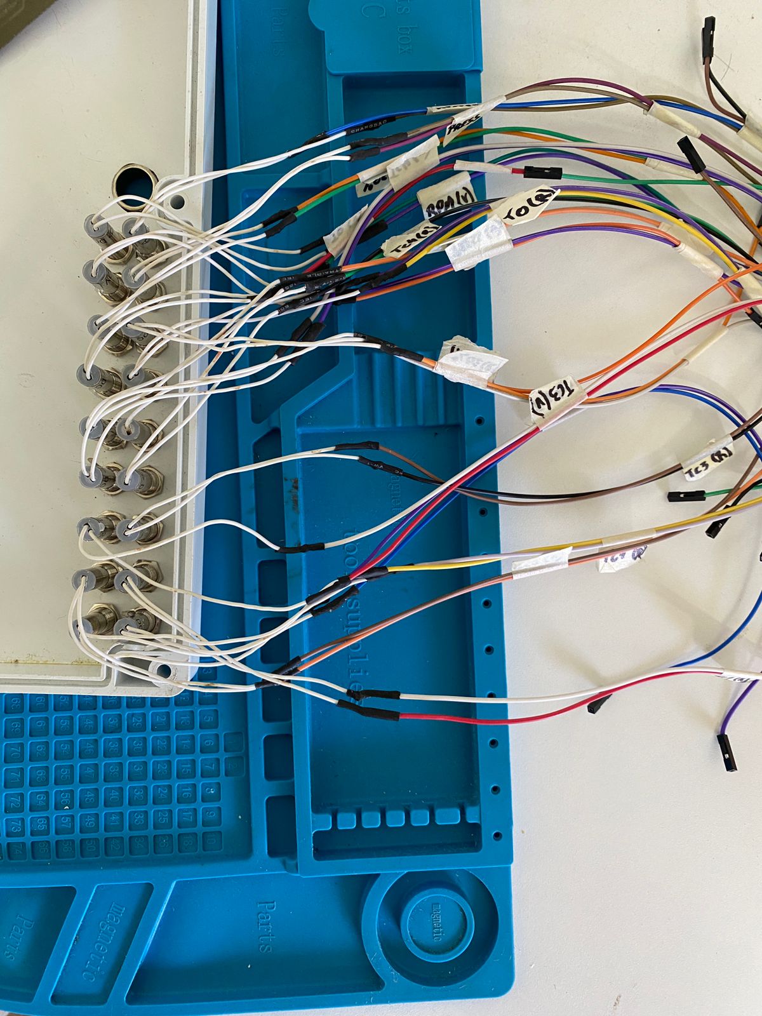
Electronica/Esquemas y Modelo 3D Incluido/ALARMAS/CONEXIONES ALARMAS.jpeg
