impatrq/revcontrol/Electronica/Esquemas y Modelo 3D Incluido/ALARMAS/OJOS DE BUEY ALERTAS.jpeg

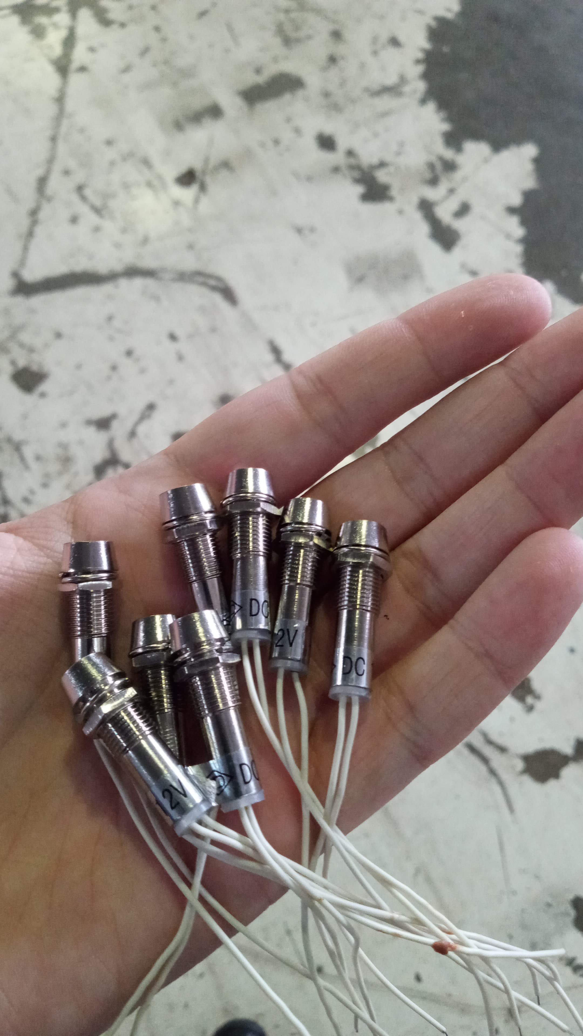
Electronica/Esquemas y Modelo 3D Incluido/ALARMAS/OJOS DE BUEY ALERTAS.jpeg
