impatrq/revcontrol/Electronica/Esquemas y Modelo 3D Incluido/AMPLIFICADOR AD620/captura1.png

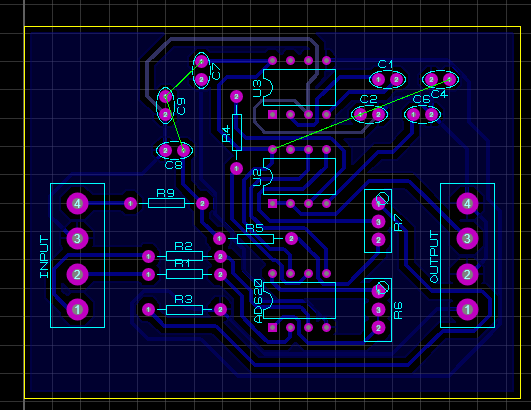
Electronica/Esquemas y Modelo 3D Incluido/AMPLIFICADOR AD620/captura1.png
