impatrq/revcontrol/Electronica/Esquemas y Modelo 3D Incluido/AMPLIFICADOR AD620/captura2.png

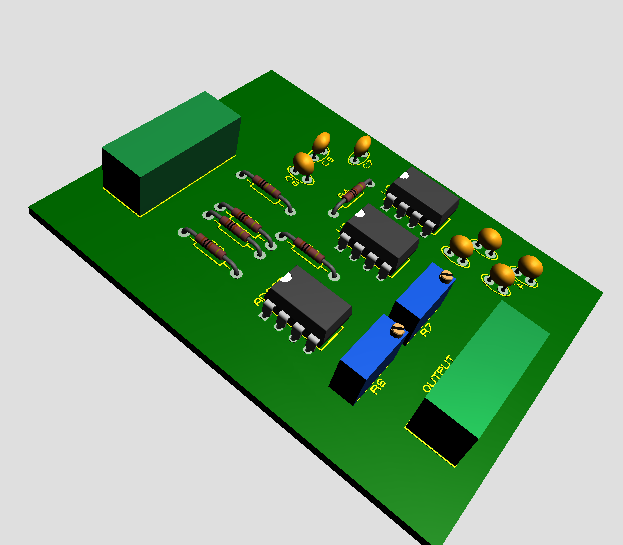
Electronica/Esquemas y Modelo 3D Incluido/AMPLIFICADOR AD620/captura2.png
