impatrq/revcontrol/Electronica/Esquemas y Modelo 3D Incluido/COMPARADOR DE RPM/Captura 1.PNG

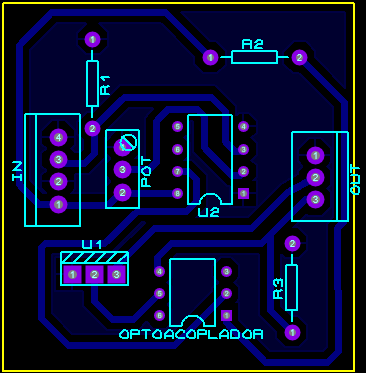
Electronica/Esquemas y Modelo 3D Incluido/COMPARADOR DE RPM/Captura 1.PNG
