impatrq/revcontrol/Electronica/Esquemas y Modelo 3D Incluido/COMPARADOR DE RPM/captura 2.PNG

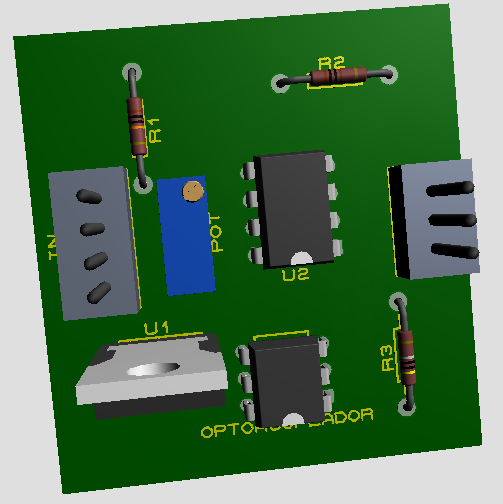
Electronica/Esquemas y Modelo 3D Incluido/COMPARADOR DE RPM/captura 2.PNG
