impatrq/revcontrol/Electronica/Esquemas y Modelo 3D Incluido/COMPARADOR PRESS ACEITE Y RPM (DESCARTADO)/comps1.PNG

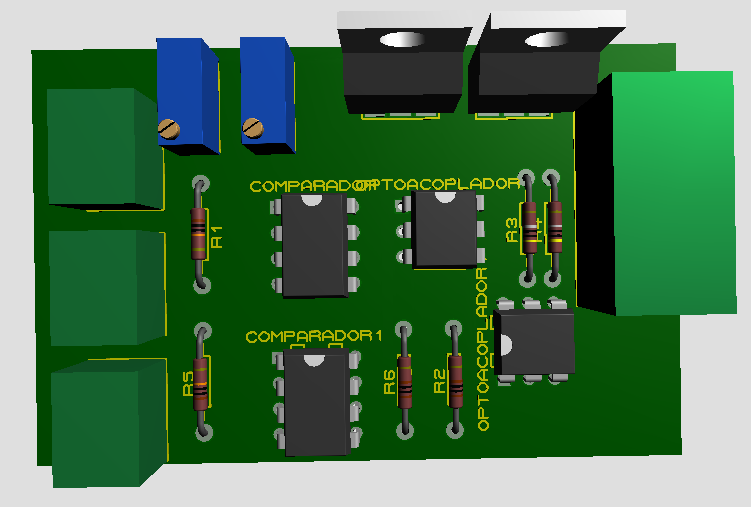
Electronica/Esquemas y Modelo 3D Incluido/COMPARADOR PRESS ACEITE Y RPM (DESCARTADO)/comps1.PNG
