impatrq/revcontrol/Electronica/Esquemas y Modelo 3D Incluido/DIVISOR DE VOLTAJE/captura 1.jpeg

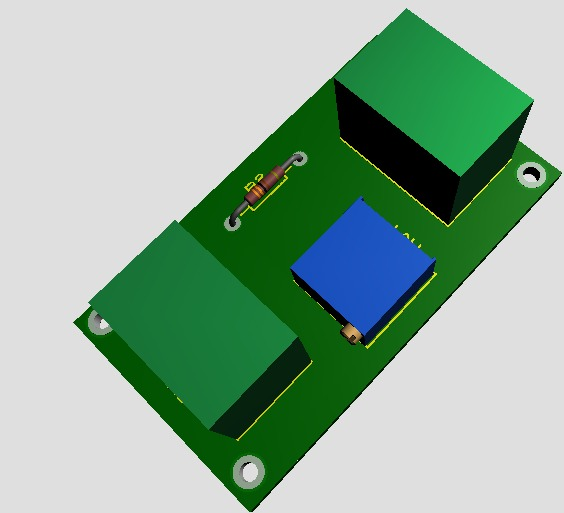
Electronica/Esquemas y Modelo 3D Incluido/DIVISOR DE VOLTAJE/captura 1.jpeg
