impatrq/revcontrol/Electronica/Esquemas y Modelo 3D Incluido/DIVISOR DE VOLTAJE/captura 2.jpeg

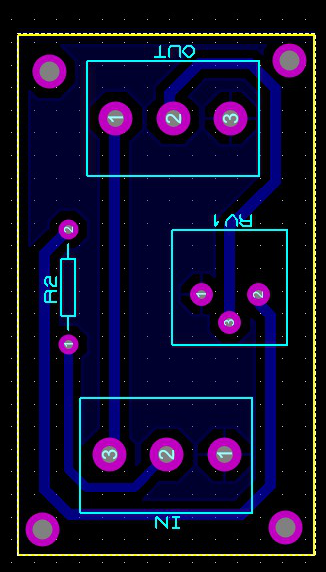
Electronica/Esquemas y Modelo 3D Incluido/DIVISOR DE VOLTAJE/captura 2.jpeg
