impatrq/revcontrol/Electronica/Esquemas y Modelo 3D Incluido/PLACA LPC/captura 1.jpeg

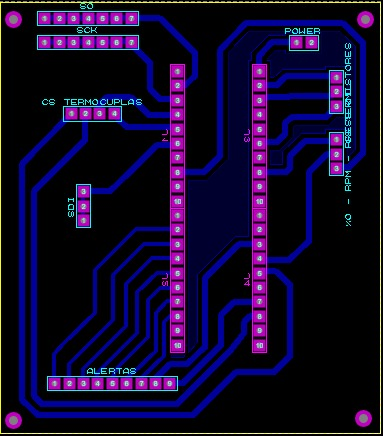
Electronica/Esquemas y Modelo 3D Incluido/PLACA LPC/captura 1.jpeg
