impatrq/revcontrol/Electronica/Esquemas y Modelo 3D Incluido/PLACA LPC/captura 2.jpeg

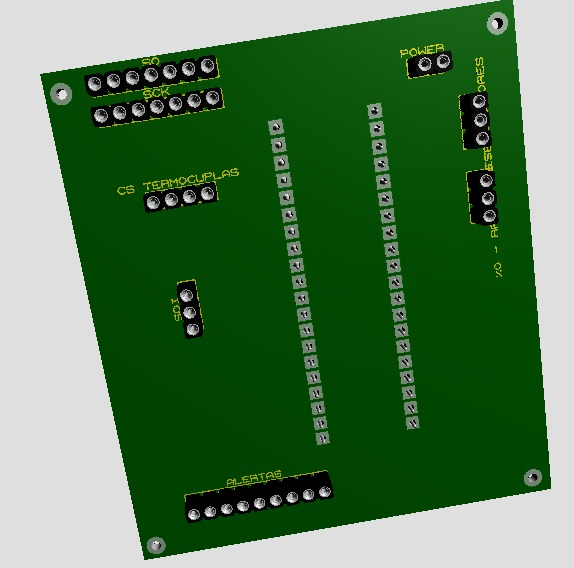
Electronica/Esquemas y Modelo 3D Incluido/PLACA LPC/captura 2.jpeg
