impatrq/revcontrol/Estructura/Colocación de placas en los acrilicos/Colocacion de placas en acrilico inferior.jpeg

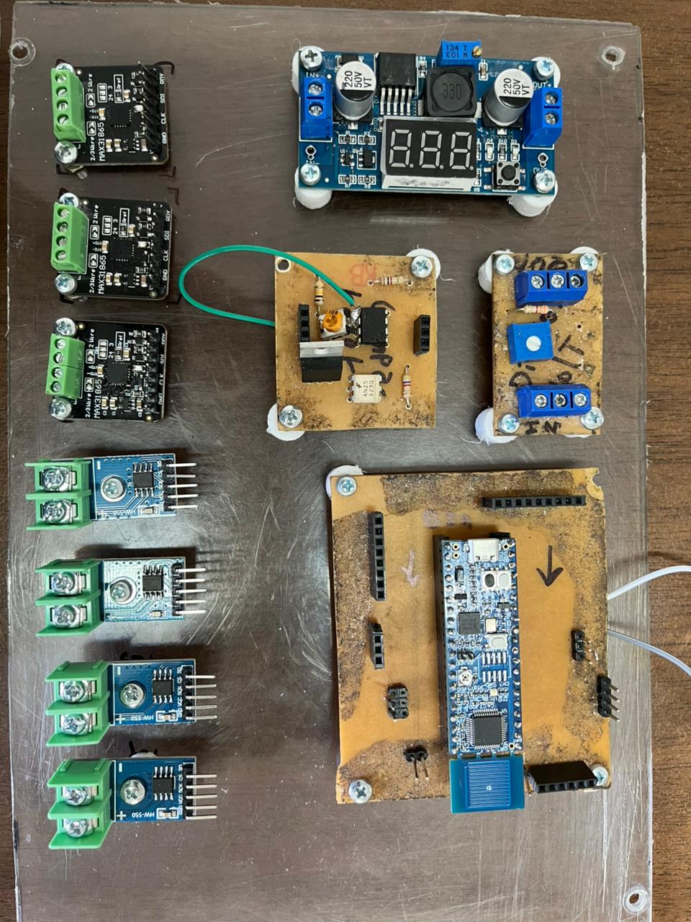
Estructura/Colocación de placas en los acrilicos/Colocacion de placas en acrilico inferior.jpeg
