impatrq/revcontrol/Estructura/Colocación de placas en los acrilicos/Colocacion de placas en acrilico superior.jpeg

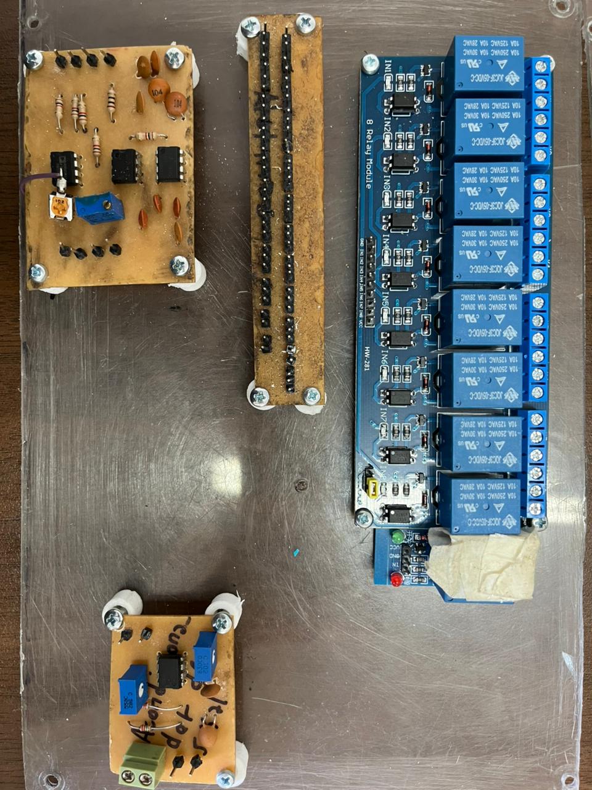
Estructura/Colocación de placas en los acrilicos/Colocacion de placas en acrilico superior.jpeg
