impatrq/revcontrol/Estructura/Modelo 3D de maletín/Primer plano de maletín.jpeg

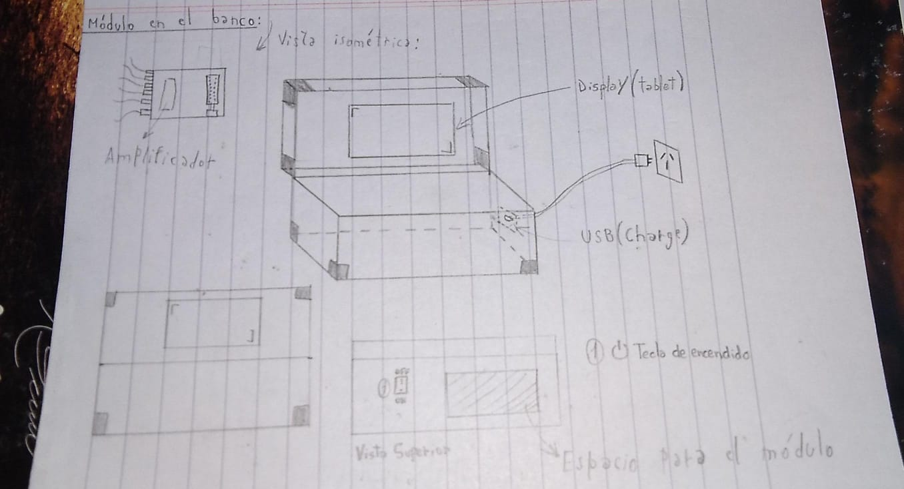
Estructura/Modelo 3D de maletín/Primer plano de maletín.jpeg
