impatrq/revcontrol/Estructura/Modulo de lectura/Modulo de lectura con especificaciones.jpeg

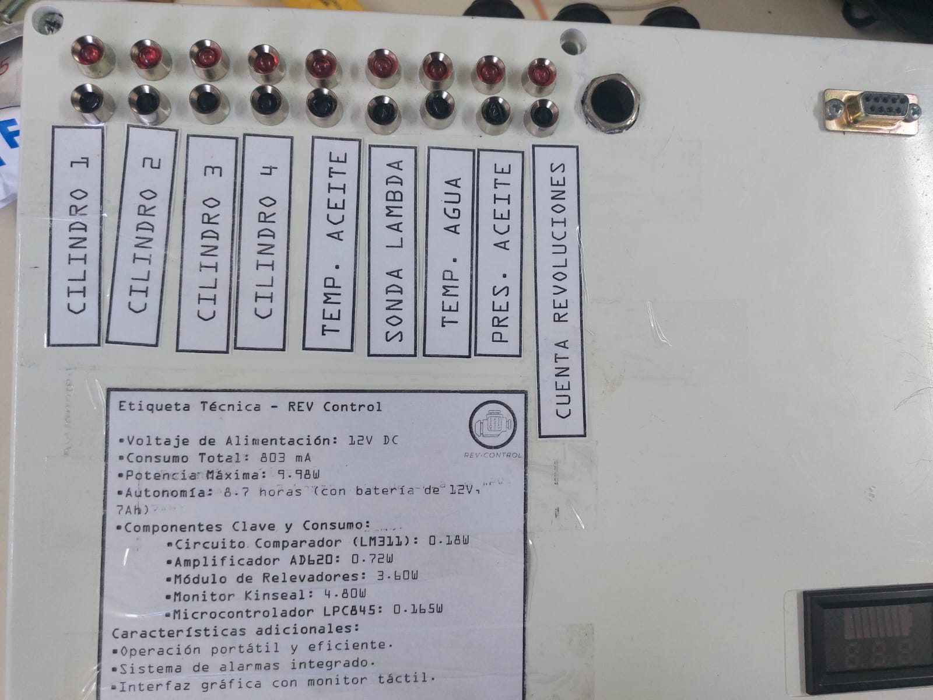
Estructura/Modulo de lectura/Modulo de lectura con especificaciones.jpeg
