impatrq/revcontrol/Estructura/Modulo de lectura/Primer prototipo de modulo de lectura.jpeg

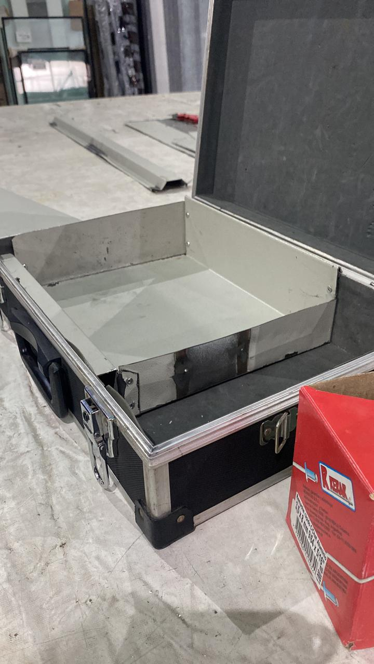
Estructura/Modulo de lectura/Primer prototipo de modulo de lectura.jpeg
