impatrq/revcontrol/Estructura/Modulo de lectura/Sensores del modulo de lectura.jpeg

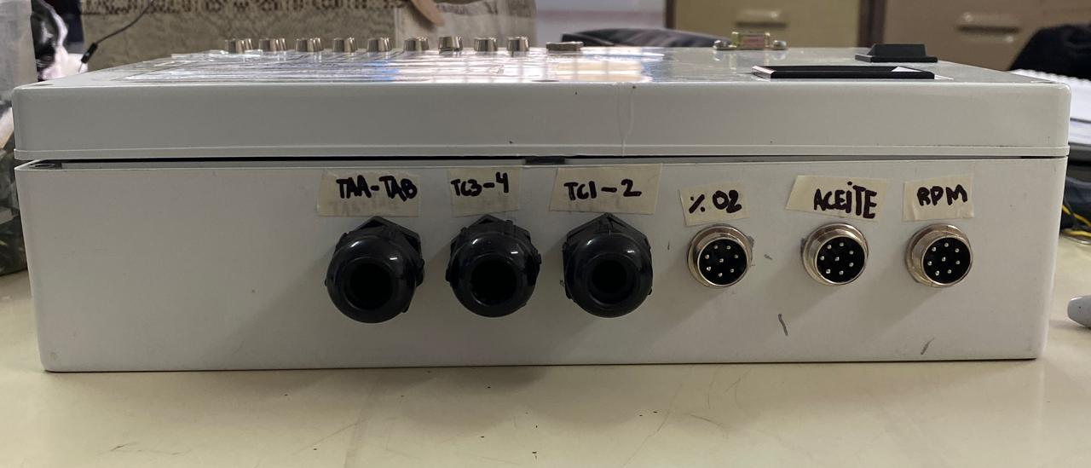
Estructura/Modulo de lectura/Sensores del modulo de lectura.jpeg
