impatrq/revcontrol/Estructura/Placa de acrilico/Base finalizada.jpg

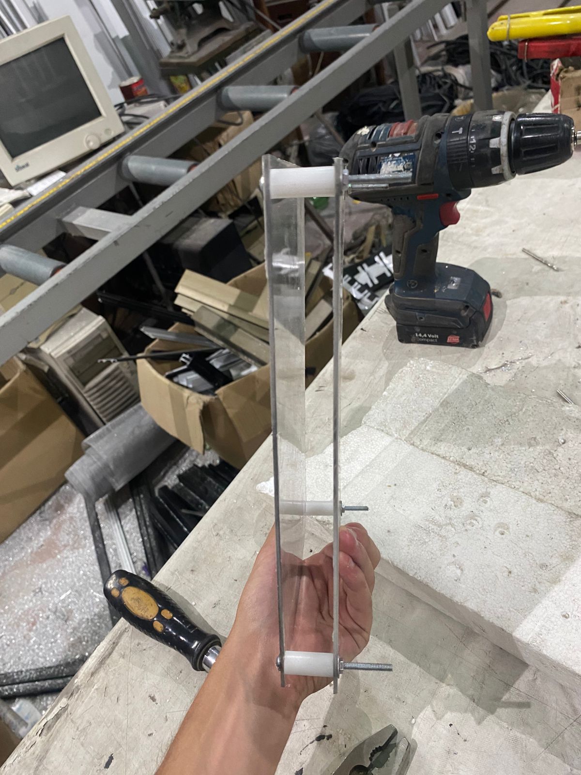
Estructura/Placa de acrilico/Base finalizada.jpg
