impatrq/revcontrol/Estructura/Placa de acrilico/Huecos en acrilicos.jpeg

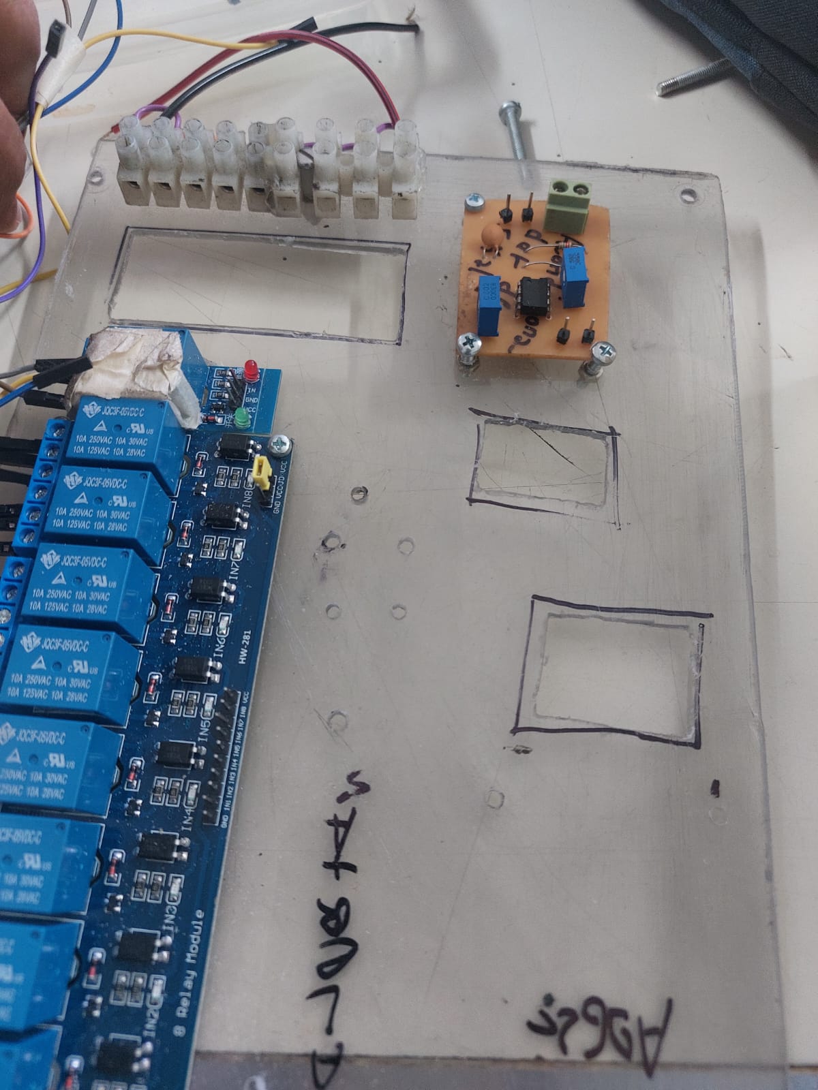
Estructura/Placa de acrilico/Huecos en acrilicos.jpeg
