impatrq/revcontrol/Estructura/Placa de acrilico/Placas de acrilico (Medidas).png

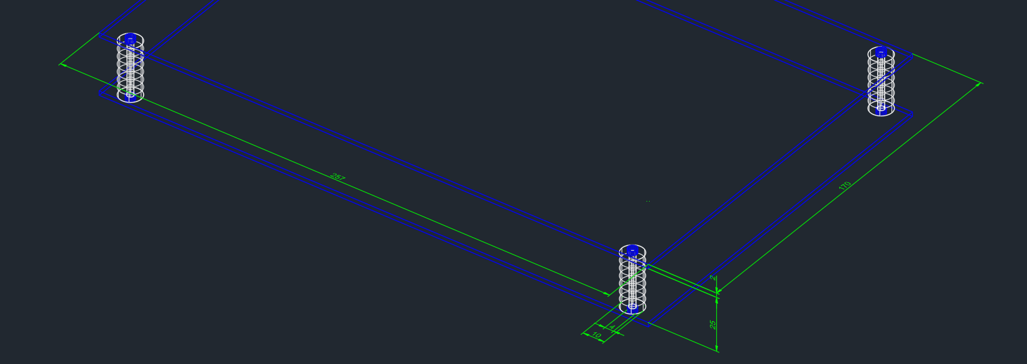
Estructura/Placa de acrilico/Placas de acrilico (Medidas).png
