impatrq/revcontrol/Estructura/Placa de acrilico/Placas de acrilico (Modelo completo).png

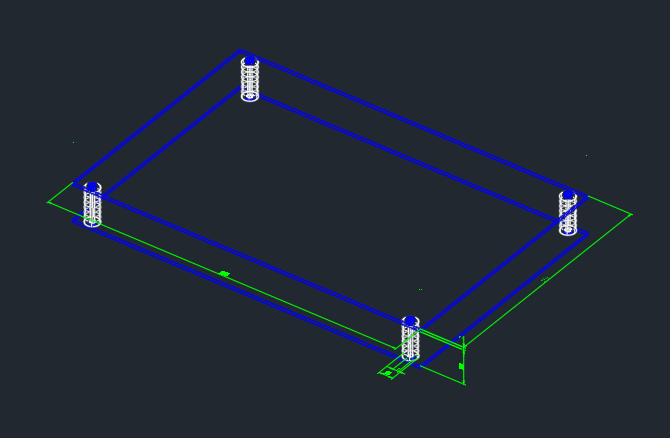
Estructura/Placa de acrilico/Placas de acrilico (Modelo completo).png
