impatrq/revcontrol/Estructura/Placa de acrilico/Primer modelo de placas de acrilico.jpg

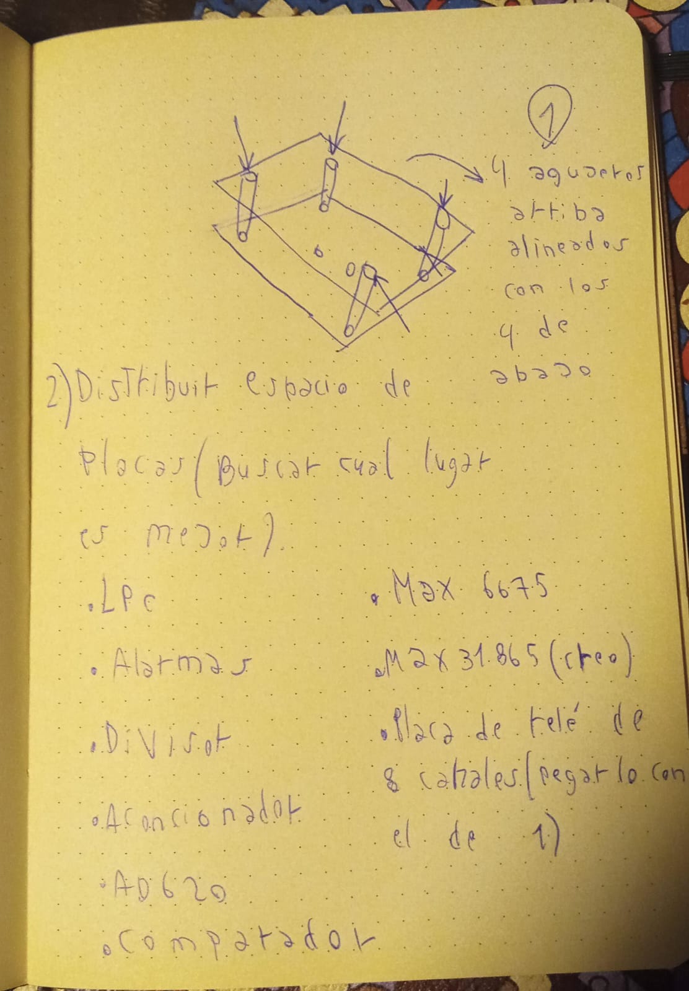
Estructura/Placa de acrilico/Primer modelo de placas de acrilico.jpg
