impatrq/revcontrol/Estructura/Placa de acrilico/Vista Frontal.png

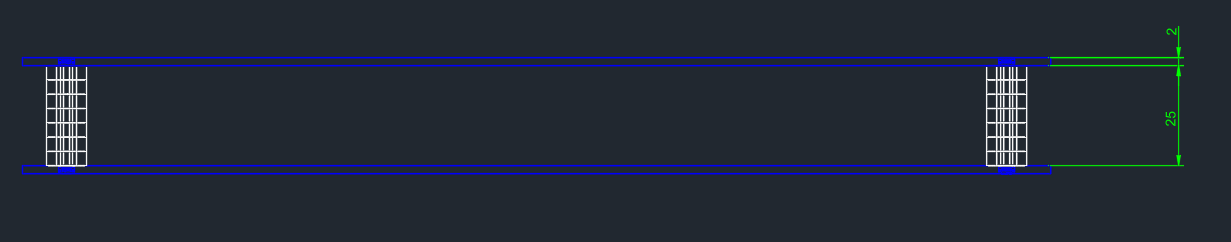
Estructura/Placa de acrilico/Vista Frontal.png
