impatrq/revcontrol/Estructura/Placa de acrilico/Vista Superior.png

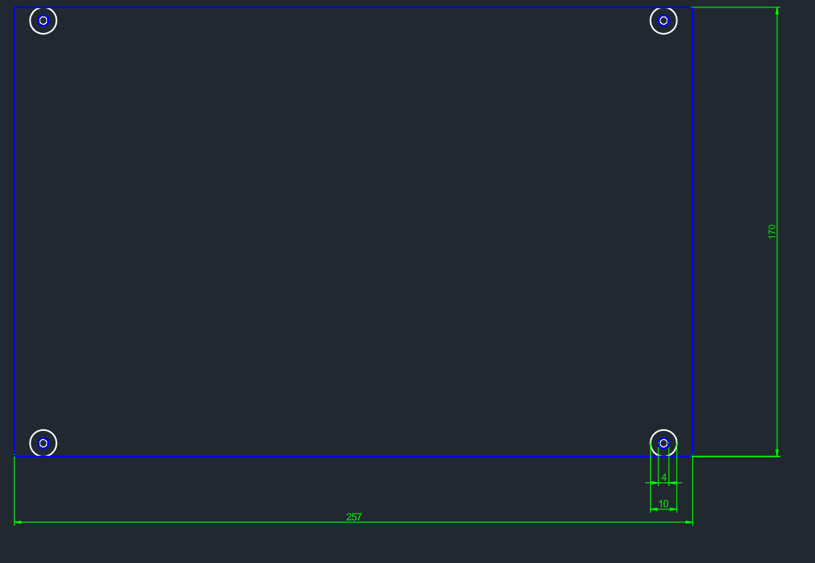
Estructura/Placa de acrilico/Vista Superior.png
