impatrq/revcontrol/Estructura/Soporte de monitor/Madera cortada para monitor y switch.jpeg

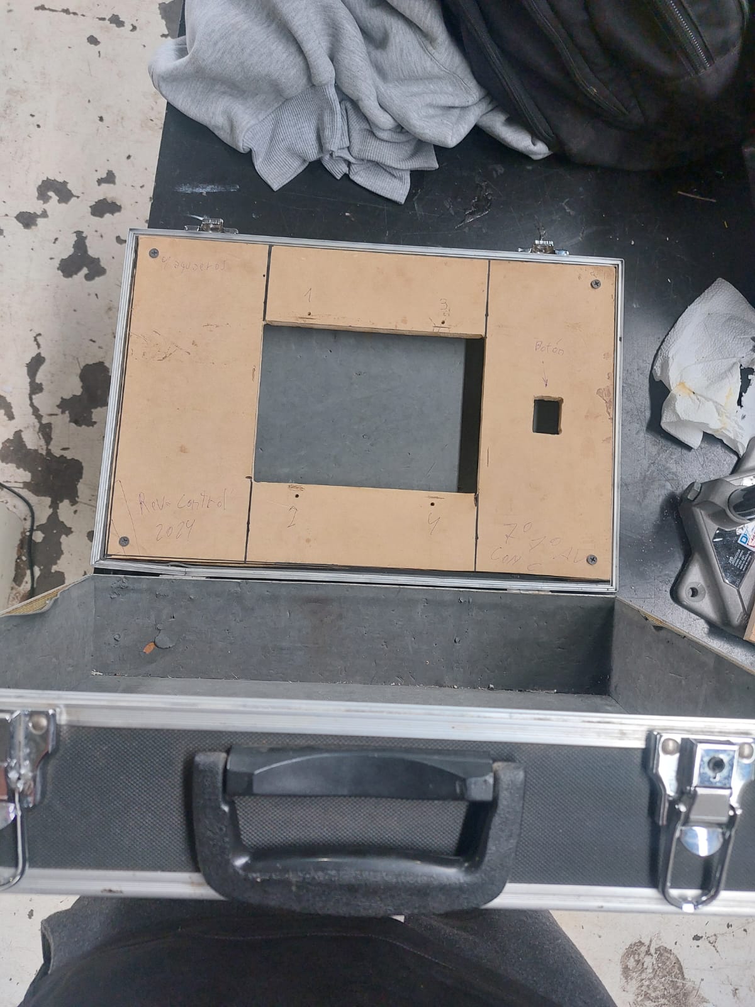
Estructura/Soporte de monitor/Madera cortada para monitor y switch.jpeg
