impatrq/revcontrol/Estructura/Soporte de monitor/Madera para fijación.jpeg

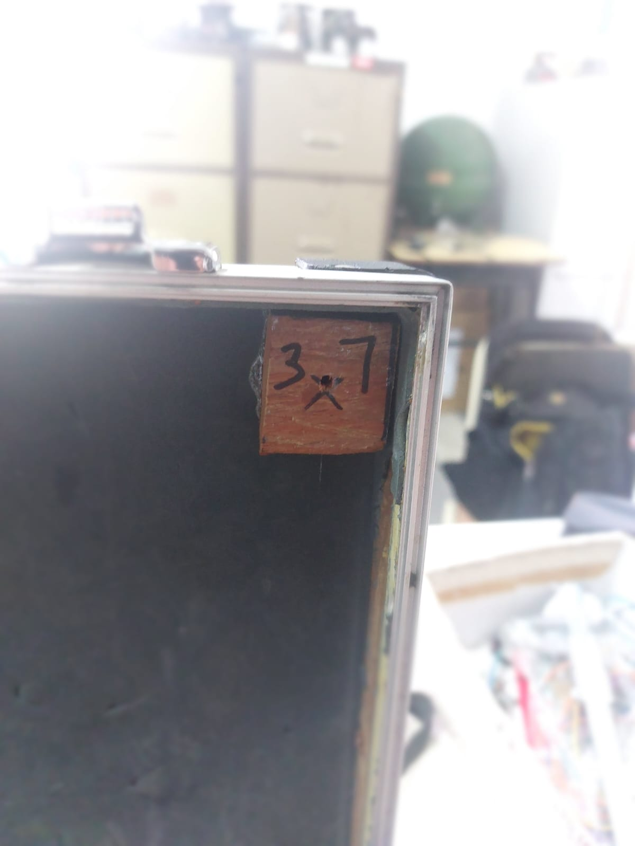
Estructura/Soporte de monitor/Madera para fijación.jpeg
