impatrq/revcontrol/Estructura/Soporte de monitor/Nueva fijación a soporte para mayor estabilidad.jpeg

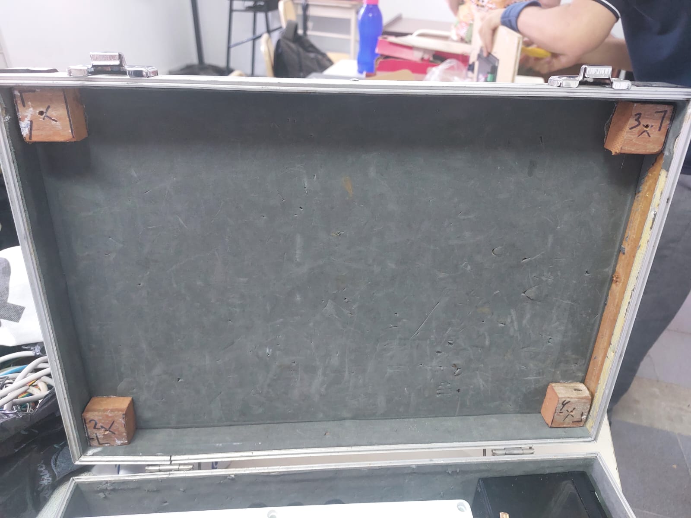
Estructura/Soporte de monitor/Nueva fijación a soporte para mayor estabilidad.jpeg
