impatrq/revcontrol/Estructura/Soporte de monitor/Soporte con monitor finalizado.jpg

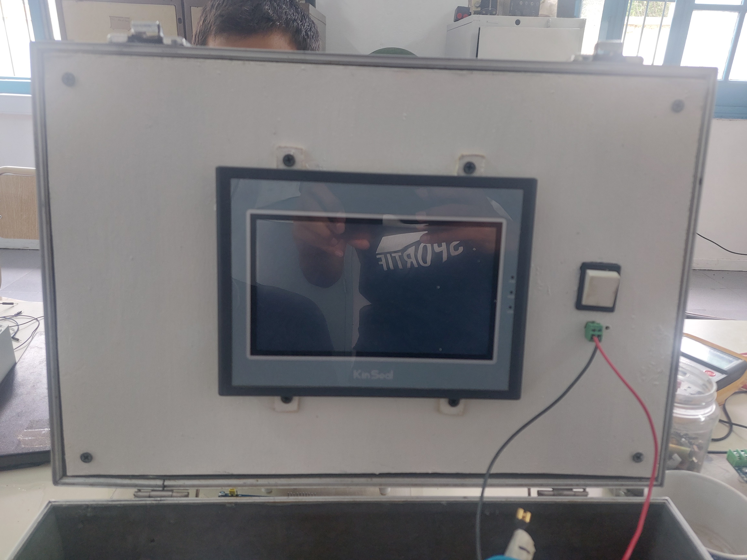
Estructura/Soporte de monitor/Soporte con monitor finalizado.jpg
