impatrq/revcontrol/Estructura/Soportes de placas/Cortando varilla.jpeg

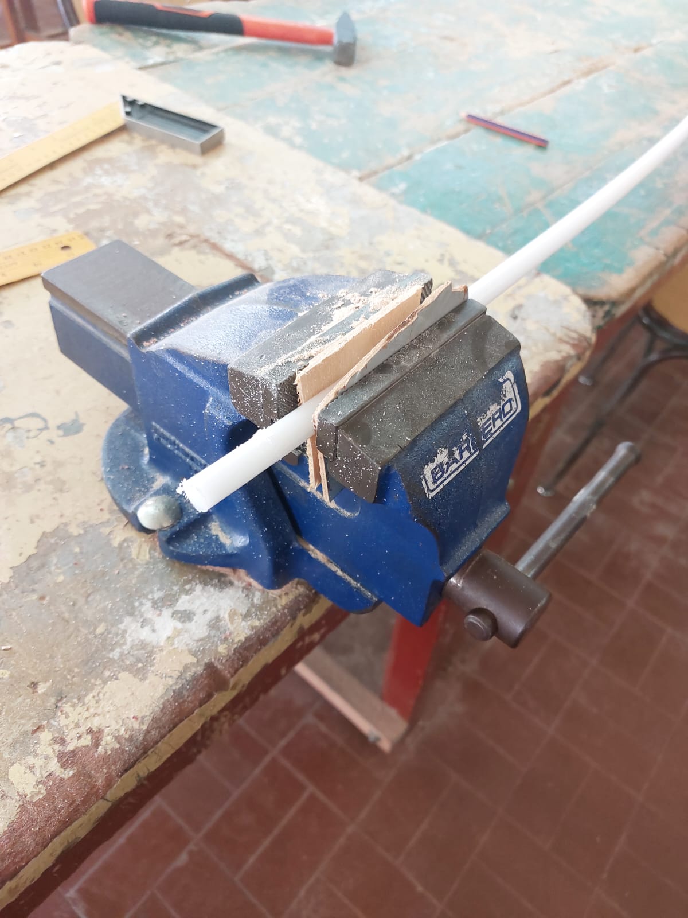
Estructura/Soportes de placas/Cortando varilla.jpeg
