impatrq/revcontrol/Estructura/Soportes de placas/Soportes finalizados.jpeg

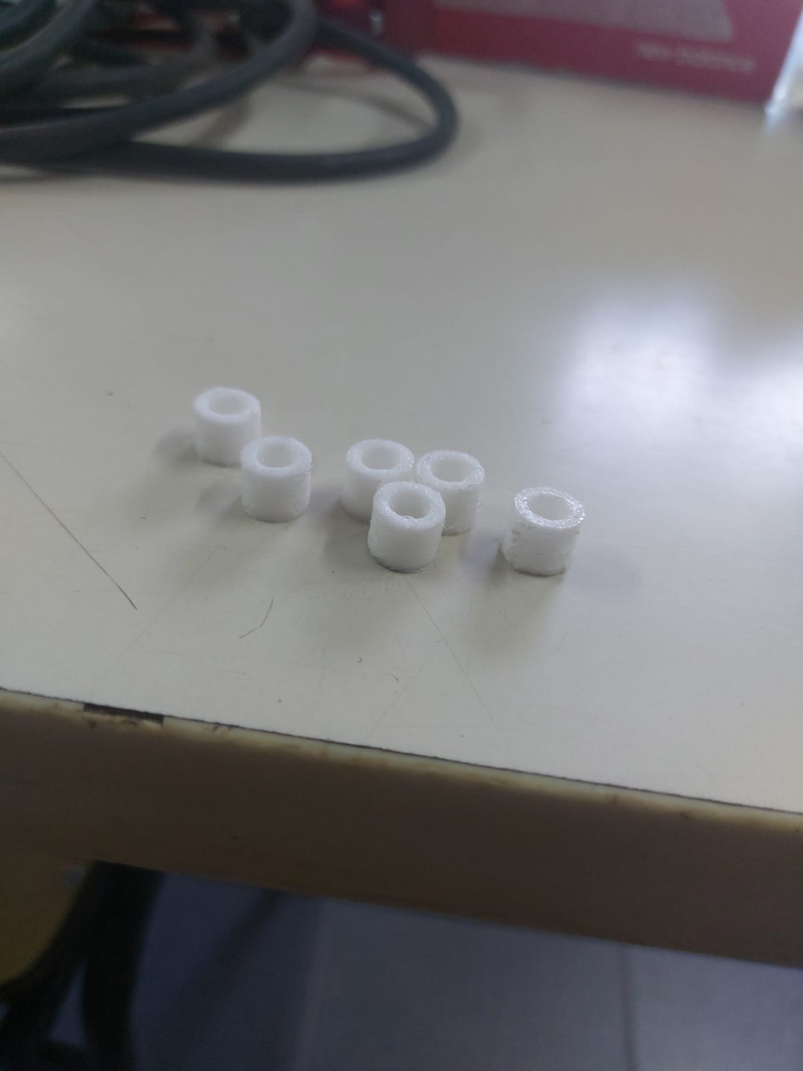
Estructura/Soportes de placas/Soportes finalizados.jpeg
