impatrq/revcontrol/Estructura/Soportes de placas/Torneando varilla.jpeg

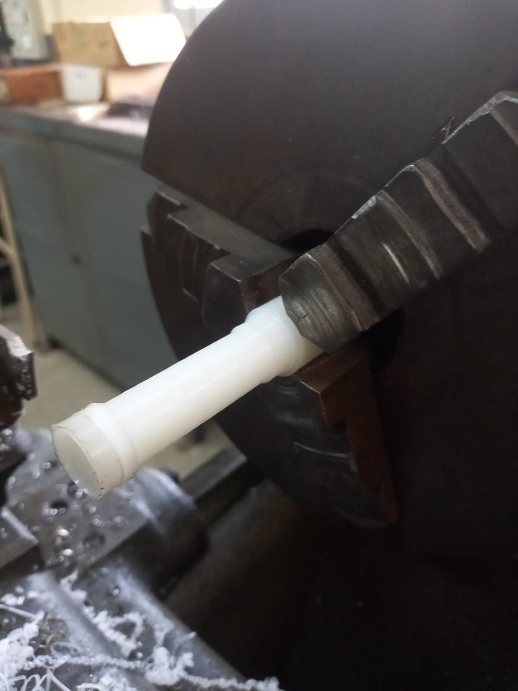
Estructura/Soportes de placas/Torneando varilla.jpeg
