impatrq/revcontrol/Estructura/Soportes de placas/Varilla recién comprada.jpeg

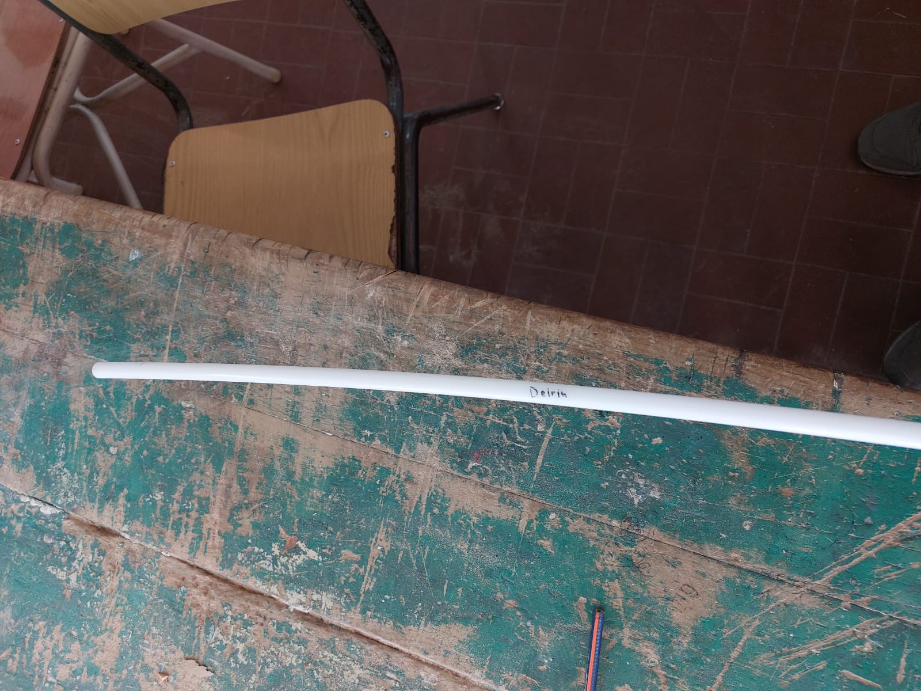
Estructura/Soportes de placas/Varilla recién comprada.jpeg
