impatrq/revcontrol/Pagina web/Concepto pagina/1.png

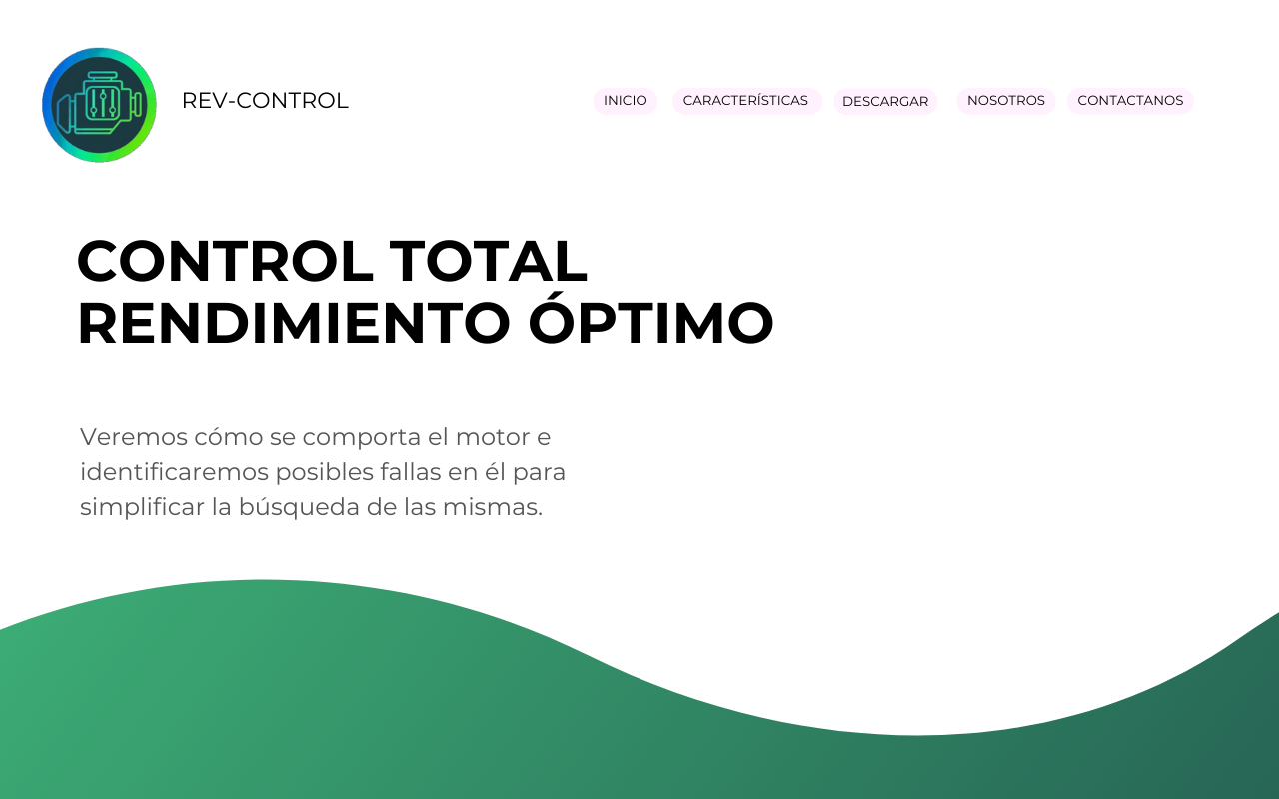
Pagina web/Concepto pagina/1.png
