impatrq/revcontrol/Pagina web/Concepto pagina/2.png

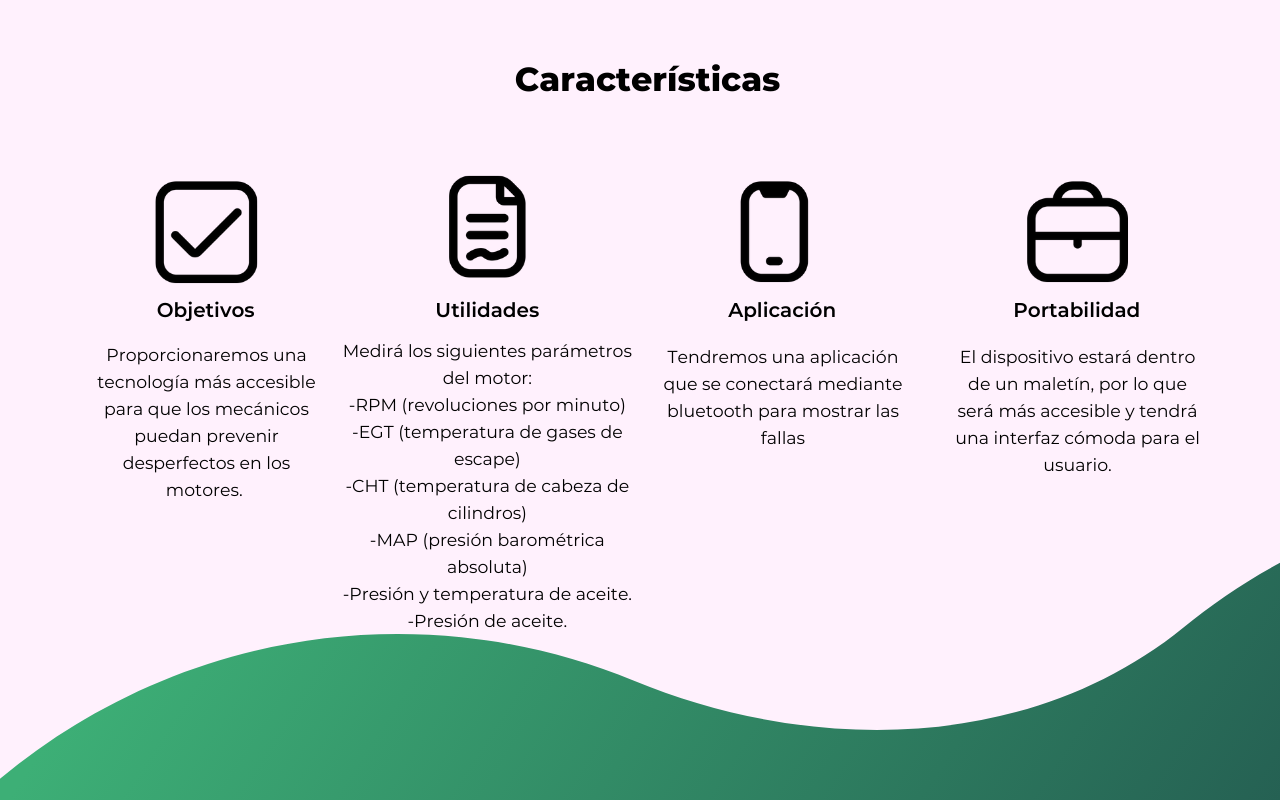
Pagina web/Concepto pagina/2.png
