impatrq/revcontrol/Pagina web/Concepto pagina/3.png

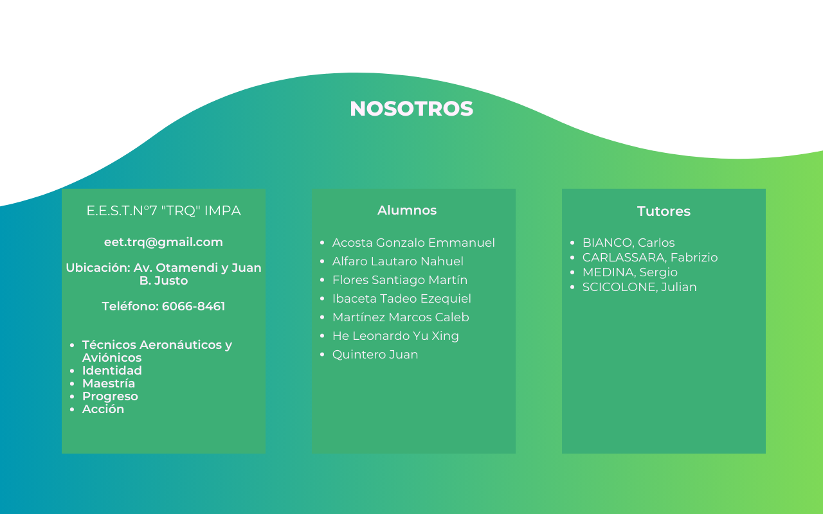
Pagina web/Concepto pagina/3.png
