impatrq/revcontrol/Pagina web/Concepto pagina/4.png

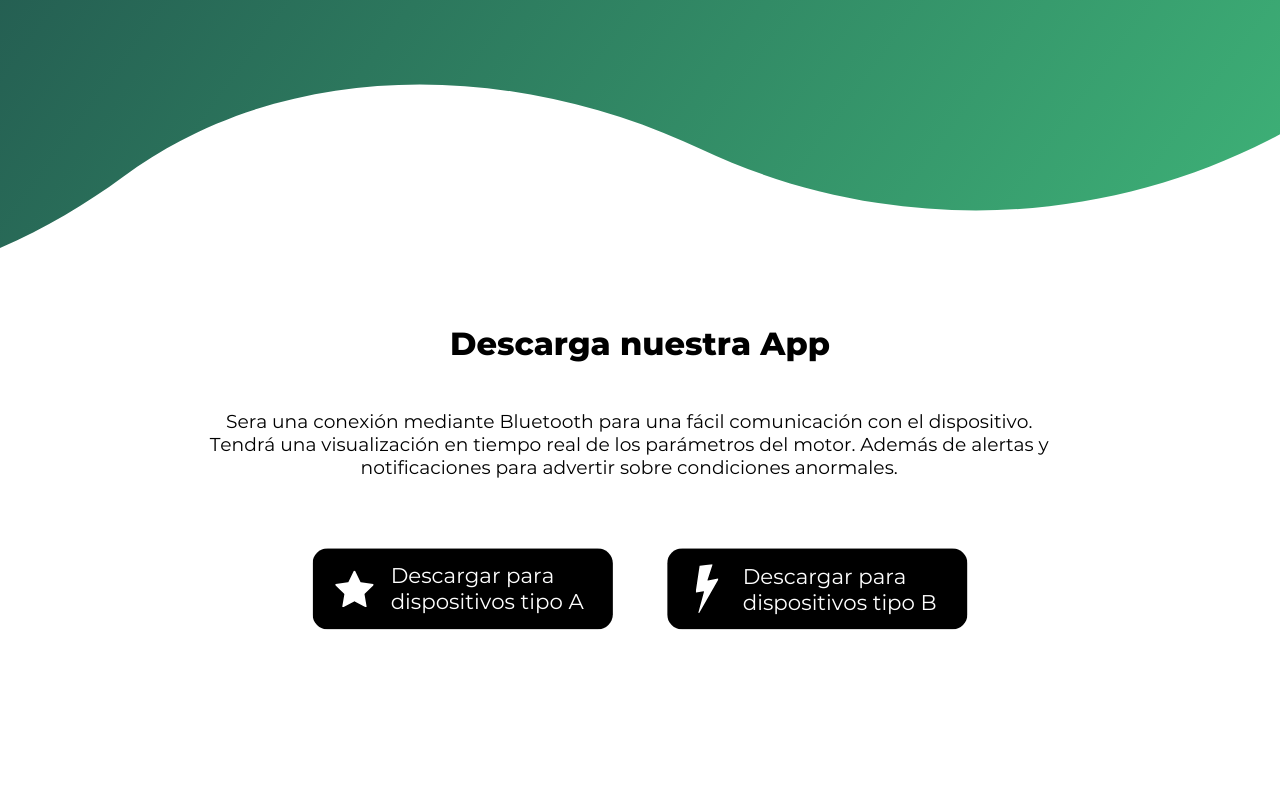
Pagina web/Concepto pagina/4.png
