impatrq/revcontrol/Pagina web/Concepto pagina/5.png

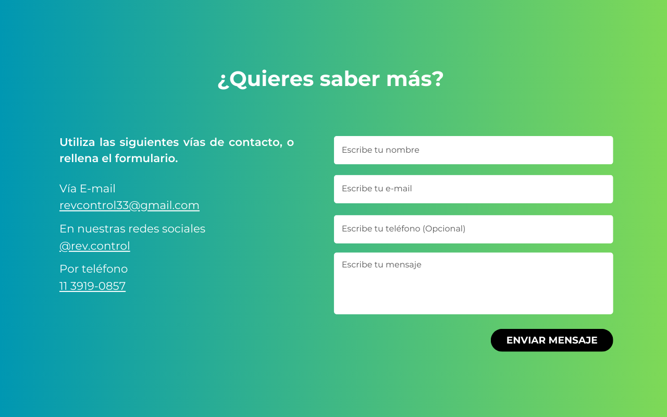
Pagina web/Concepto pagina/5.png
