impatrq/revcontrol/Pagina web/imagen.png

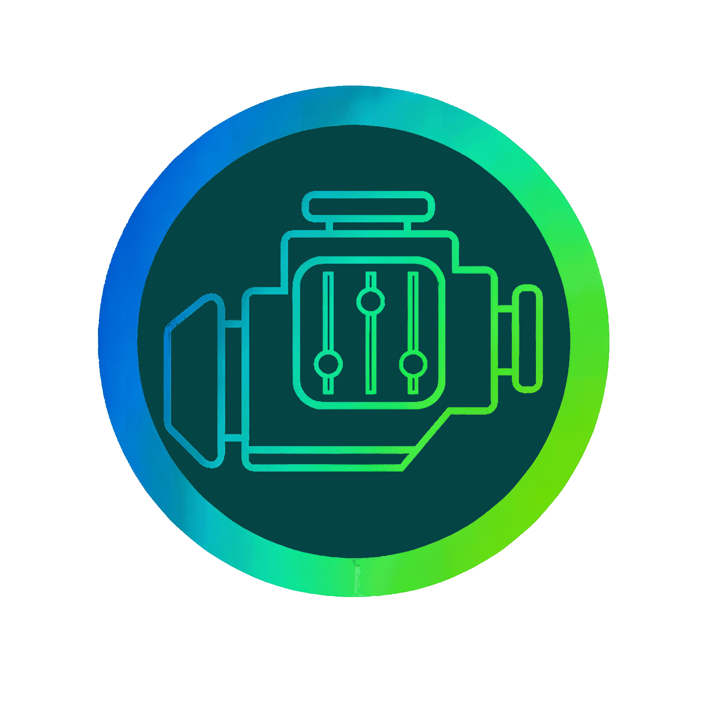
Pagina web/imagen.png
