impatrq/revcontrol/Pagina web/olas.png

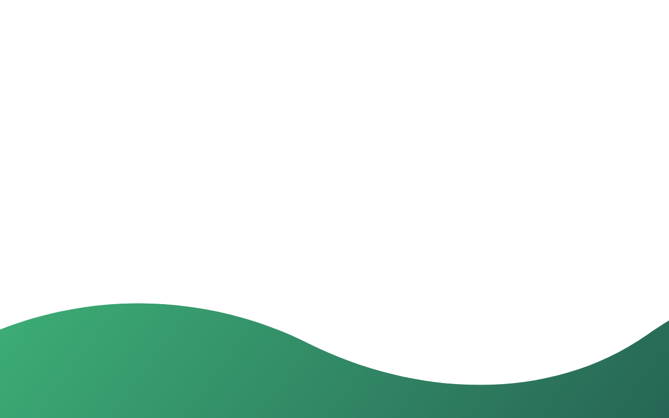
Pagina web/olas.png
