impatrq/revcontrol/Electronica/Esquemas y Modelo 3D Incluido/Tablas de conexiones/CONEXIONES SENSOR %O2.xlsx

Componente | Pin | Conexión
SONDA LAMBDA | +12V | Fuente de 12V
SONDA LAMBDA | GND | Tierra común
SONDA LAMBDA | SIGNAL + | Entrada positiva al pin +S del AD620
SONDA LAMBDA | SIGNAL - | Entrada negativa al pin -S del AD620
AD620 | VIN | +12V
AD620 | GND | Tierra común
AD620 | +S | Entrada positiva del sensor lambda
AD620 | -S | Entrada negativa del sensor lambda
AD620 | VOUT | Salida conectada a R2 (2.2MΩ)
R2 | 2.2MΩ | Conectado entre VOUT (AD620) y el pin no inversor (3) del LM358
C1 | 1µF | En paralelo con R2 y conectado entre pin 3 (LM358) y GND
U1: A (LM358) | Pin 3 (Entrada no inversora) | Salida de R2 y C1
U1: A (LM358) | Pin 2 (Entrada inversora) | Conectado al medio del divisor con RV1 (3.3KΩ)
U1: A (LM358) | Pin 1 (Salida) | Conectado a PIO0_06
U1: A (LM358) | VCC | +5V
U1: A (LM358) | GND | Tierra común
RV1 | 3.3KΩ | Ajuste de referencia conectado al divisor resistivo
PIO0_06 | Terminal | Salida del amplificador operacional LM358
