impatrq/revcontrol/(list of files, cad)

Other CAD files:
Estructura/Placa de acrilico/Plano placas de acrilico.dwg
