impatrq/revcontrol/Documentación/Descartado/Visualización vía Bluetooth/Prueba de Tablet para bluetooth.jpeg

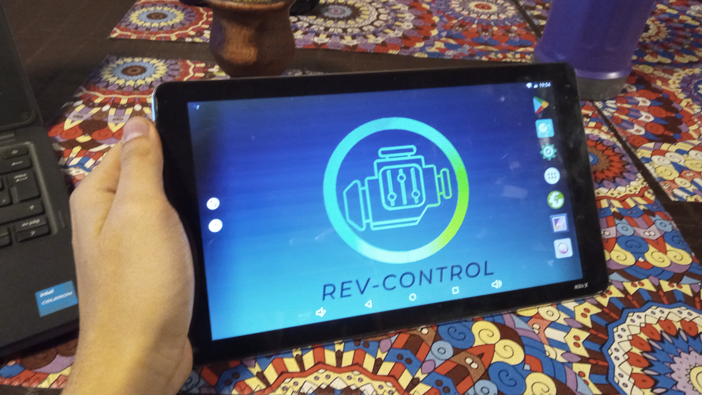
Documentación/Descartado/Visualización vía Bluetooth/Prueba de Tablet para bluetooth.jpeg
