impatrq/revcontrol/Electronica/Diagramas/Temperatura en función de la resistencia del termistor de agua y aceite del ROTAX 912 ULS probado con agua/Test de termistor con 2 testers.jpeg

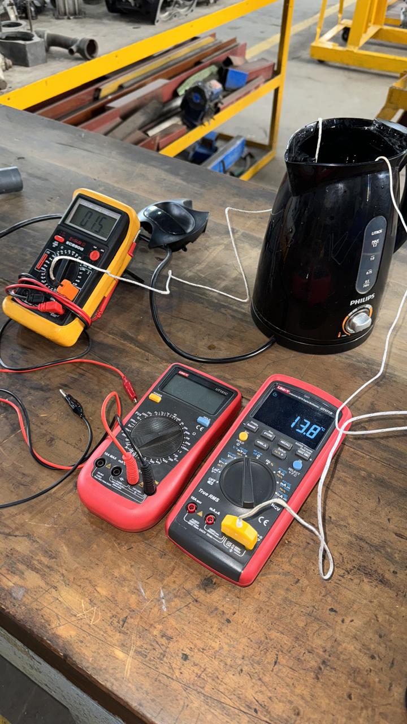
Electronica/Diagramas/Temperatura en función de la resistencia del termistor de agua y aceite del ROTAX 912 ULS probado con agua/Test de termistor con 2 testers.jpeg
