impatrq/revcontrol/Electronica/Diagramas/Temperatura en función de la resistencia del termistor de agua y aceite del ROTAX 912 ULS probado con agua/Grafico.pdf

## Gr´afico de la curva de temperatura en funci´on de la resistencia del termistor de agua y aceite

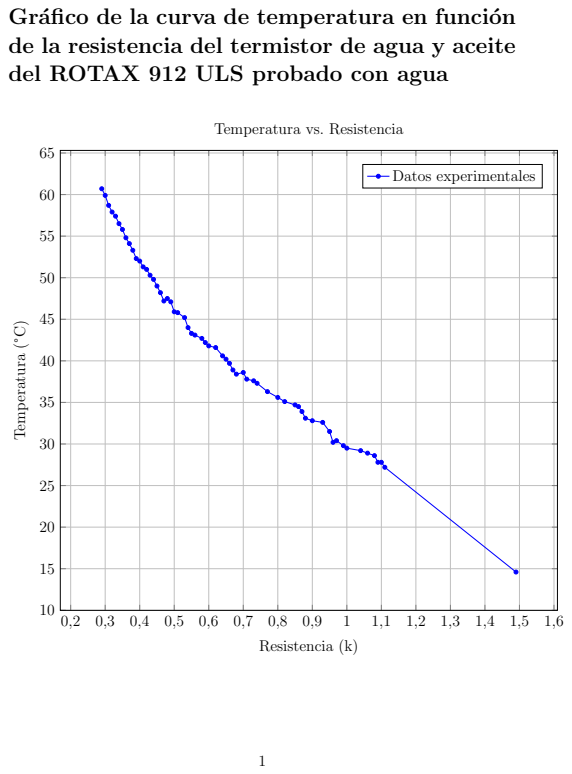
[picture p156: page 1]
Resistencia (k); Temperatura (°C); Datos experimentales

del ROTAX 912 ULS probado con agua

Temperatura vs. Resistencia
