impatrq/revcontrol/Electronica/Diseños PCB-PDFs/PLACA LPC REV-CONTROL.PDF

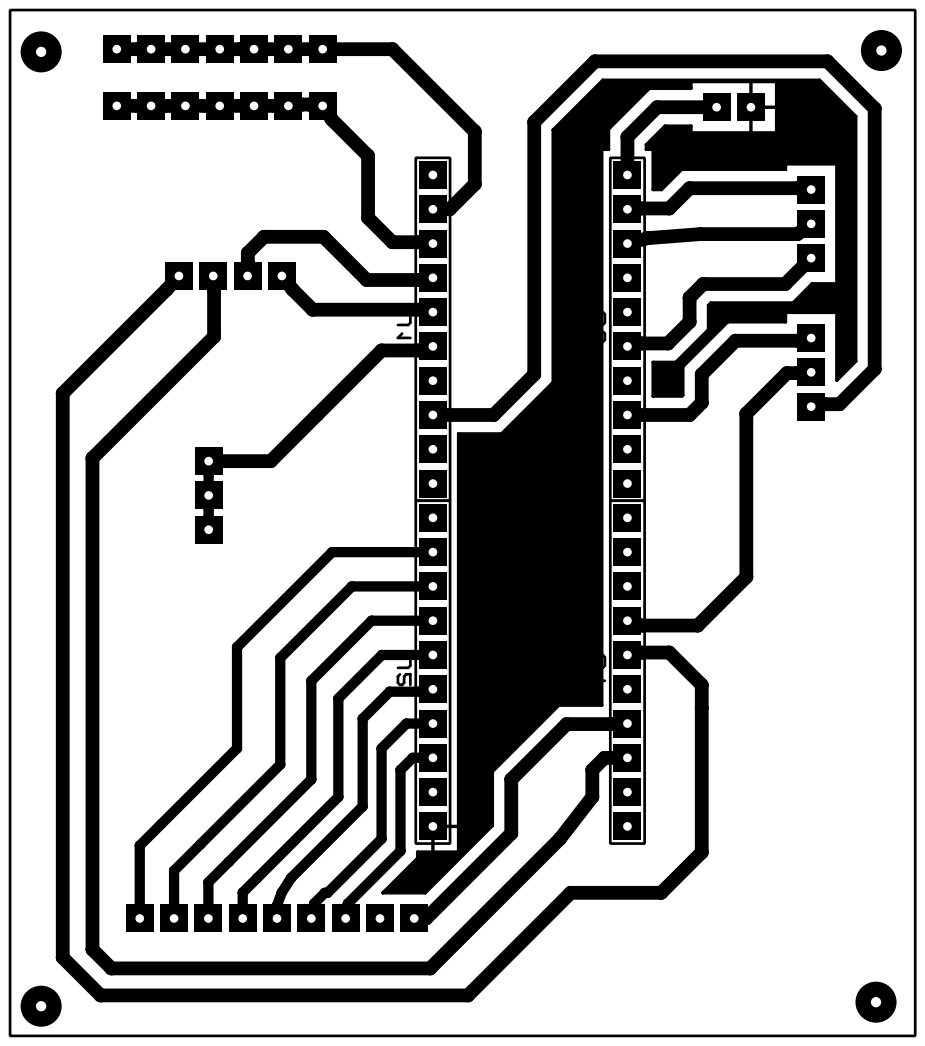
[picture p157: page 1]
