impatrq/revcontrol/Electronica/Circuitos/Rev-Control Version 2.6.2 Parte 1.PDF

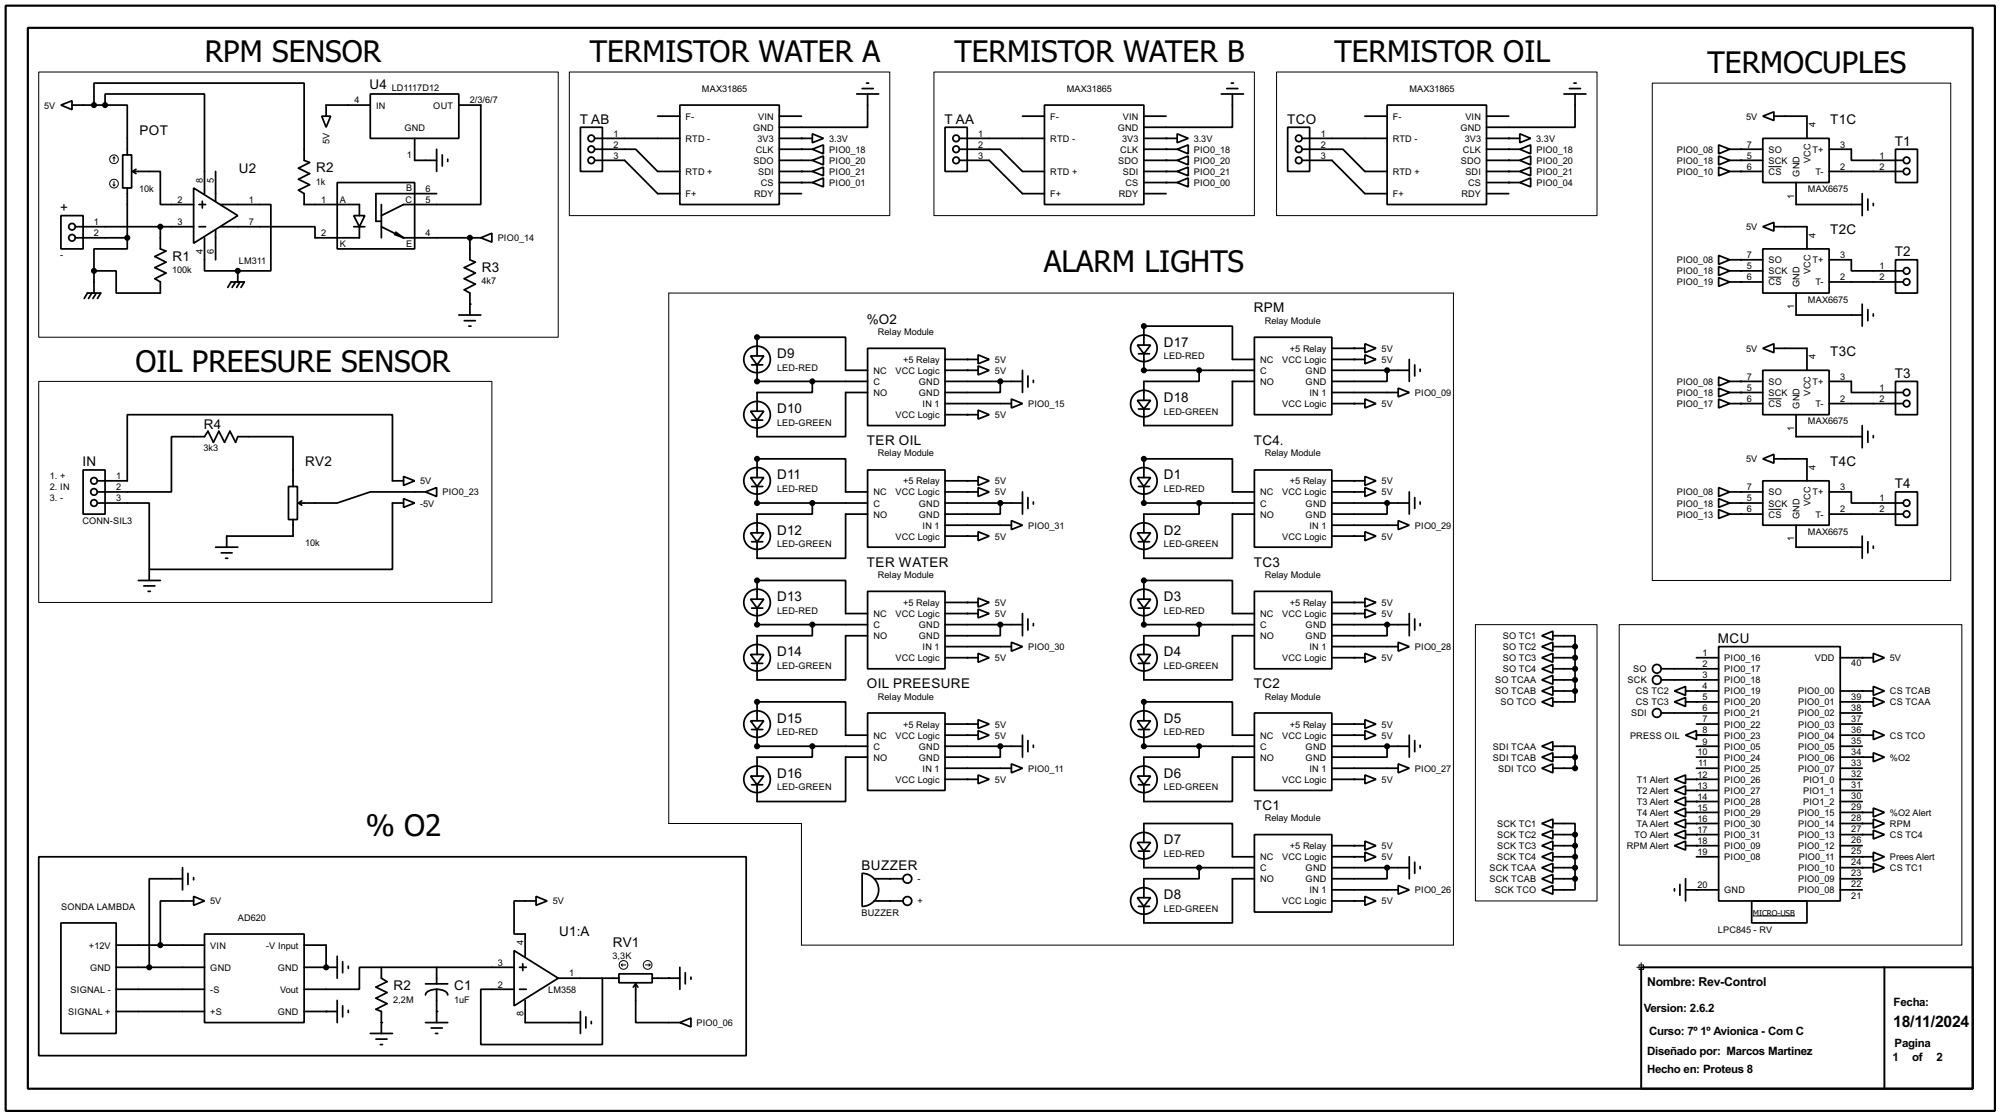
[picture p158: page 1]

SO TC1 SO TC2 SO TC3 SO TC4 SO TCAA

CS TCAB CS TCAA

SCK TC1 SCK TC2 SCK TC3 SCK TC4 SCK TCAA

Marcos Martinez Curso: 7º 1º Avionica - Com C
Diseñado por:
Hecho en: Proteus 8
