impatrq/revcontrol/Electronica/Diseños PCB-PDFs/ALARMAS REV-CONTROL.PDF

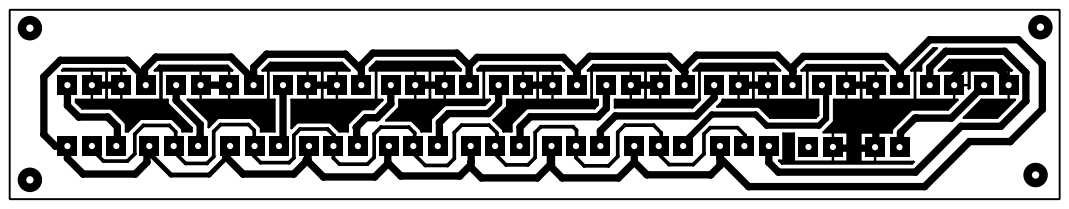
[picture p159: page 1]
