impatrq/revcontrol/Electronica/Diseños PCB-PDFs/COMPARADOR RPM REV-CONTROL.PDF

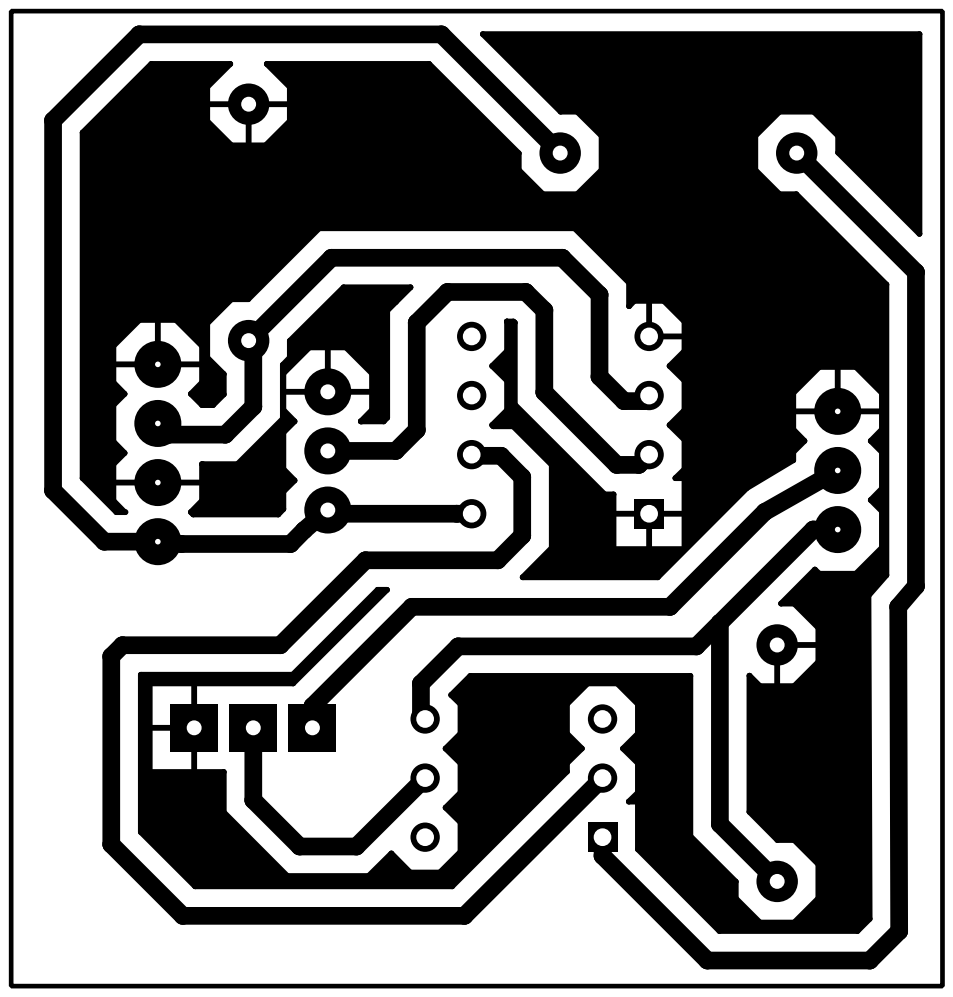
[picture p160: page 1]
