impatrq/revcontrol/Electronica/Diseños PCB-PDFs/DIVISOR DE VOLTAJE REV-CONTROL.PDF

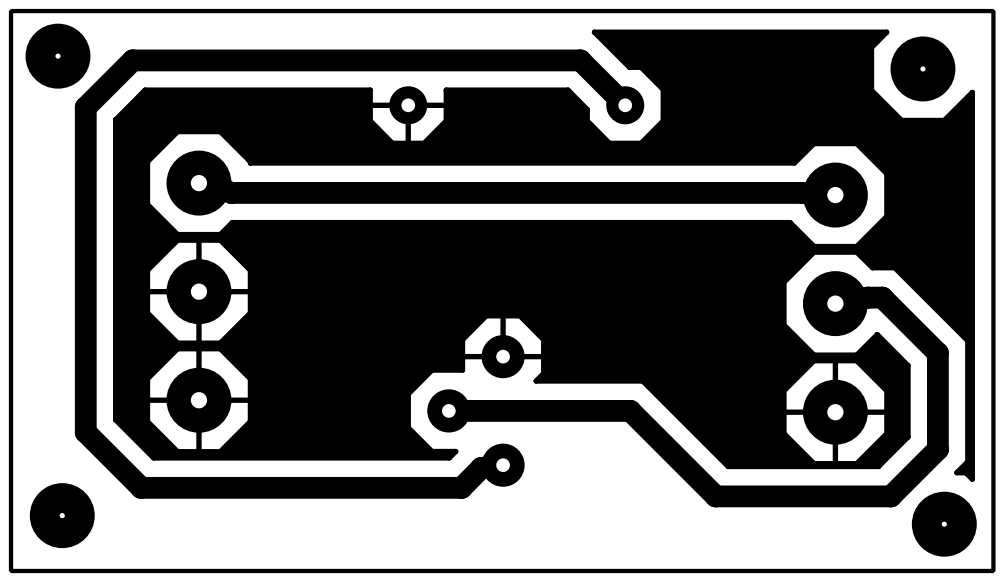
[picture p161: page 1]
