impatrq/revcontrol/Electronica/Diseños PCB-PDFs/ACONDICIONADOR DE SEÑAL ULTIMO MODELO - REVCONTROL.PDF

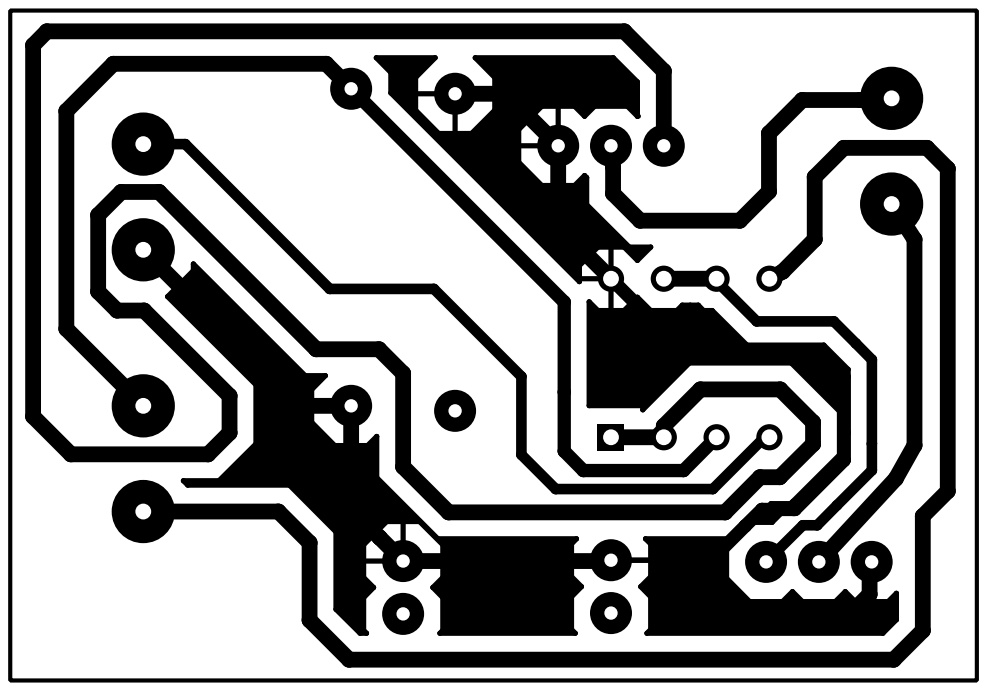
[picture p162: page 1]
