impatrq/revcontrol/Electronica/Diseños PCB-PDFs/AMPLIFICADOR AD620 - REVCONTROL.PDF

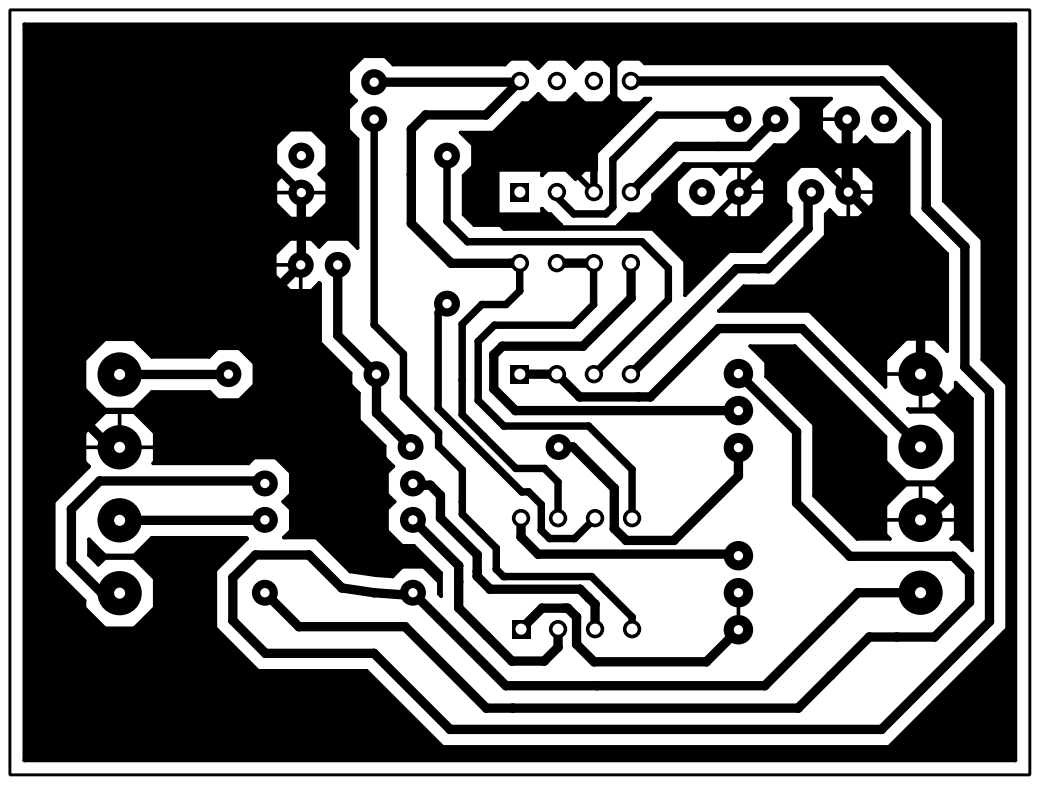
[picture p163: page 1]
