impatrq/revcontrol/Electronica/Circuitos/Rev- Control Version 2.4 Parte 1.PDF

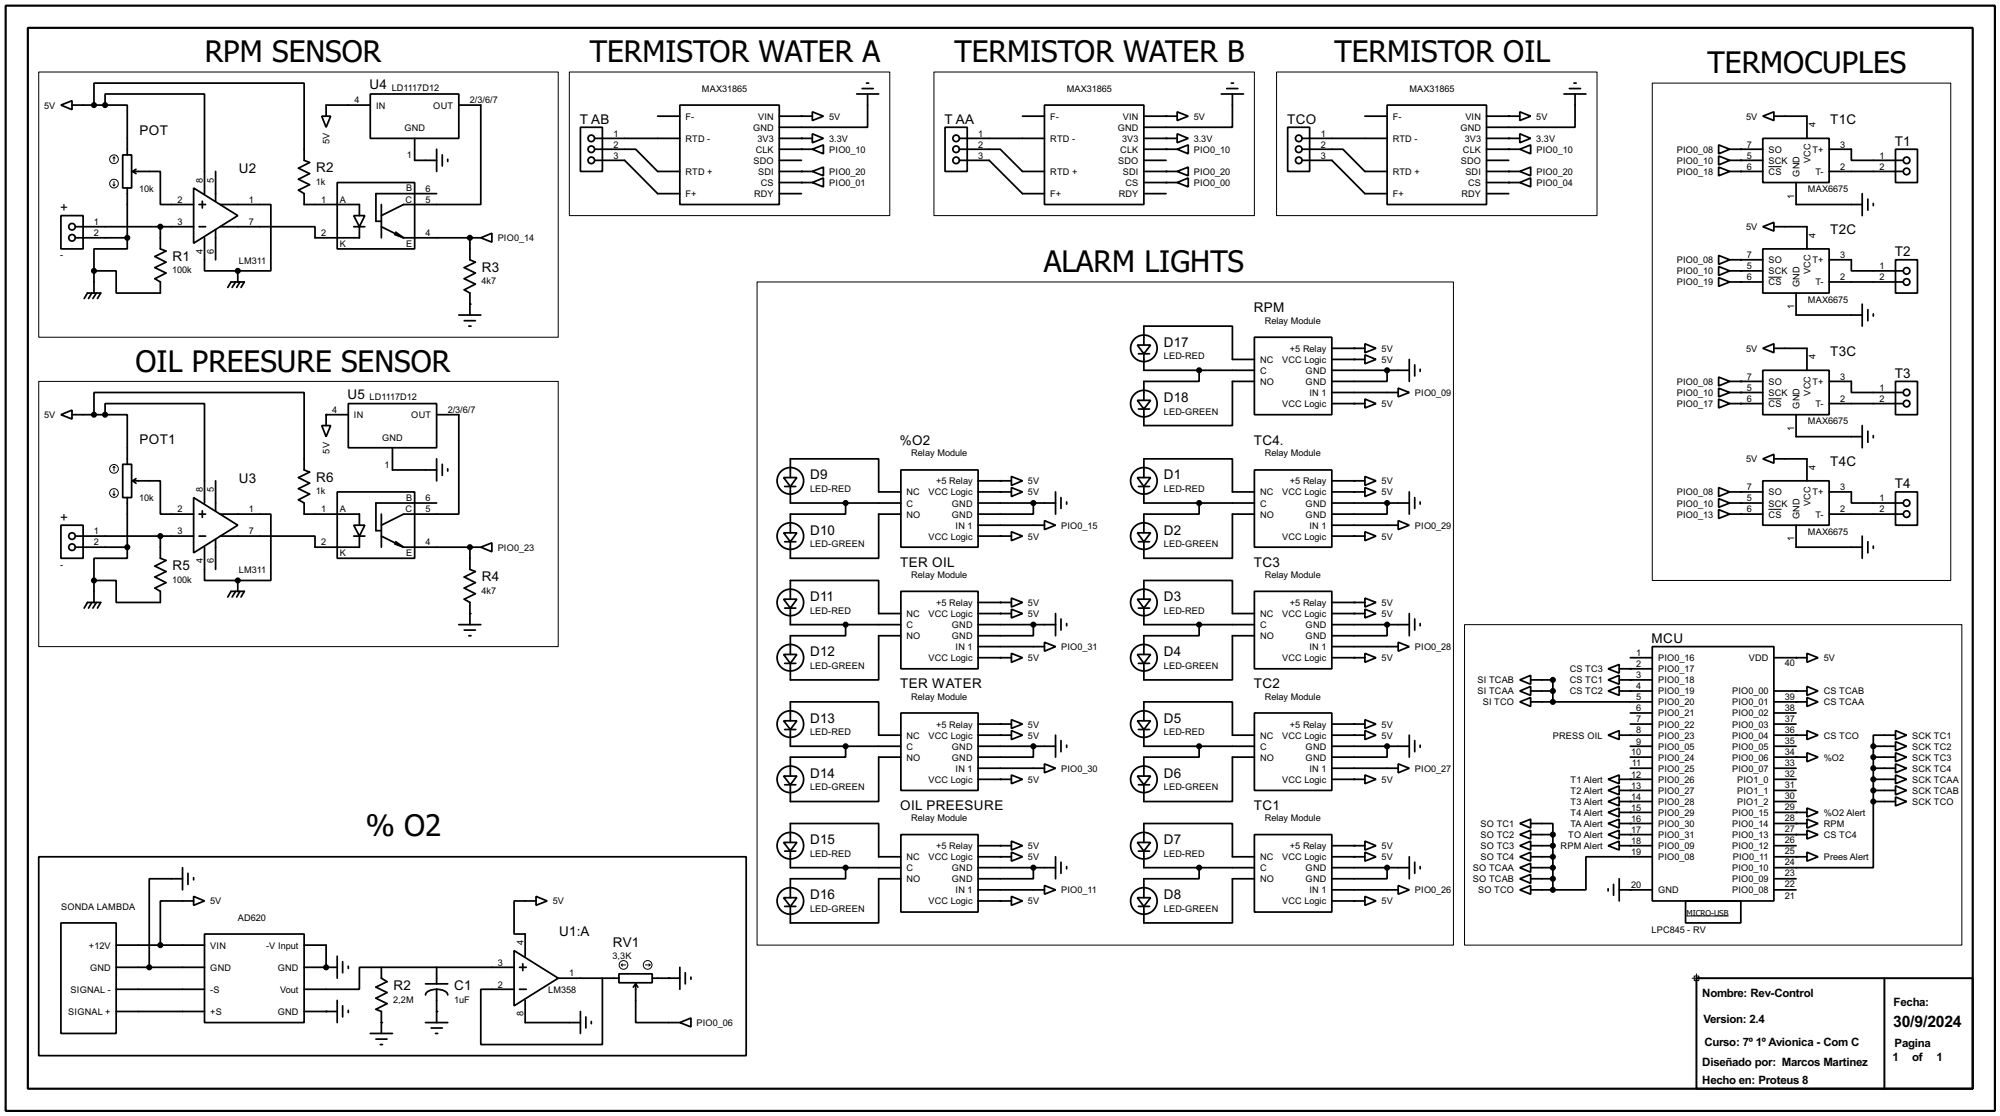
[picture p164: page 1]

CS TCAB CS TCAA

SCK TC1 SCK TC2 SCK TC3 SCK TC4 SCK TCAA

SO TC1 SO TC2 SO TC3 SO TC4 SO TCAA

Marcos Martinez Curso: 7º 1º Avionica - Com C
Diseñado por:
Hecho en: Proteus 8
