impatrq/revcontrol/Documentación/Documentación técnica/Carpeta Tecnica Oficial - RevControl 18-11-24/PCBS/LPC PCB.PDF

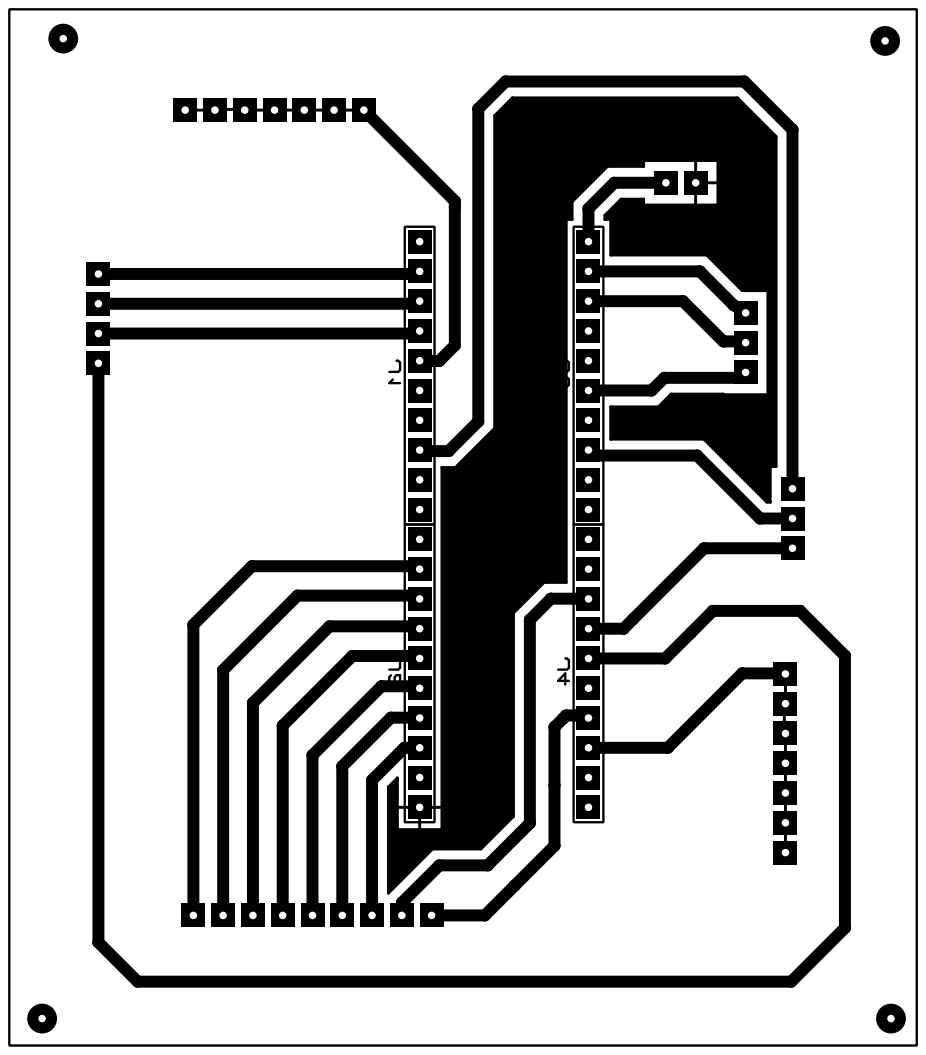
[picture p165: page 1]
