impatrq/revcontrol/(list of files, drawings)

Other design files:
Electronica/Esquemas y Modelo 3D Incluido/ACONDICIONADOR DE SEÑAL/Condicionador de Señal1.pdsprj
Electronica/Esquemas y Modelo 3D Incluido/AMPLIFICADOR AD620/Amplificador 620 13-10-24.pdsprj
Electronica/Esquemas y Modelo 3D Incluido/COMPARADOR DE RPM/Comparador para RPM.pdsprj
Electronica/Esquemas y Modelo 3D Incluido/DIVISOR DE VOLTAJE/Divisor de Voltaje (Presion de Aceite).pdsprj
