impatrq/revcontrol/(commit log)

2024-05-22 feat: agregar medidor temperatura
    Subo el código inicial para medir temperatura
2024-05-29 feat: agregar cálculo de temperatura
    Agregue el cálculo para pasar de tensión a temperatura al código inicial para leer el ADC.
2024-09-06 inicio de la pagina
    pagina web
2024-09-09 introduccion a la pagina de caracteristicas
2024-09-09 estilos de caracteristicas
2024-09-10 fix: lectura de ADC
2024-09-24 fix: Lectura de canales de ADC
2024-09-24 chore: cambie el nombre del archivo
2024-09-24 se cambiara de ubicacion los archivos
2024-09-24 se agrega la pagina de caracteristicas para el proyecto
2024-09-24 carpeta de estilos para caracteristicas
2024-09-24 pagina nosotros para presentacion
2024-10-07 fix: arreglo de canales de ADC
    Elimine los canales no usados y reasigne los otros.
2024-10-07 chore: renombre el archivo
2024-10-07 feat: agrego medicion por SPI
2024-10-07 feat: agrego delay a la lectura por SPI
2024-10-07 chore: cambie el nombre de la carpeta
    Ademas elimine cosas que no iban
2024-10-07 feat: agrego logos de RevControl
2024-10-10 feat: agrego lecturas por ADC y SPI
2024-10-14 fix: lectura por SPI
    [rev-control_spi.c]
2024-10-16 feat: agrego pines de Chip Select
2024-10-16 fix: arreglo de imagen
2024-10-17 fix: cambiar tamaño de imagen
2024-10-22 feat: diseño placa pcb
2024-10-22 feat: arreglo PCB
2024-10-22 fix: corrijo dimensiones de logotipo
2024-10-22 fix: cambio de gramatica
2024-10-24 fix: arreglo la imagen del logo
    Porque se veia deformada en dispositivos moviles
2024-10-24 feat: archivo de proteus#1
    [REV-CONTROL LPC PLACA.pdsprj]
2024-10-24 feat: archivo de proteus#2
    [Condicionador de Señal1.pdsprj]
2024-10-24 feat: archivo de proteus#3
2024-10-24 feat: archivo de proteus#4
    La version mas actualizada de este circuito es lost media debido a un error del programa, aquí esta la ultima version accesible de ese circuito
    [Amplificador 620 13-10-24.pdsprj]
2024-10-28 feat: agrego banner actualizado
    cambie las medidas y el formato
2024-10-29 feat: carpeta tenica 29-10
    Agrego la carpeta tecnica que aun esta sujeta a cambios
2024-10-29 fix: arreglo nuevo de la pagina
2024-10-29 feat: carpeta de campo 28-10
2024-11-18 feat: version 18/11/2024 de circuito general
2024-11-18 feat: nueva atualizacion de la carpeta de tecnica 18/11/24
2024-11-20 fix: lectura de termocuplas simultaneamente
    [rev-control_spi.c]
2024-11-20 feat: agrego medición de presión de aceite
2024-11-20 fix: corrijo valores de presion aceptables
    [rev-control_adc.c]
2024-11-21 feat: agrego medición de la sonda lambda
2024-11-21 fix: Ultima actualizacion de la carpeta tecnica
    Lista para imprimir
    [rev-control_adc.c, rev-control_spi.c]
2024-11-21 fix: arreglo medicion de presion y lambda
    [rev-control_adc.c]
2024-11-25 feat: agrego alertas de las termocuplas
2024-11-25 fix: arreglo alertas de O2 y presion
    [rev-control_adc.c]
2024-11-25 fix: arreglo alertas de las termocuplas
    [rev-control_spi.c]
2024-11-25 fix: inicializacion de pines de termocuplas
    [rev-control_spi.c]
2024-11-26 feat: concepto de pagina web
2024-11-26 feat: carpeta de campo y manual de usuario terminados
2024-11-27 fix: agregue facturas
    Agregue las facturas a la carpeta de campo
2024-11-27 feat: planilla de compras
2024-11-27 feat: Diagrama de sensor de temperatura
2024-11-27 feat: agrego Curriculums de integrantes
2024-11-27 mejoras
    sea agrega los cambios definitivos, junto a una imagen en el index
2024-11-27 resolucion
    se resuelve el conflicto
2024-11-27 reslucion de comfictos
2024-11-27 feat: plano de acrilico
    [Plano Placa de acrilico.dwg]
2024-11-27 feat: anterior modelo de caja
2024-11-27 feat: Modelo viejo de caja
2024-11-27 fix: arreglo conversión de canales de ADC
    [rev-control_adc.c]
2024-11-27 feat: Diagrama presión de aceite
2024-11-27 fix: Calculo de ADC de sonda lambda y presión
    [rev-control_adc.c]
2024-11-27 feat: agrego funcionalidad de RTOS a Rev-Control
2024-11-28 fix: agregue y arregle diseños PCBs
2024-11-28 feat: actualizacion de PCBs
    Durante este proceso hicimos cambios en los diseños PCB y agregamos PCBs que no estaban incluidos previamente
    [Comparador para RPM.pdsprj, Divisor de Voltaje (Presion de Aceite).pdsprj, REV-CONTROL LPC PLACA.pdsprj]
2024-11-28 feat: agrego elementos de alcance inconcluso
2024-11-28 actualizacion
    se actualiza el software del monitor, donde se acomodan un poco mas los visuales y se extiende la duracion del tiempo encendido, antes de entrar en modo de ahorro
2024-11-29 feat: agrego video de presentación final
2024-11-29 fix: arreglo nombre de Diagram de bloques
2024-11-29 feat: Plano de maletín
    17/04
2024-11-29 fix: Cambio nombre de plano
2024-11-29 feat: agrego placa pcb de divisor de voltaje finalizada
2024-11-29 feat: agrego placa pcb lpc finalizada
2024-11-29 feat: placa de alertas
2024-11-29 feat: Placa acondicionador de señal fisica
2024-11-29 feat: agrego ojos de buey utilizados para las alertas visuales
2024-11-29 feat: Agrego buzzer utilizado para alertas sonoras
2024-11-29 feat: agrego conexiones de sensores en el modulo de lectura
2024-11-29 feat: Carretel para sensor de rpm
    06/11
2024-11-29 feat: Soportes para las placas para los acrilicos
    Del 06/11 al al 14/11. Se tuvieron que hacer 40 soportes
2024-11-29 feat: Prototipo que iba a usarse para sensar RPM
    10/10 a 22/10
2024-11-29 feat: planos de acrílico
2024-11-29 feat: Prototipo de soportes
2024-11-30 feat: Soporte para monitor
    15/11 a 21/11
2024-11-30 Fijación a soporte para más estabilidad
    22/11
2024-11-30 feat: Colocación de placas en acrilicos
2024-11-30 feat: Guion de la presentación 1
2024-11-30 feat: Guion de presentación 1
2024-11-30 feat: colocación de alertas, indicador, switch y comunicacor con el monitor
2024-11-30 feat: Guion de presentación 2
2024-11-30 feat: Guion de presentación 3
2024-11-30 feat: Guion de presentación 4
2024-11-30 feat: Guion de presentación 5
2024-11-30 feat: Etiquetas para alarmas y especificaciones
2024-11-30 feat: Modulo de lectura finalizado con especificaciones
2024-11-30 feat: Hecha la comunicación con el Monitor y los pines de TX y RX del LPC
2024-11-30 feat: pruebas en tablet para la conexión vía Bluetooth
    06/08
2024-11-30 feat: Pruebas en Appinventor, no funcionaba el wifi de la tablet
    10/10
2024-11-30 Revert "feat: Pruebas en Appinventor, no funcionaba el wifi de la tablet"
    This reverts commit c35bc89cc5556dbc2518697963db24eccf1df28e.
2024-11-30 feat: Pruebas en Appinventor, errores en wifi de la tablet
    10/08
2024-11-30 fix: agrego el diagrama del bluetooth a la carpeta de descarte
2024-11-30 fix: cambio el prototipo del sensor de RPM a la carpeta de descartes
2024-12-02 programas de prueba
    se añade programas de pruebas del monitor.
2024-12-02 feat: Grafico de Termistor del ROTAX 912 ULS
    02/09
2024-12-02 feat: Test de termistor con 2 testers
    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
2024-12-04 feat: Plano placas de acrilico AutoCad
    [Plano placas de acrilico.dwg]
2024-12-04 feat: Medidas placas de acrilico (Imagen)
2024-12-04 feat: Placas de acrilico (medidas)
2024-12-04 documentos
    documentacion en pdf del monitor kinseal y el protocolo modbus
2024-12-05 feat: Vista frontal placa de acrilico
2024-12-05 feat: vista superior placa de acrilico
2024-12-06 feat: Huecos en acrilicos
    Se hicieron huecos para mayor orden dentro de la caja
2024-12-06 feat: soldadura en pines de los sensores
2024-12-06 feat: agrego identificación de cables en alarmas visuales
2024-12-06 se agrega la aplicacion terminal
    se agrega la aplicacion terminal para pruebas
2024-12-06 informe del monitor
    se agrega el informe del monitor, su software y su comunicacion
2024-12-12 feat: agrego conexiones del snsor de rpm
    [CONEXIONES SENSOR RPM.xlsx]
2024-12-12 feat: agrego tabla de conexiones del sensor de aceite
    [CONEXIONES SENSOR DE PRESION DE ACEITE.xlsx]
2024-12-12 feat: agrego placa del sensor de oxigeno
    [CONEXIONES SENSOR %O2.xlsx]
2024-12-12 fix: ordeno carpetas
    [Plano placas de acrilico.dwg]
2024-12-13 feat: Conexiones del LPC845
    [Conexiones LPC845.xlsx]
2024-12-13 feat: Conexiones Termocuplas
    [Conexiones de Termocuplas.xlsx]
2024-12-13 feat: Conexiones de los termistores
    [Conexiones de Termistores.xlsx]
2024-12-13 alineacion de imagenes
    se alinea las imagenes del readme
2024-12-13 Imagenes
    se sube el resto de las imagenes
2024-12-13 cambios en el main
    se borra la carpeta de imagen. para su ajuste
2024-12-13 Imagenes
    Se rehace la carpeta de imagenes
2024-12-13 readme
    se ajusta el readme
2024-12-13 feat: agrego Roles de integrantes
2024-12-13 feat: colocacion placas de acrilico
