impatrq/revcontrol/Documentación/Descartado/Prototipo de sensor de RPM/Carretel Rpm finalizado.jpg

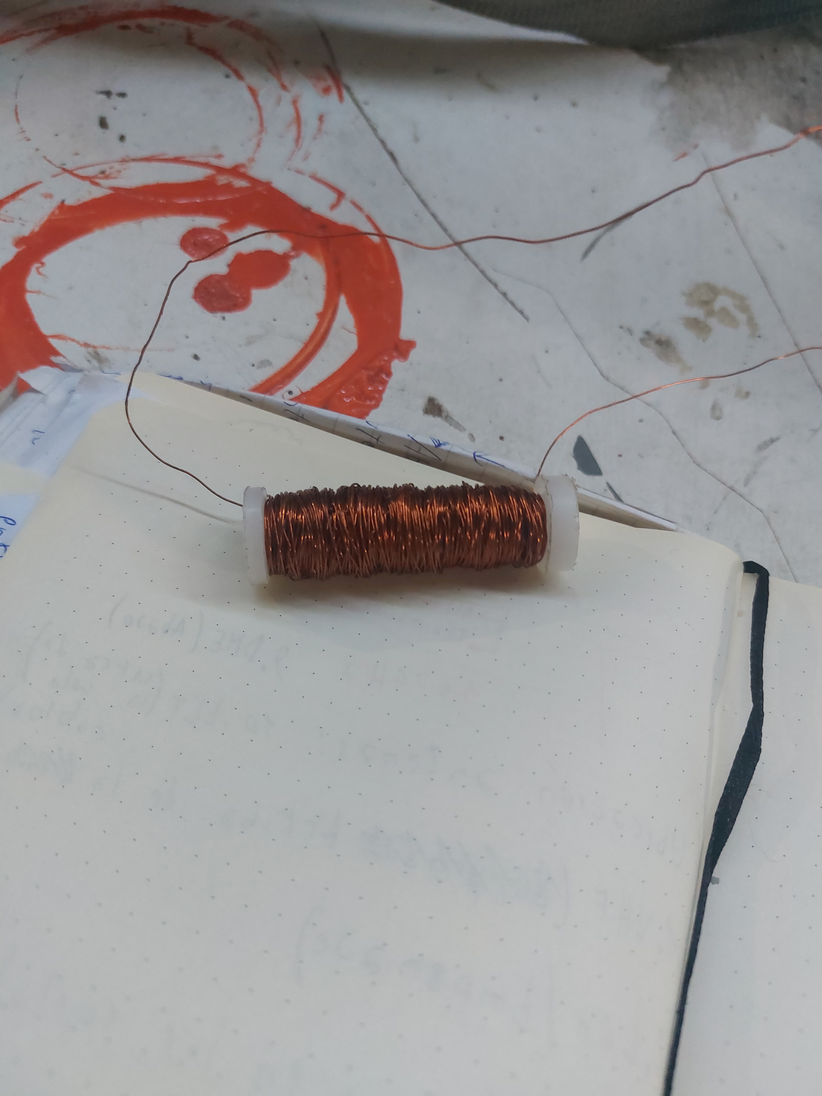
Documentación/Descartado/Prototipo de sensor de RPM/Carretel Rpm finalizado.jpg
