impatrq/revcontrol/Documentación/Descartado/Prototipo de sensor de RPM/Plano Carretel/20241022_092258 (1).jpg

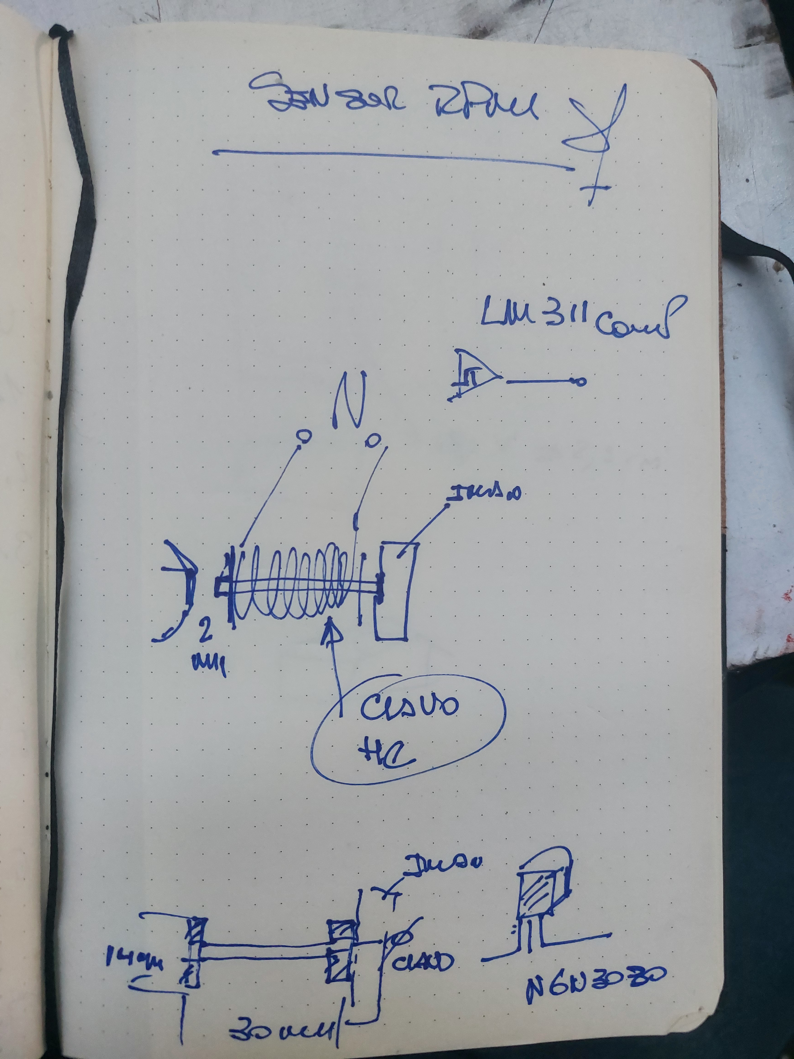
Documentación/Descartado/Prototipo de sensor de RPM/Plano Carretel/20241022_092258 (1).jpg
