impatrq/revcontrol/Estructura/Modulo de lectura/Modulo de lectura.jpg

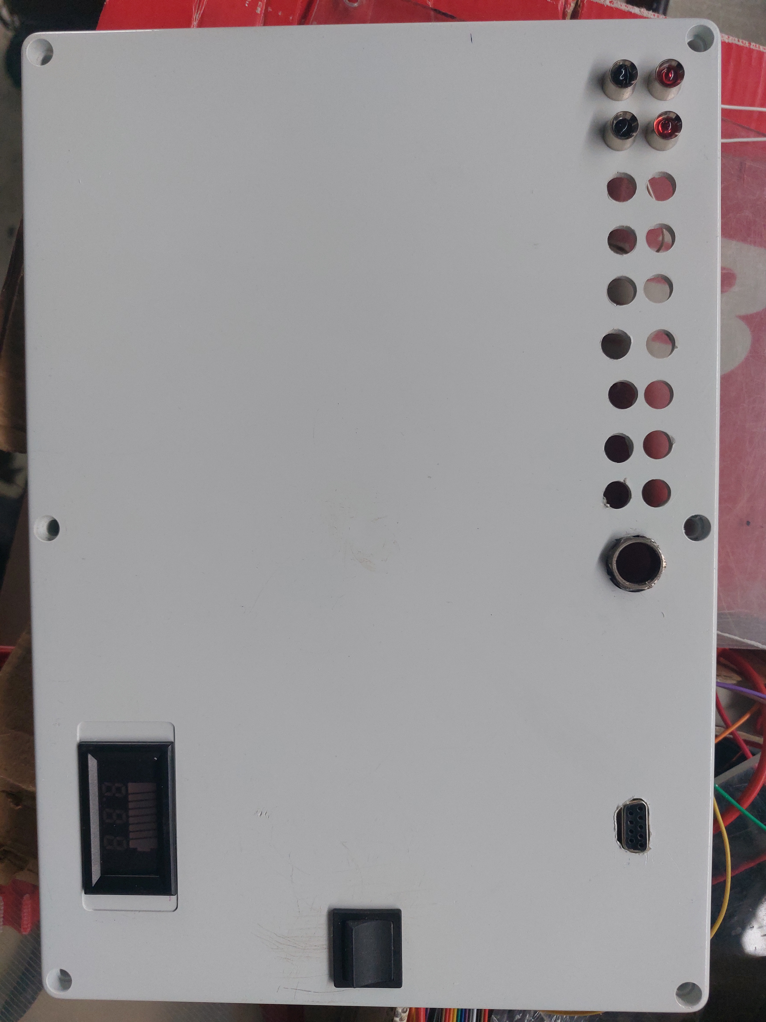
Estructura/Modulo de lectura/Modulo de lectura.jpg
